Brunoxd23/Flatburn-BR/documentation/static/files/facilitator/workshop_slides.pdf

# City Scanner Workshop

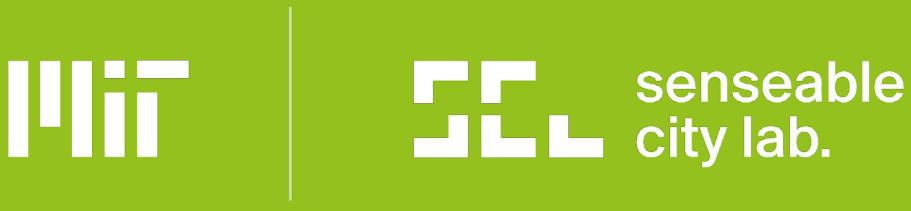
[picture p1: figure]

# Workshop Agenda + Goals

# Agenda

# - CityScanner Recap - Historical + environmental use case context on The Bronx - Analysis + Coding activities

# Goals

# - Understanding hyperlocal air quality sensing - Perform time series + hotspot analysis - Make maps with data

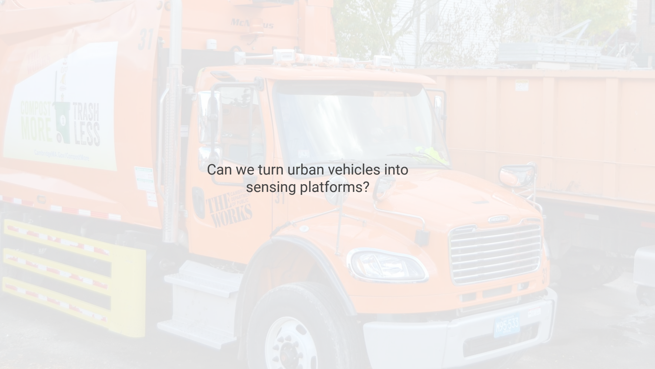
[picture p2: page 3]

# Can we turn urban vehicles into sensing platforms?

# City Scanner

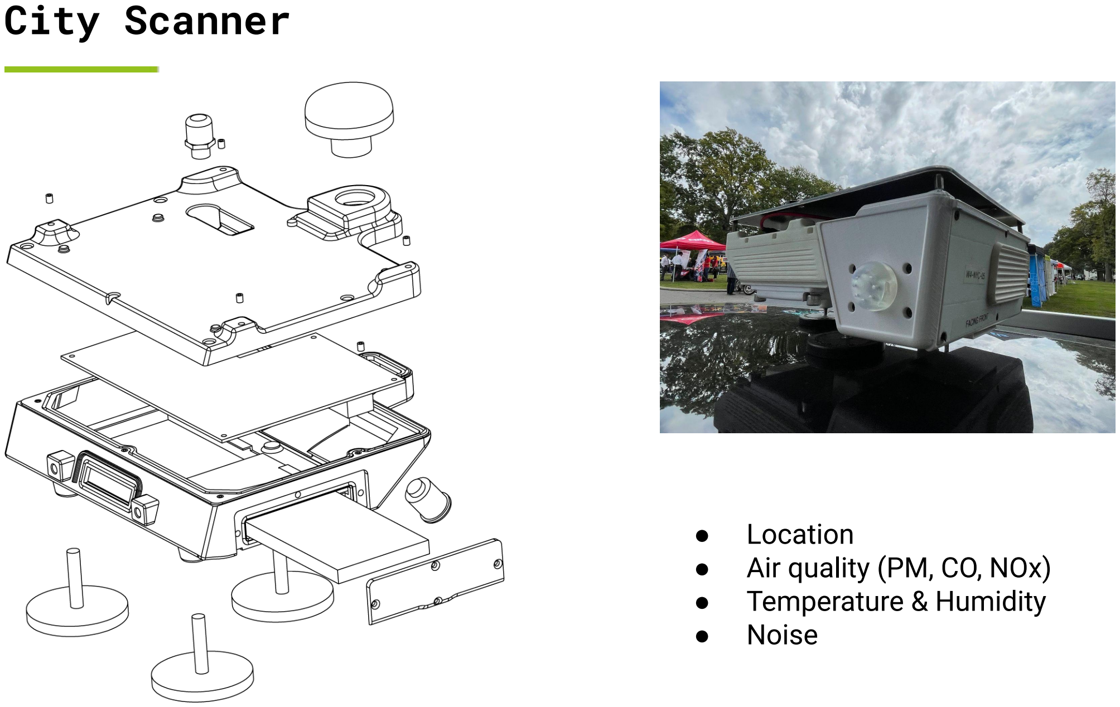
[picture p3: page 4]

# - Location - Air quality (PM, CO, NOx) - Temperature & Humidity - Noise

# Stationary vs. Mobile Sensors

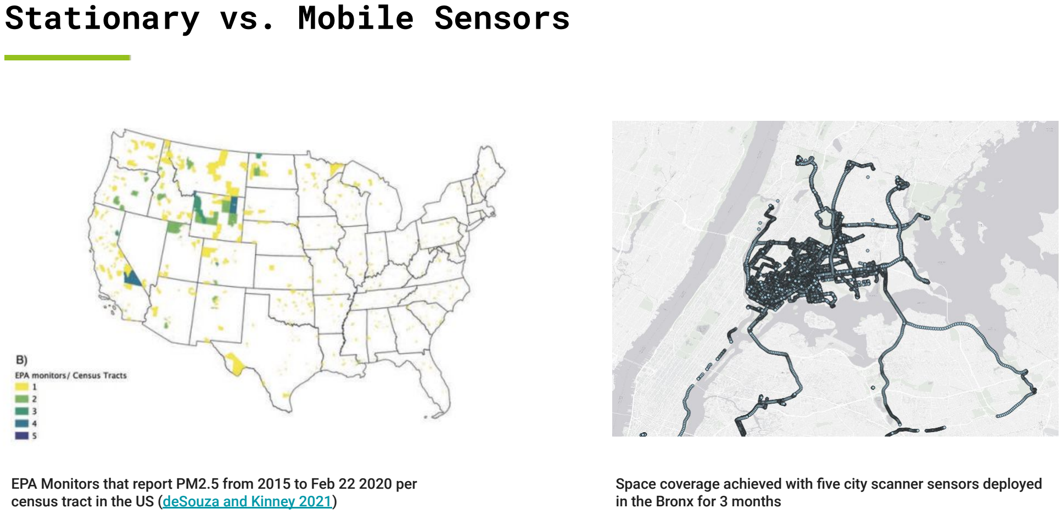
[picture p4: page 5]

## EPA Monitors that report PM2.5 from 2015 to Feb 22 2020 per

census tract in the US (deSouza and Kinney 2021) (https://www.nature.com/articles/s41370-021-00328-2)

## Space coverage achieved with five city scanner sensors deployed in the Bronx for 3 months

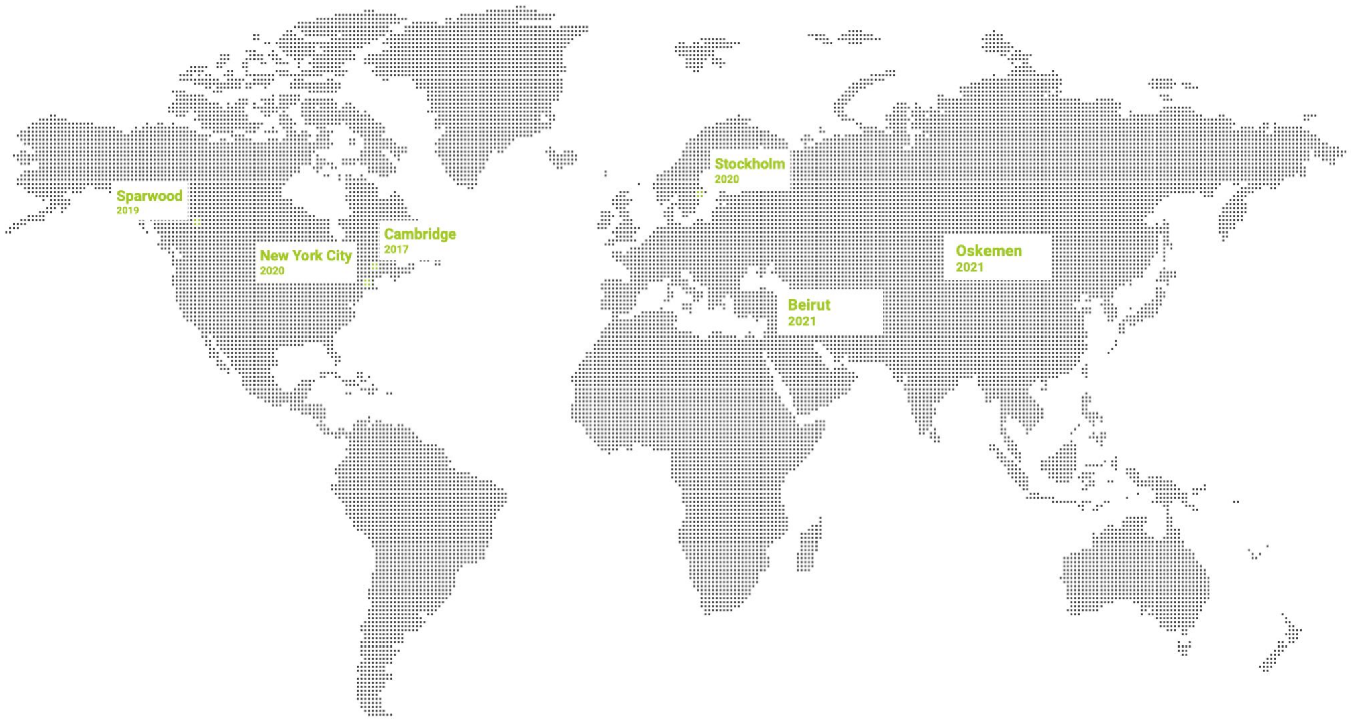
[picture p5: page 6]

# Environmental Sensing

# Context + Background

# ENVIRONMENTAL SENSING 101

# What information can we gather

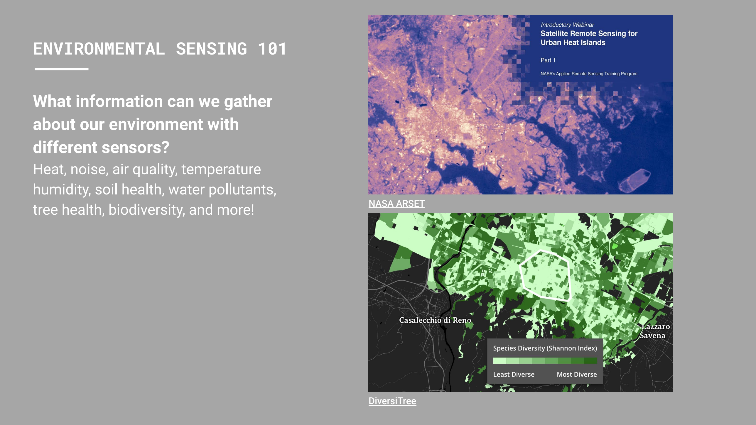
[picture p6: page 8]

# about our environment with different sensors?

# Heat, noise, air quality, temperature

humidity, soil health, water pollutants,
tree health, biodiversity, and more! | NASA ARSET (https://www.youtube.com/watch?v=KYV2j3kwj2A&ab_channel=NASAVideo)

## DiversiTree (https://senseable.mit.edu/diversitree/)

# Environmental Sensing: Heat, Noise, Air Quality

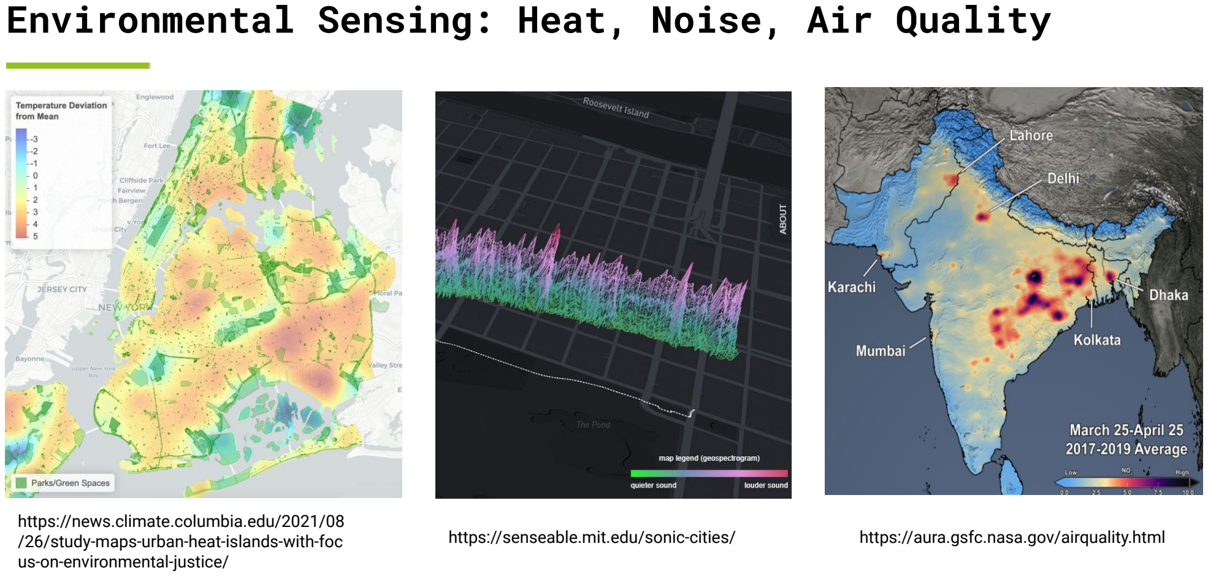
[picture p7: page 9]

## https://news.climate.columbia.edu/2021/08 /26/study-maps-urban-heat-islands-with-foc us-on-environmental-justice/

https://senseable.mit.edu/sonic-cities/ | https://aura.gsfc.nasa.gov/airquality.html

# Air Quality Sensing: Why?

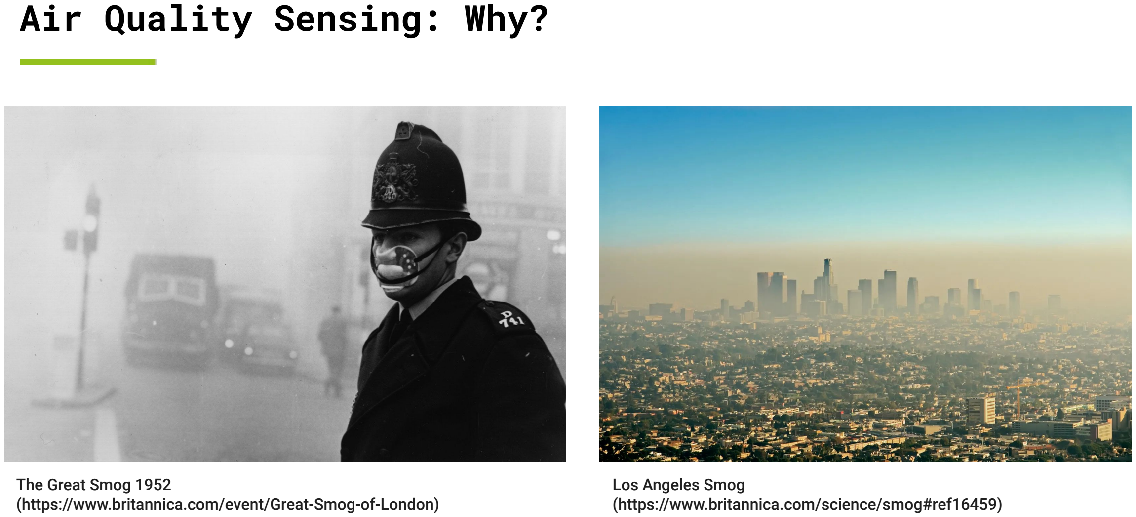
[picture p8: page 10]

## The Great Smog 1952 (https://www.britannica.com/event/Great-Smog-of-London)

## Los Angeles Smog (https://www.britannica.com/science/smog#ref16459)

# Air Quality Sensing: Why?

# 4.2 million per year vs. 6.2 million

# 91% of world population lives in places exceeding WHO AQ Standards

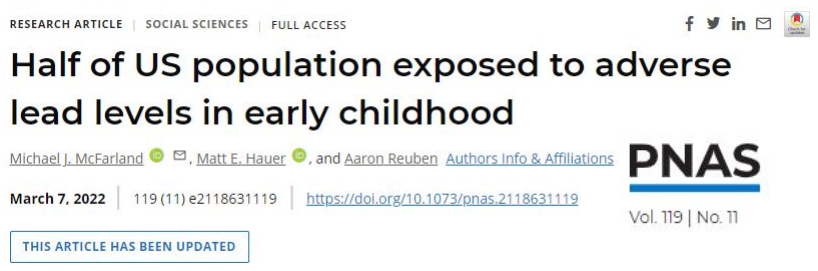
[picture p9: figure]

# Air Quality Index: Pollutants

# Six criteria pollutants regulated by EPA

# - Ground-level ozone - Particulate matter - Carbon monoxide - Lead - Sulfur dioxide - Nitrogen dioxide

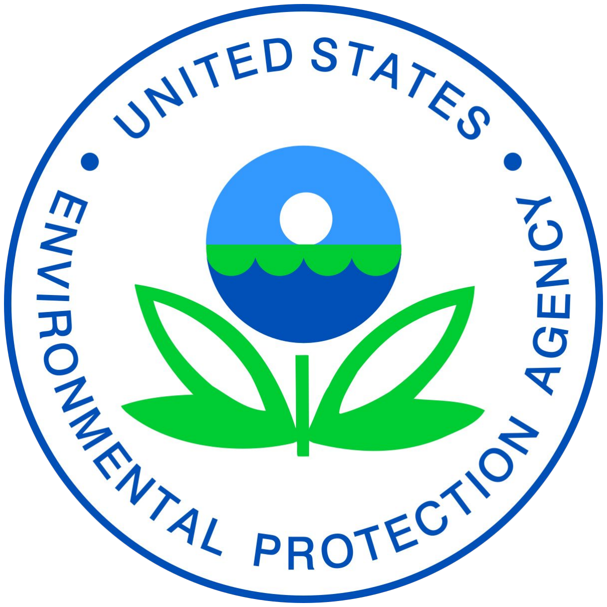
[picture p10: figure]

## United States Environmental Protection Agency (https://www.epa.gov/)

# Air Quality Index: Pollutants

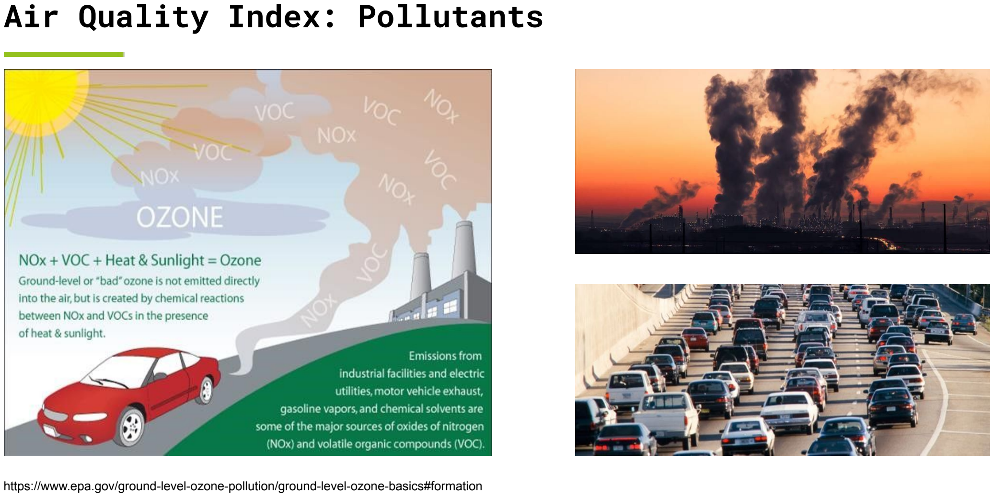
[picture p11: page 13]

### https://www.epa.gov/ground-level-ozone-pollution/ground-level-ozone-basics#formation

# Air Quality Index: PM and NO2

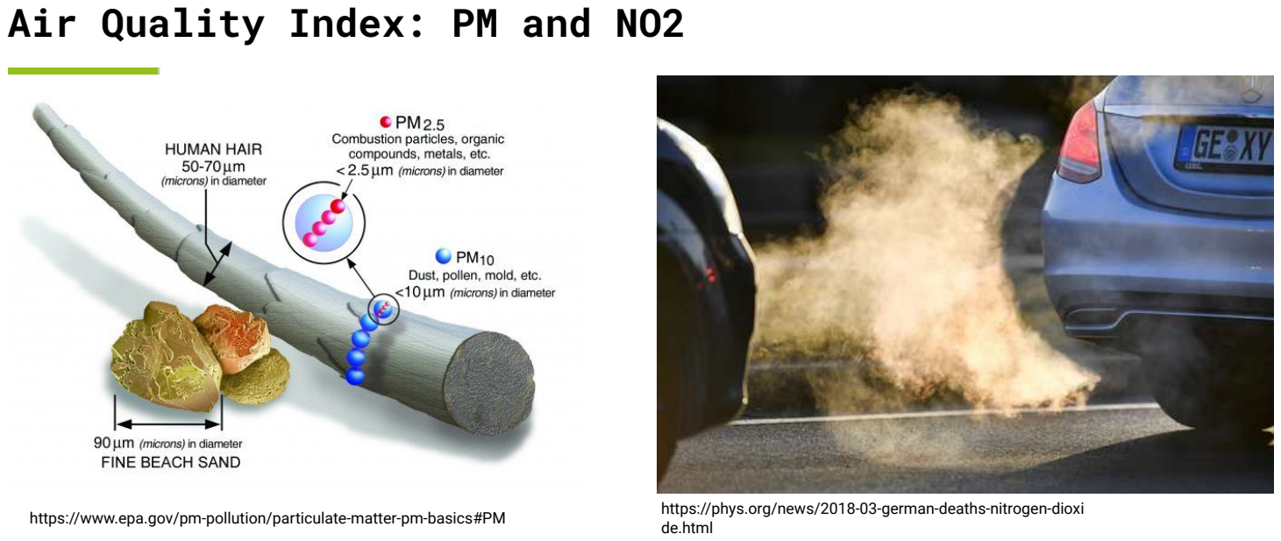
[picture p12: page 14]

https://www.epa.gov/pm-pollution/particulate-matter-pm-basics#PM | https://phys.org/news/2018-03-german-deaths-nitrogen-dioxi de.html

# World Health Organization Guidelines

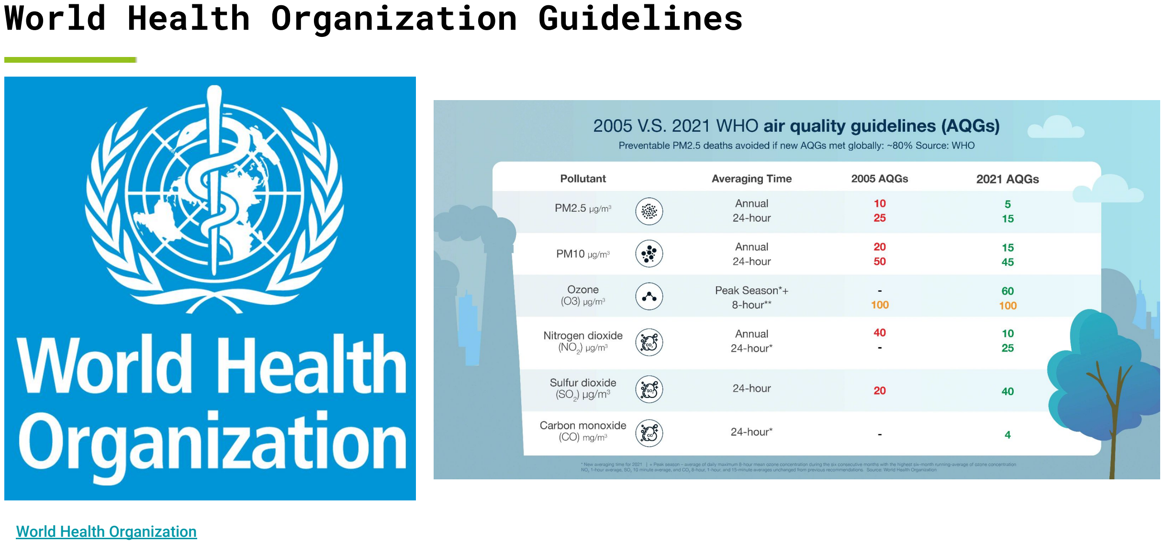
[picture p13: page 15]

## World Health Organization (https://www.who.int/)

# Air Quality Index

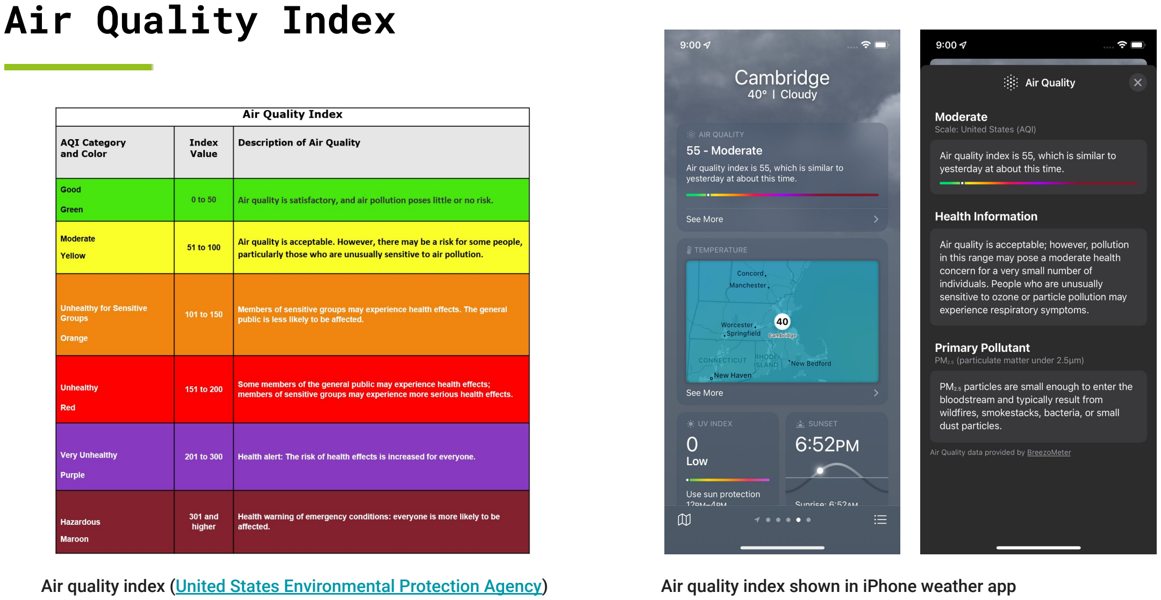
[picture p14: page 16]

Air quality index (United States Environmental Protection Agency) (https://www.epa.gov/wildfire-smoke-course/wildfire-smoke-and-your-patients-health-air-quality-index) | Air quality index shown in iPhone weather app

# The Bronx

# Historical + Environmental Context

# The Bronx: Overview + Demographics

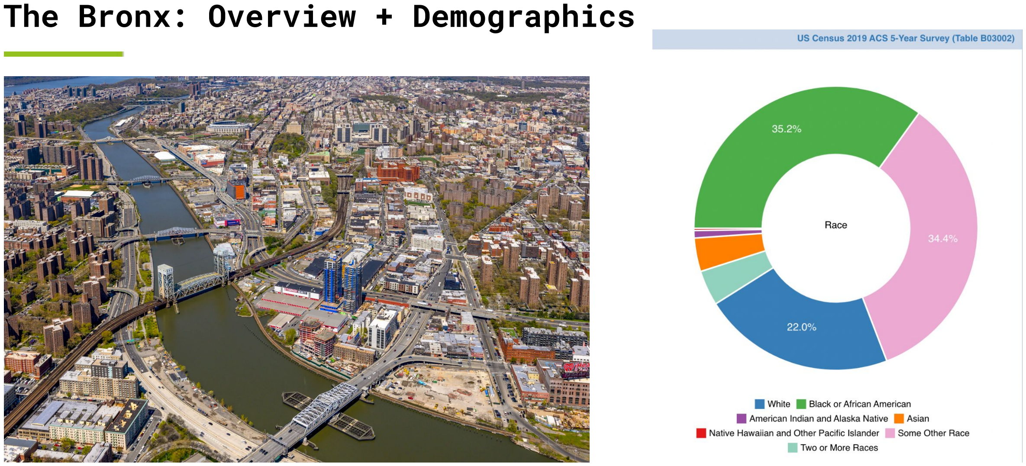
[picture p15: page 18]

# The Bronx: Context

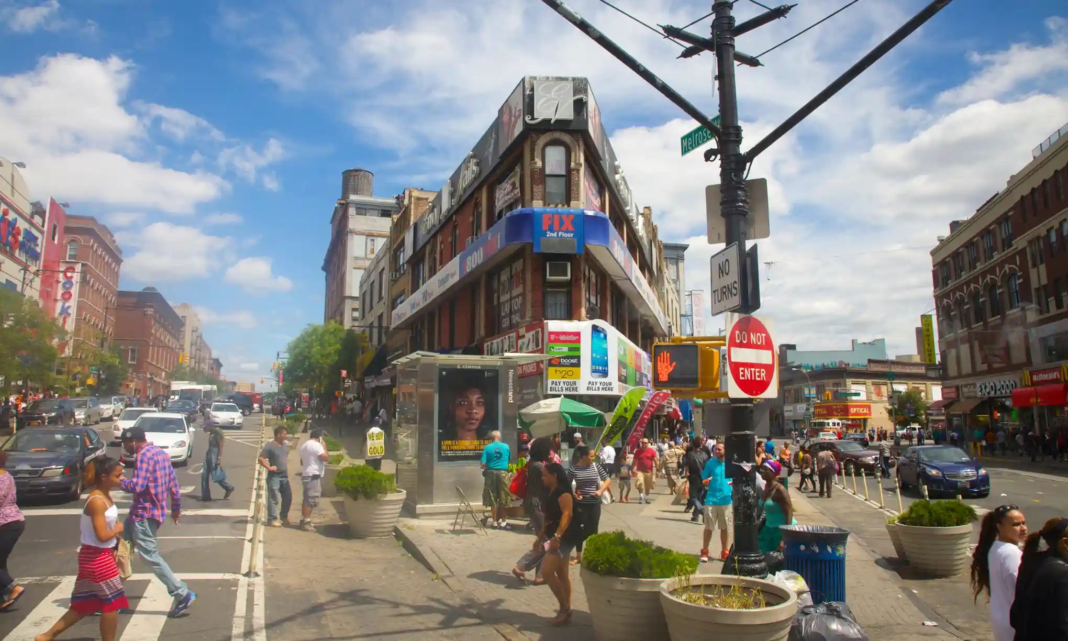
[picture p16: figure]

# The Bronx: Environmental Issues

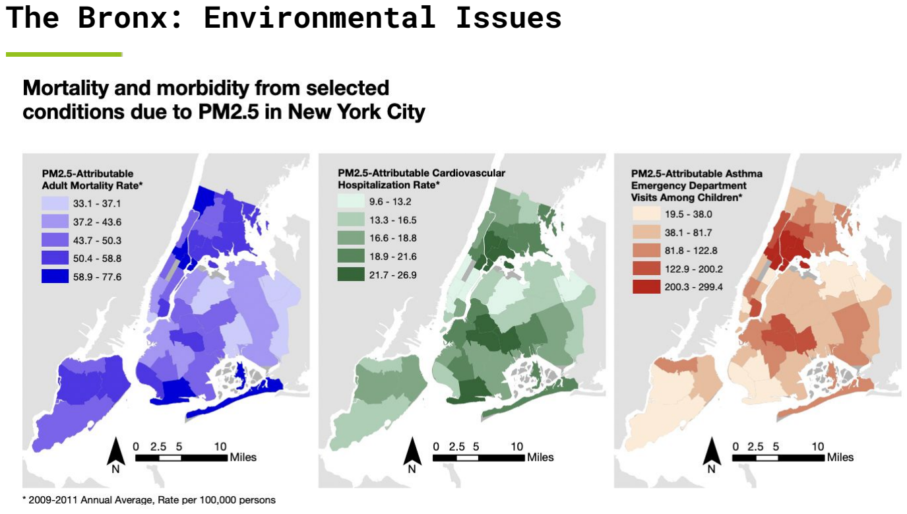
[picture p17: page 20]

# The Bronx: Environmental Issues

# Resources - NYCCAS Data (https://nyc-ehs.net/nyccas2020/web/report#Pollutant_Maps)

- South Bronx Environmental Health and Policy Study (https://www.icisnyu.org/south_bronx/reports.html)
- NYC Environmental and Health Portal (https://a816-dohbesp.nyc.gov/IndicatorPublic/Infographic.aspx)

# - New York Disadvantaged Communities Criteria (https://climate.ny.gov/DAC-Criteria)

- Climate and Economic Justice Screening Tool (https://screeningtool.geoplatform.gov/en/cejst#3/33.47/-97.5)

# - NYC Environmental Justice Alliance (https://nyc-eja.org/)

- NYC Community Health Profiles (https://www1.nyc.gov/site/doh/data/data-publications/profiles.page)
- Potential Environmental Justice Areas in The Bronx (https://portal.nyserda.ny.gov/servlet/servlet.FileDownload?file=00Pt0000005vuDaEAI)

# City Scanner

# Data Collection Pipeline Tour

# CITYSCANNER DATA COLLECTION PIPELINE TOUR

# What does an environmental data collection pipeline look like in practice?

# City Scanner: Data pipeline from hardware assembly to dynamic maps

Assembly | Testing

## Data Acquisition

## Data Validation

4

## Data Analysis

5

# Part 1: Assembly

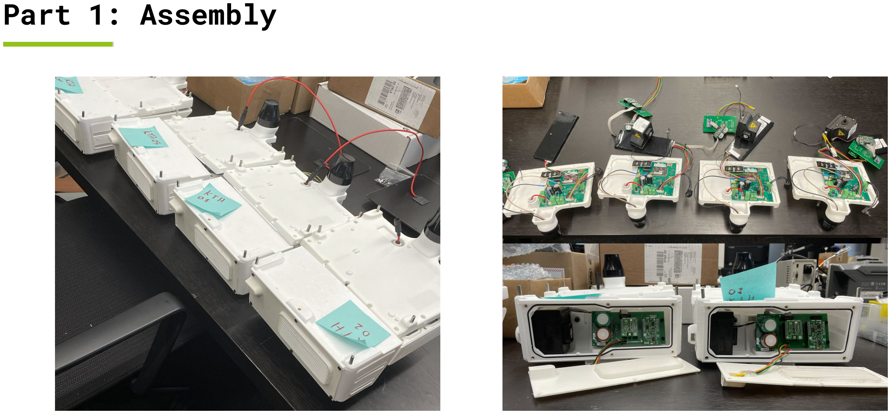
[picture p18: page 24]

# Part 2: Testing

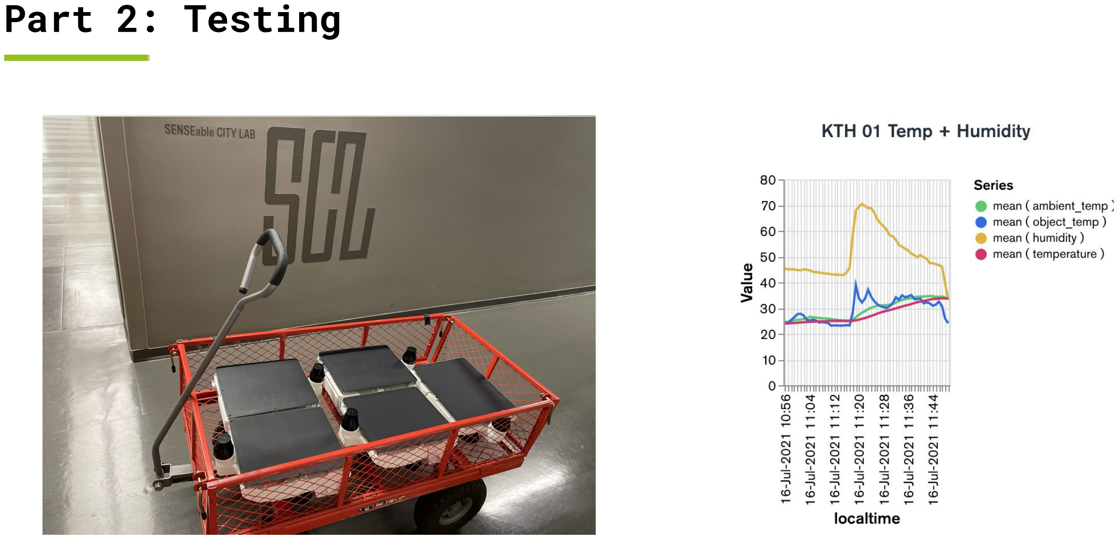
[picture p19: page 25]

# Part 3: Data Acquisition

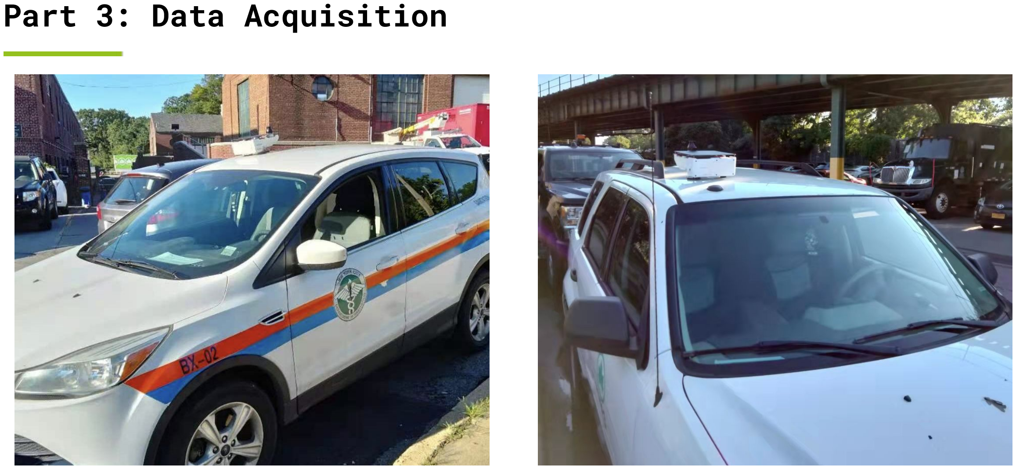
[picture p20: page 26]

# Part 4: Data Validation

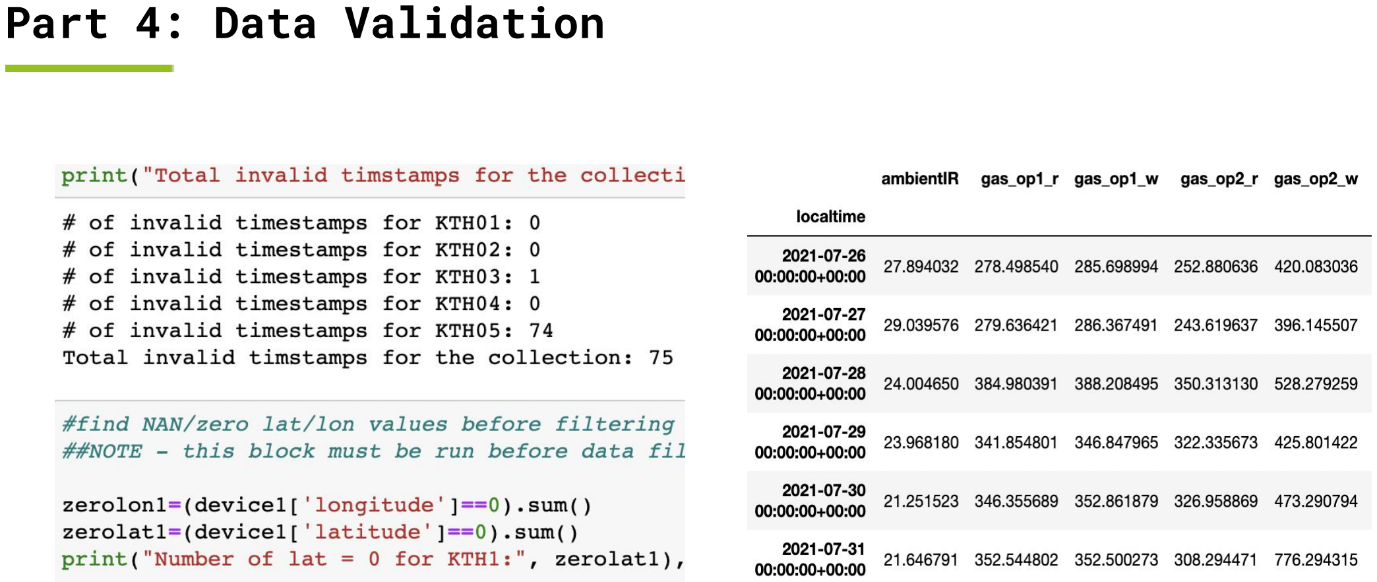
[picture p21: page 27]

# Part 5: Data Analysis

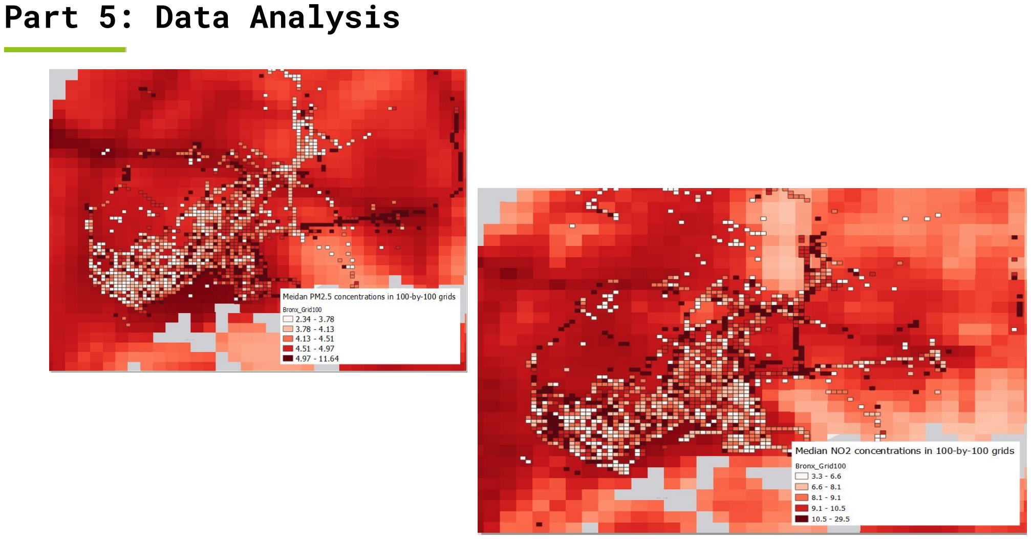
[picture p22: page 28]

# Analysis Method: Colocation + Calibration

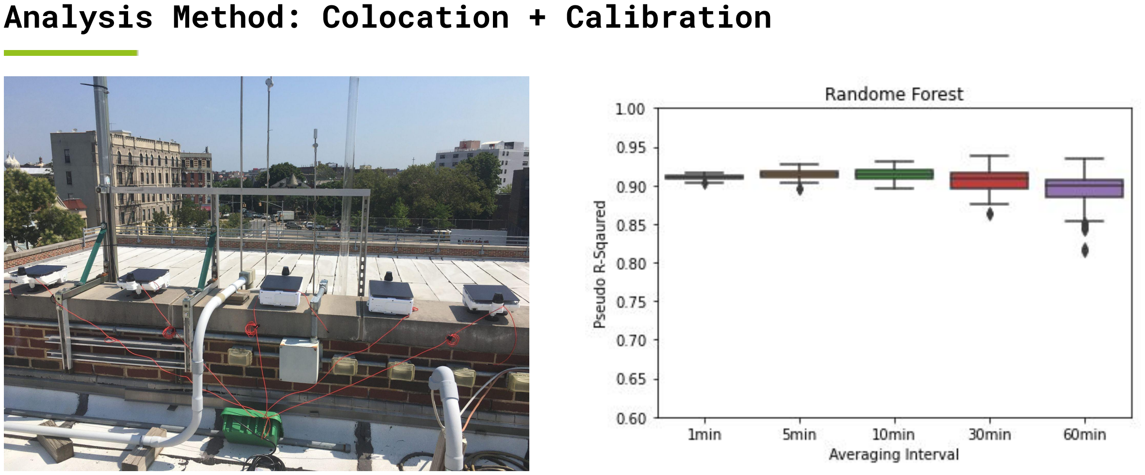
[picture p23: page 29]

# Analysis Method: Colocation + Calibration

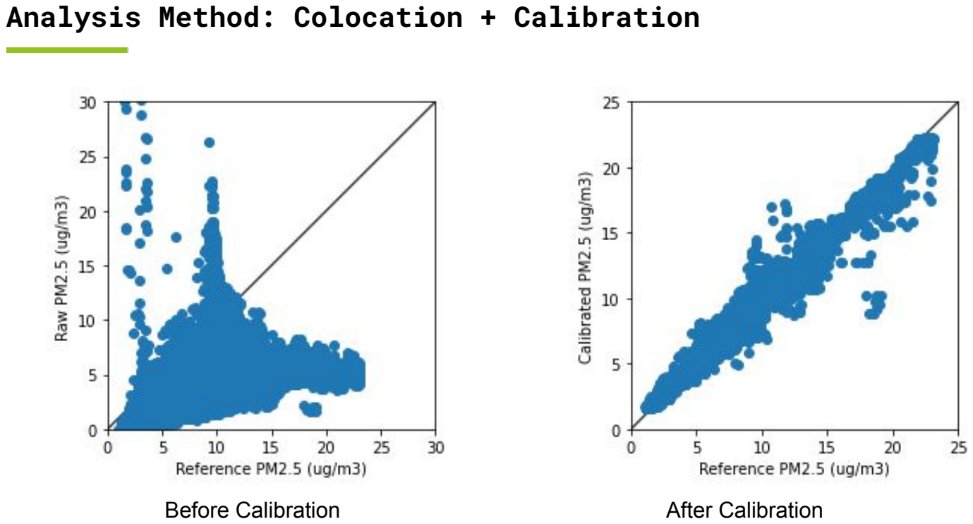
[picture p24: page 30]

Before Calibration | After Calibration

# Validation Method: Background Correction

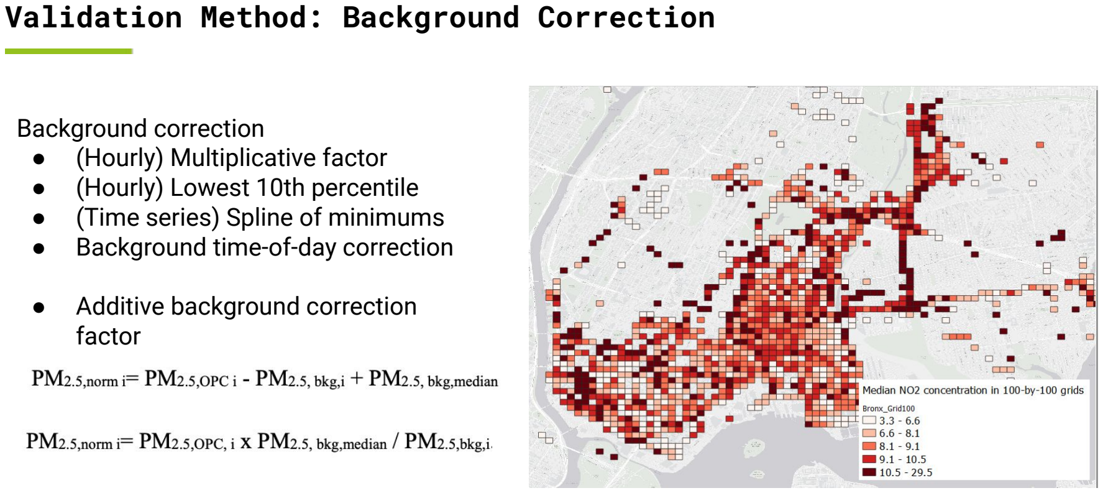
[picture p25: page 31]

# Background correction - (Hourly) Multiplicative factor - (Hourly) Lowest 10th percentile - (Time series) Spline of minimums - Background time-of-day correction

# - Additive background correction factor

# CityScanner 2021 Data

# Bronx 2021 Deployment

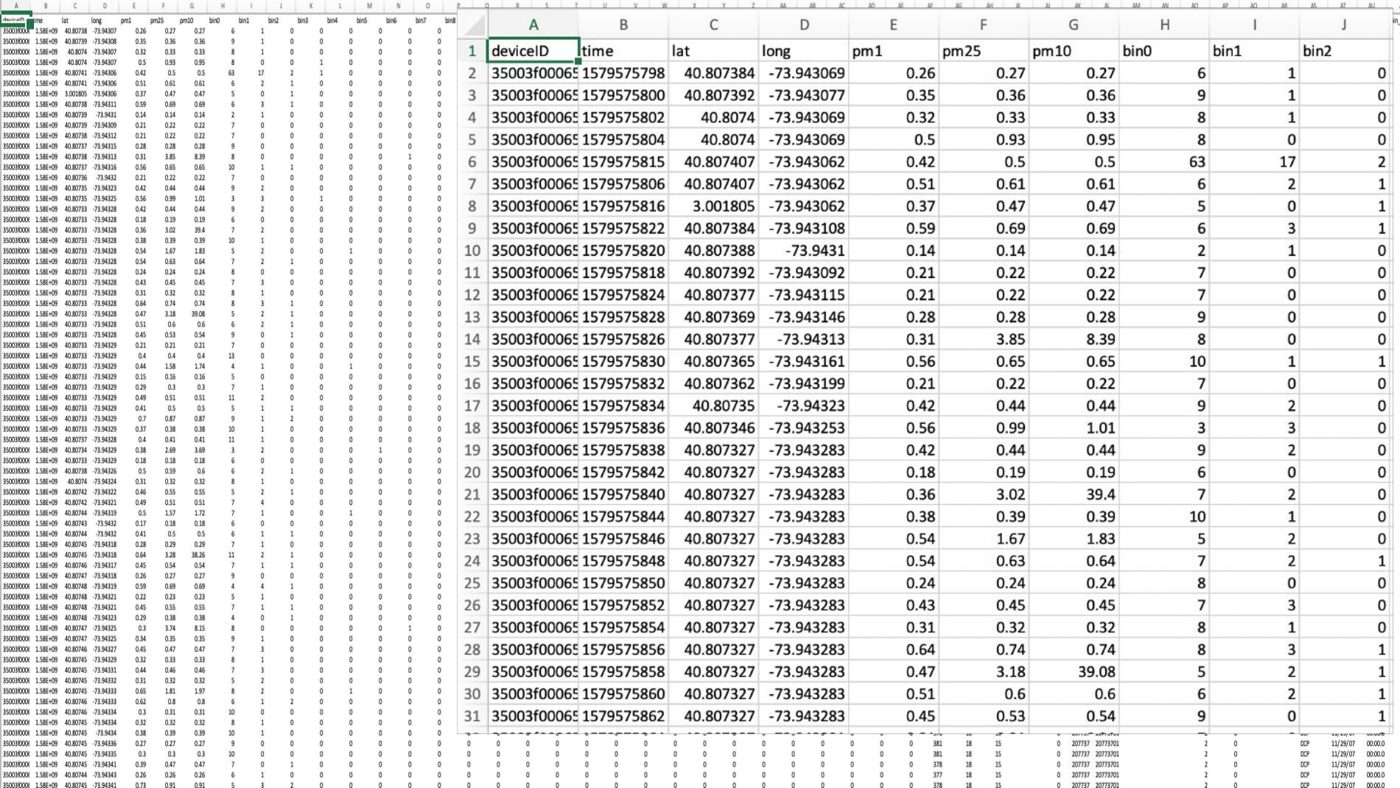
[picture p26: page 33]
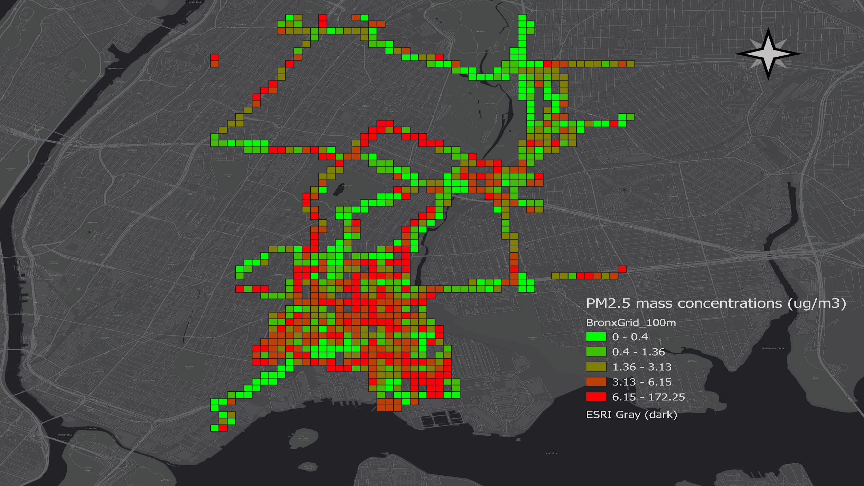
[picture p27: page 34]

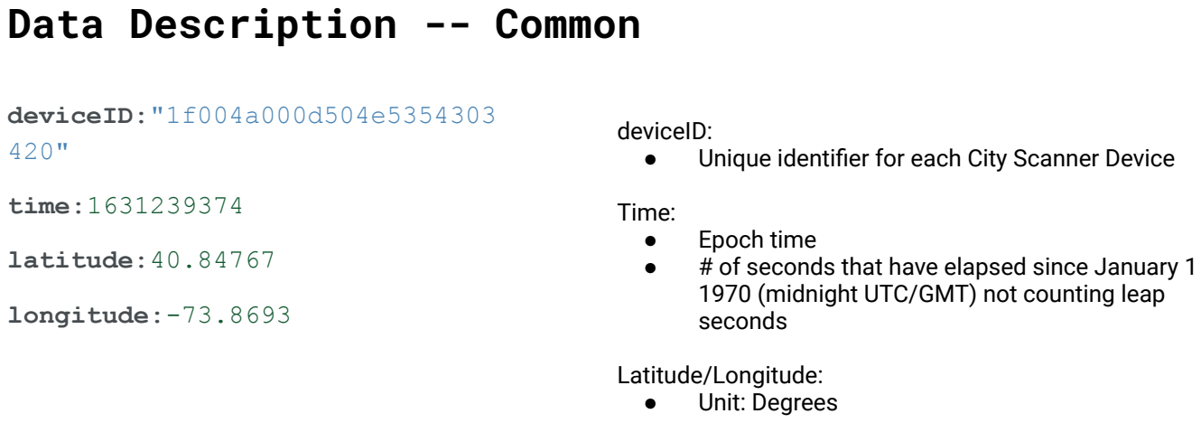
[picture p28: figure]
Data Description -- Common; deviceID:"1f004a000d504e5354303; time:1631239374; latitude:40.84767; longitude:-73.8693; deviceID:; Time: ● Epoch time; seconds; Latitude/Longitude: ● Unit: Degrees

# - Unique identifier for each City Scanner Device

# - # of seconds that have elapsed since January 1 1970 (midnight UTC/GMT) not counting leap

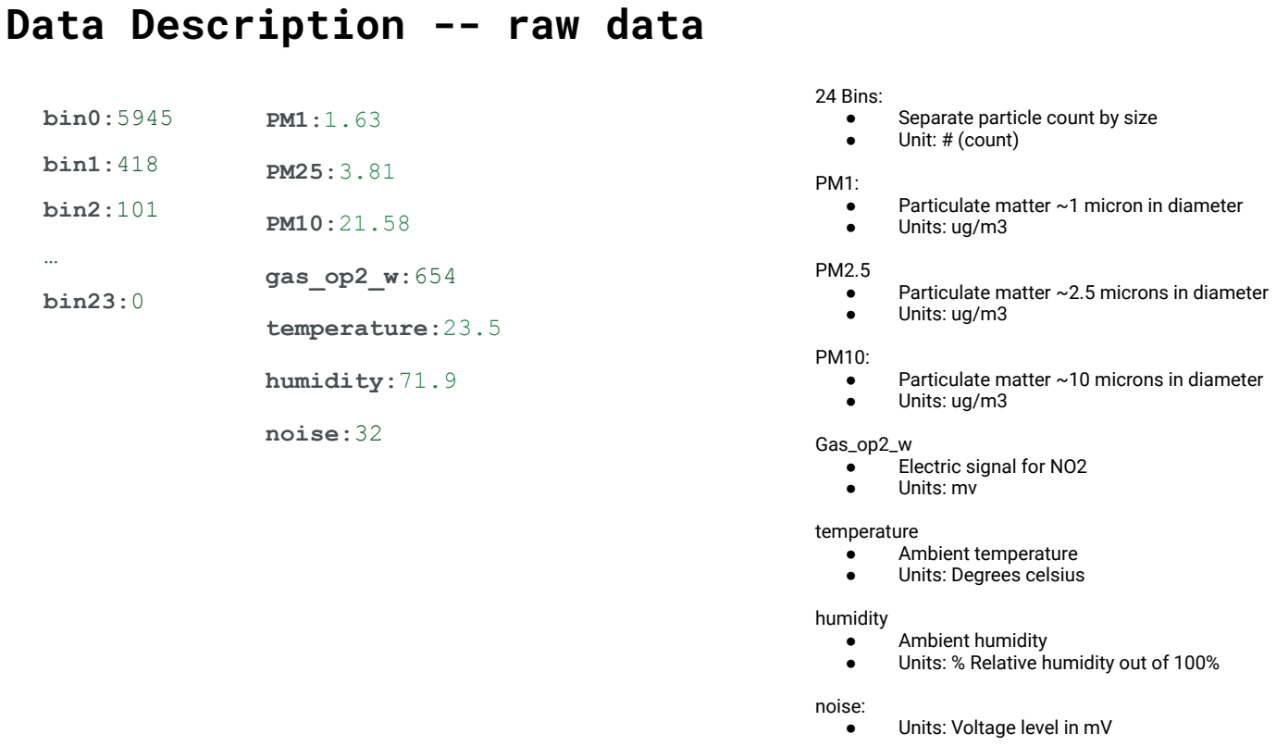
[picture p29: figure]
Data Description -- raw data; bin0:5945; bin1:418; bin2:101; bin23:0; 24 Bins: ● Separate particle count by size ● Unit: # (count); ● Units: ug/m3; Gas_op2_w ● Electric signal for NO2 ● Units: mv; temperature ● Ambient temperature ● Units: Degrees celsius; humidity ● Ambient humidity; noise: ● Units: Voltage level in mV; gas_op2_w:654; temperature:23.5; humidity:71.9; noise:32

## - Particulate matter ~1 micron in diameter

## - Particulate matter ~2.5 microns in diameter

## - Particulate matter ~10 microns in diameter

## - Units: % Relative humidity out of 100%

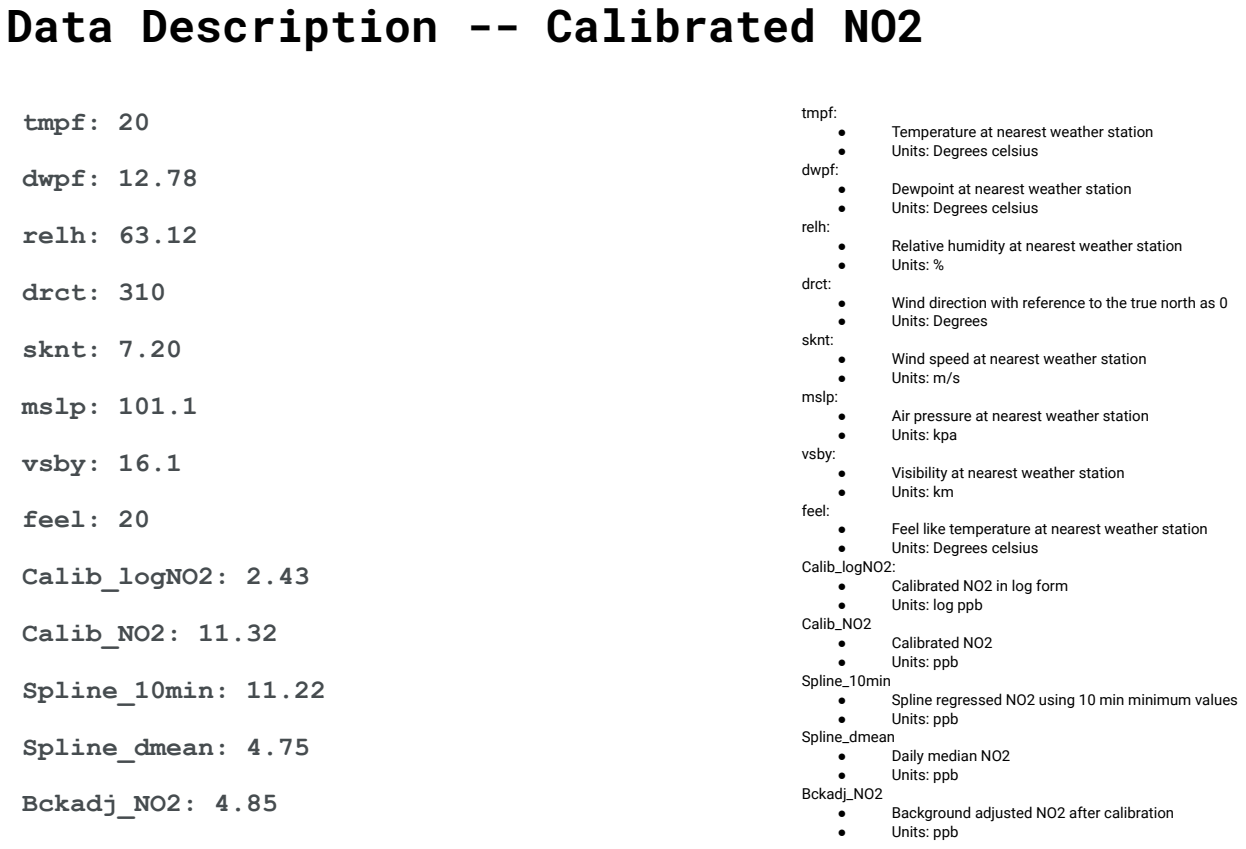
[picture p30: figure]
Data Description -- Calibrated NO2; tmpf: 20; dwpf: 12.78; relh: 63.12; drct:; sknt:; mslp:; vsby:; feel: 20; Calib_logNO2: 2.43; Calib_NO2: 11.32; Spline_10min: 11.22; Spline_dmean: 4.75; Bckadj_NO2: 4.85; tmpf:; ● Units: Degrees celsius dwpf: ● Dewpoint at nearest weather station ● Units: Degrees celsius; relh:; ● Units: %; ● Units: Degrees; ● Wind speed at nearest weather station ● Units: m/s mslp:; ● Units: kpa; ● Visibility at nearest weather station ● Units: km; feel:; ● Units: Degrees celsius Calib_logNO2: ● Calibrated NO2 in log form ● Units: log ppb Calib_NO2 ● Calibrated NO2 ● Units: ppb Spline_10min; ● Units: ppb Spline_dmean ● Daily median NO2 ● Units: ppb Bckadj_NO2; ● Units: ppb

- Temperature at nearest weather station
- Relative humidity at nearest weather station
- Wind direction with reference to the true north as 0
- Air pressure at nearest weather station
- Feel like temperature at nearest weather station
- Spline regressed NO2 using 10 min minimum values
- Background adjusted NO2 after calibration

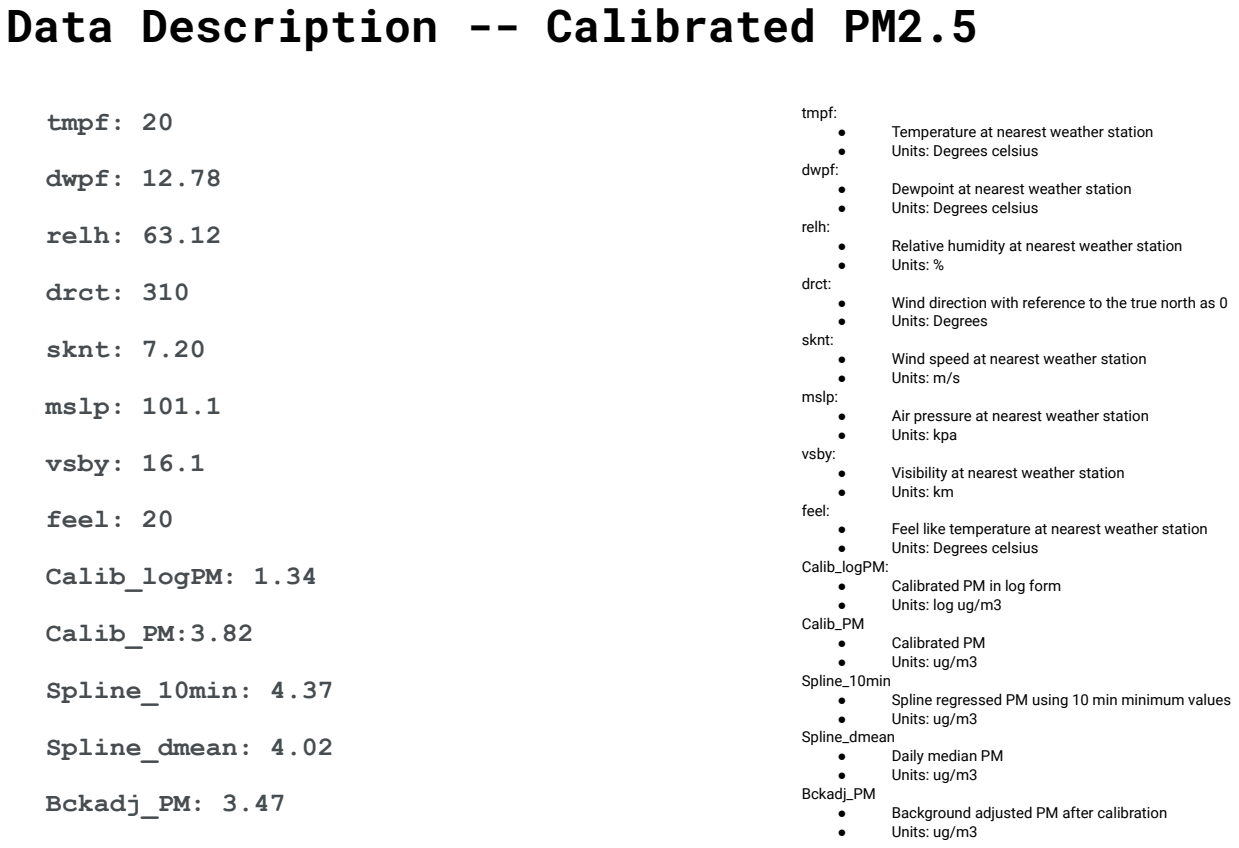
[picture p31: figure]
Data Description -- Calibrated PM2.5; tmpf:; ● Units: Degrees celsius dwpf: ● Dewpoint at nearest weather station ● Units: Degrees celsius; relh:; ● Units: %; drct:; ● Units: Degrees; sknt:; ● Wind speed at nearest weather station ● Units: m/s mslp:; ● Units: kpa; vsby:; ● Visibility at nearest weather station ● Units: km; feel:; ● Units: Degrees celsius Calib_logPM: ● Calibrated PM in log form ● Units: log ug/m3 Calib_PM ● Calibrated PM ● Units: ug/m3 Spline_10min; ● Units: ug/m3 Spline_dmean ● Daily median PM ● Units: ug/m3 Bckadj_PM; ● Units: ug/m3; tmpf: 20; dwpf: 12.78; relh: 63.12; drct: 310; sknt: 7.20; mslp: 101.1; vsby: 16.1; feel: 20; Calib_logPM:; Calib_PM:3.82; Spline_10min: 4.37; Spline_dmean: 4.02; Bckadj_PM: 3.47

- Temperature at nearest weather station
- Relative humidity at nearest weather station
- Wind direction with reference to the true north as 0
- Air pressure at nearest weather station
- Feel like temperature at nearest weather station
- Spline regressed PM using 10 min minimum values
- Background adjusted PM after calibration

# Activity: Methodology

# Understanding Spatial Environmental Patterns

# DATA ANALYSIS METHODS

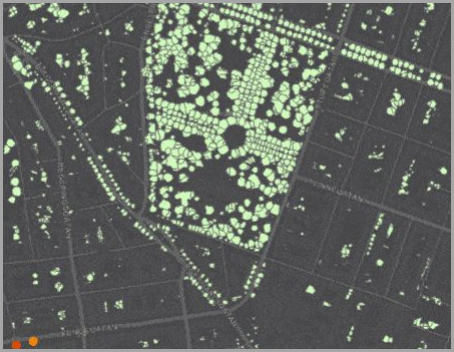
[picture p32: figure]

# How do we understand the insights this data can provide?

# Overview of key CityScanner analysis practices

# Analysis Method: Time Series

# - Parameter as a function of time

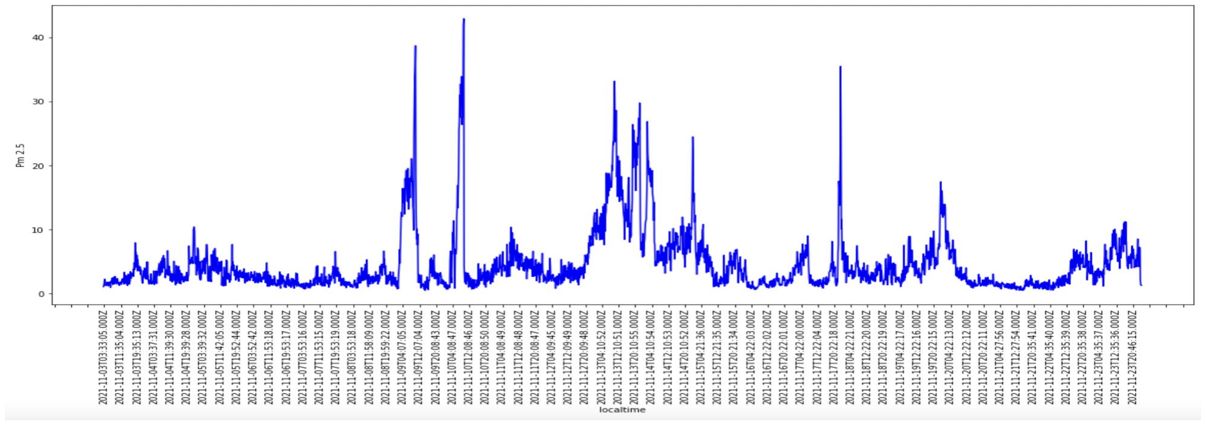
[picture p33: figure]

# Analysis Method: Mapping

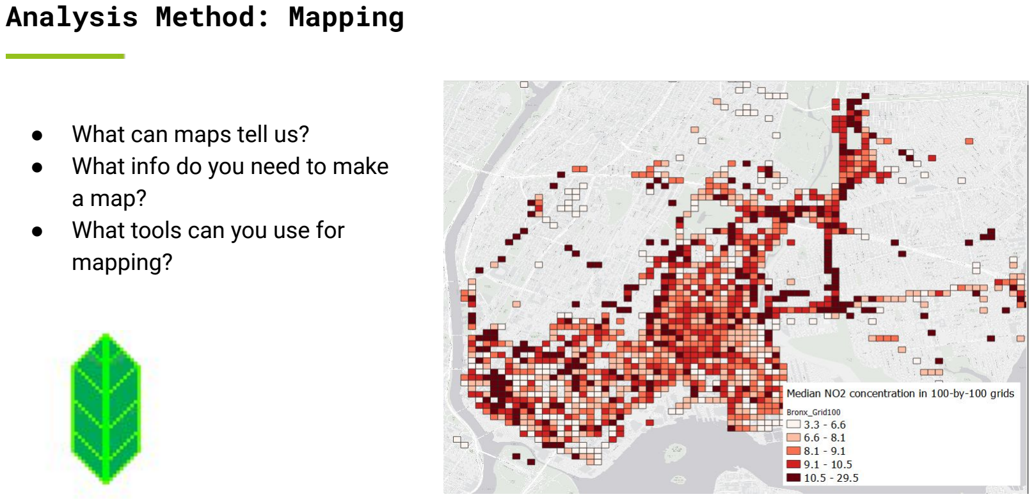
[picture p34: page 42]

# - What can maps tell us? - What info do you need to make a map? - What tools can you use for mapping?

# Analysis Method: Hotspot Detection

"A hot-spot analysis is defined in 40 CFR 93.101 as an estimation of likely future localized

# pollutant concentrations and a comparison of those concentrations to the relevant NAAQS." - United States EPA

# Analysis Method: Hotspot Detection

# Clustering - DBSCAN (from scikit learn)

# - Density-Based Spatial Clustering of Applications with Noise

# - Finds core samples of high density and expands clusters from them

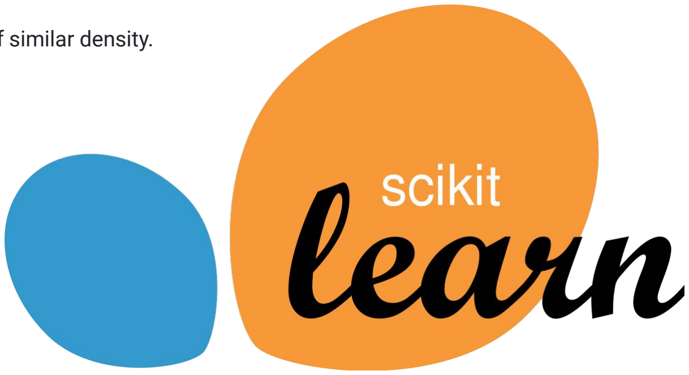
[picture p35: figure]

- Good for data which contains clusters of similar density.

# Analysis Method: Hotspot Detection

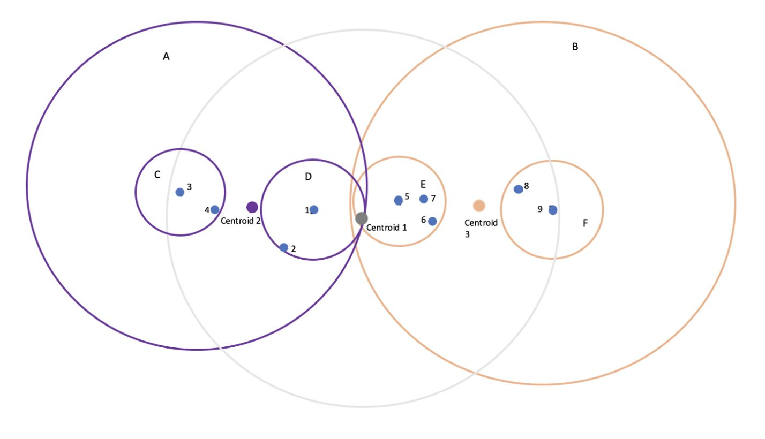
[picture p36: figure]

# Clustering

# - DBSCAN → Ball_tree algorithm

# - Divides groups of points into clusters until desired size is reached

# Analysis Method: Hotspot Detection

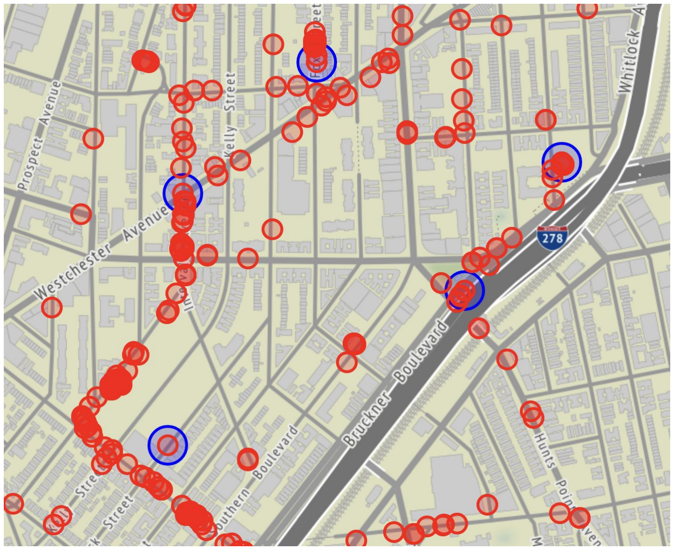
[picture p37: figure]

# Hotspot Detection

# - Bottom-up hierarchical clustering “agglomerative”

# - Merge clusters of data into smaller clusters

# Air Quality API Exercise

# World Air Quality Index API

# Air Quality Index

Air quality index (United States Environmental Protection Agency) (https://www.epa.gov/wildfire-smoke-course/wildfire-smoke-and-your-patients-health-air-quality-index) | Air quality index shown in iPhone weather app

# Accessing (Global) EPA Data

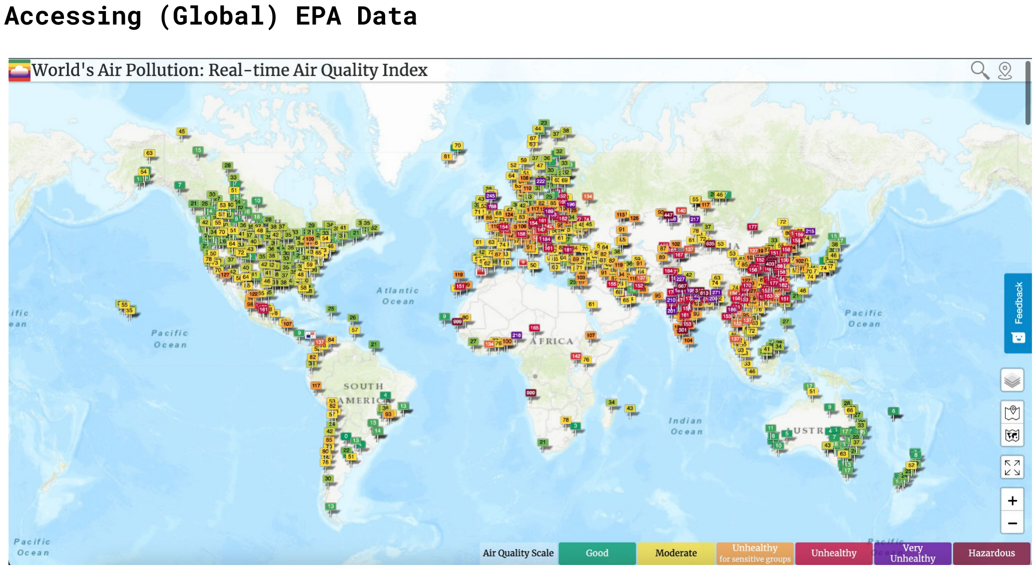
[picture p38: page 49]

# Accessing (Global) EPA Data

# WAQI - Site Link: https://waqi.info/ - API Link: https://aqicn.org/data-platform/token/

# Get API Token: - https://aqicn.org/data-platform/token/

# Notebook Setup: - Python libraries

# Authentication - Input custom token into notebook

# Getting the Data - Run sample code - Modify + experiment!

# Discussion

# Understanding Spatial Environmental Patterns
