Brunoxd23/Flatburn-BR/hardware/electronics/Doc/Flatburn_3D_Models/Flatburn_V5.step

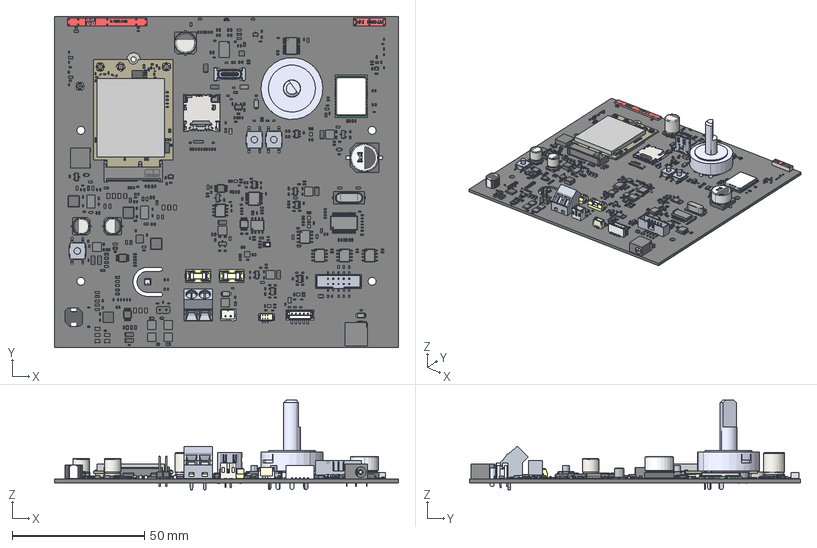
[picture p39: CAD file, 2026-10-01]
hardware/electronics/Doc/Flatburn_3D_Models/Flatburn_V5.step
130.0 x 125.0 x 34.0 mm
D_SOD-523 x 3
C_0402_1005Metric x 109
C_0603_1608Metric x 45
R_0402_1005Metric x 216
SOT-23 x 6
L_0805_2012Metric x 3
R_0603_1608Metric x 18
D_SMF x 3
R_1206_3216Metric x 10
C_0805_2012Metric x 15
pins x 16
FCS0V474ZFTBR24
MOLD
IN-S63TBS5R5G5B x 2
R10307RN02Q_PART1
R10307RN02Q_PART2
R10307RN02Q_PART3
R10307RN02Q_PART4
R10307RN02Q_PART5
R10307RN02Q_PART6
R10307RN02Q_PART7
R10307RN02Q_PART8
R10307RN02Q_PART9
PinsArrayLR x 9
SISS27DN-T1-GE3 x 10
Crystal_SMD_HC49-SD
BODY-SON1 x 6
SOT-323_SC-70 x 2
Board
MFF2
R-0402S x 41
C-0402 x 45
R-0603A
IPEX-20279-001E x 3
C-0402 (1) x 2
R-0603A (1) x 2
R-0402S (1) x 2
CASE-B
CASE-A
C0201-S x 3
C0402 x 2
SOD-323
SC70-5
L_0603_1608Metric
NN02-224--3DModel-STEP-418109
CP_Elec_6.3x7.7 x 2
Flatburn_V5 1.123
U.FL-R-SMT-1_10_
CMM-2718AT-42316-TR
MSOP-10_3x3mm_P0.5mm x 3
0154.315DR x 2
L_Coilcraft_XAL4020-XXX x 3
BME280--3DModel-STEP-56544
BxB-ZR-SM4_5
BxB-ZR-SM4 pins_5
SOT-23-5 x 6
DM3CS-SF
PinHeader_1x02_P2.54mm_Vertical
TPS25730DREFR
NN03-310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
