Brunoxd23/Flatburn-BR/hardware/enclosure/step/mechanics/fixation/MF-03 insert_m3.stp

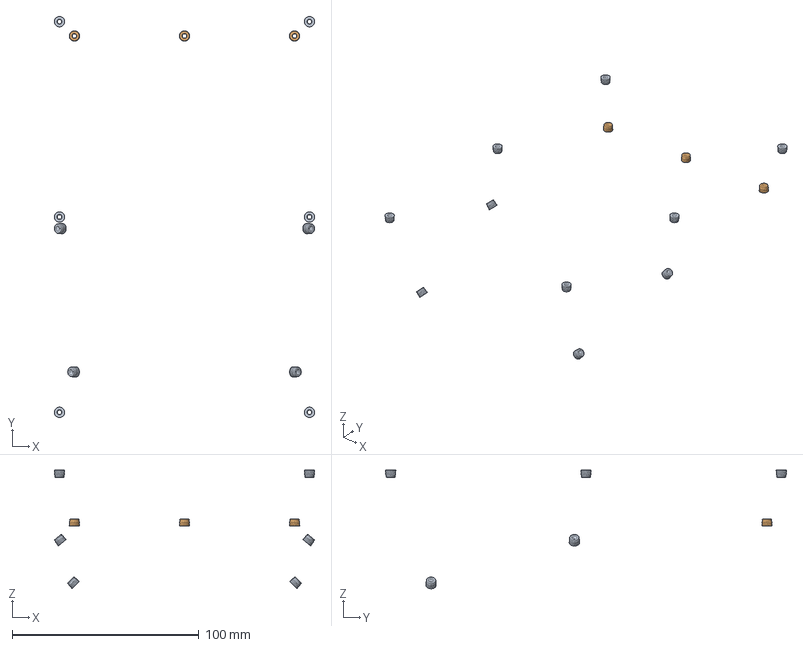
[picture p40: CAD file, 2026-10-01]
hardware/enclosure/step/mechanics/fixation/MF-03 insert_m3.stp
139.6 x 214.9 x 63.6 mm
