Brunoxd23/Flatburn-BR/hardware/enclosure/stl/MP-02 middle.stl

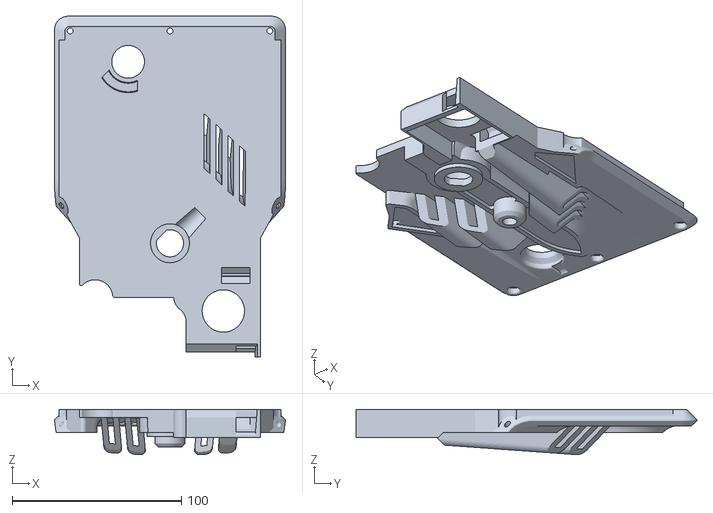
[picture p41: CAD file, 2026-10-01]
hardware/enclosure/stl/MP-02 middle.stl
136.6 x 201.5 x 26.8
