Brunoxd23/Flatburn-BR/hardware/enclosure/step/mechanics/fixation/MF-01 insert_1_4_.stp

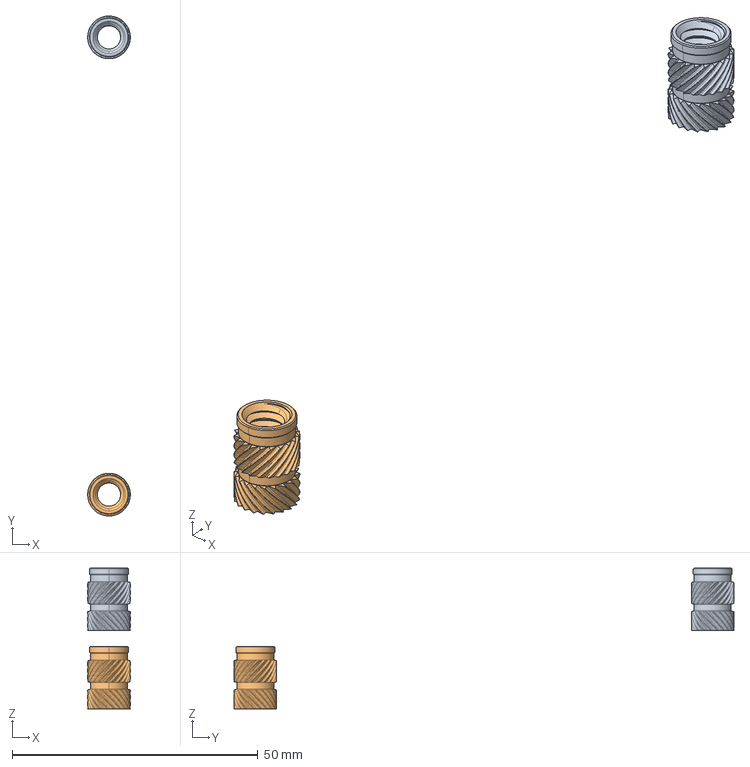
[picture p42: CAD file, 2026-10-01]
hardware/enclosure/step/mechanics/fixation/MF-01 insert_1_4_.stp
8.69 x 101.7 x 28.6 mm
