Brunoxd23/Flatburn-BR/hardware/enclosure/stl/MP-01 top.stl

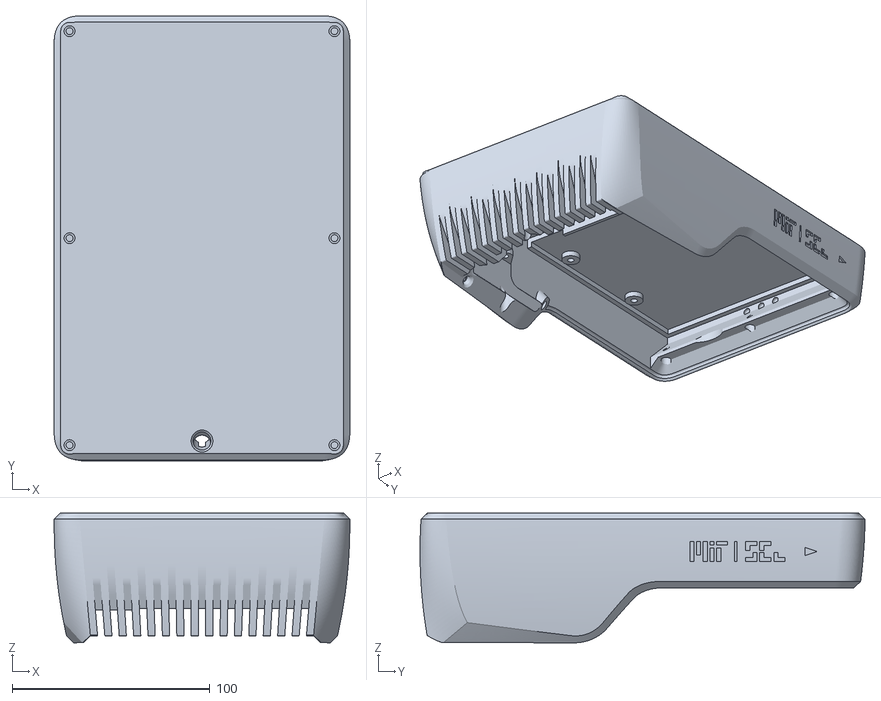
[picture p43: CAD file, 2026-10-01]
hardware/enclosure/stl/MP-01 top.stl
149.5 x 225.1 x 65.6
