Brunoxd23/Flatburn-BR/hardware/enclosure/stl/MP-03 bottom.stl

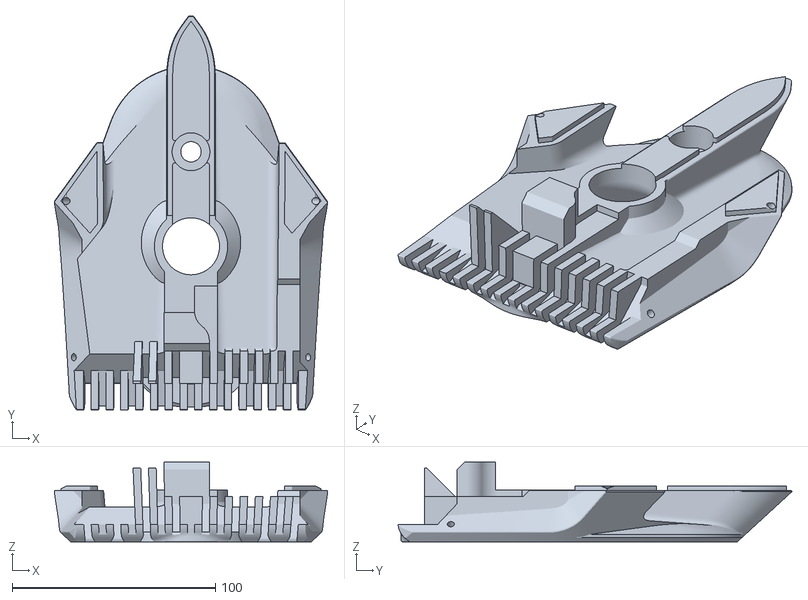
[picture p44: CAD file, 2026-10-01]
hardware/enclosure/stl/MP-03 bottom.stl
134.5 x 193.8 x 39.2
