Brunoxd23/Flatburn-BR/hardware/electronics/Doc/Flatburn_V5_layout.pdf

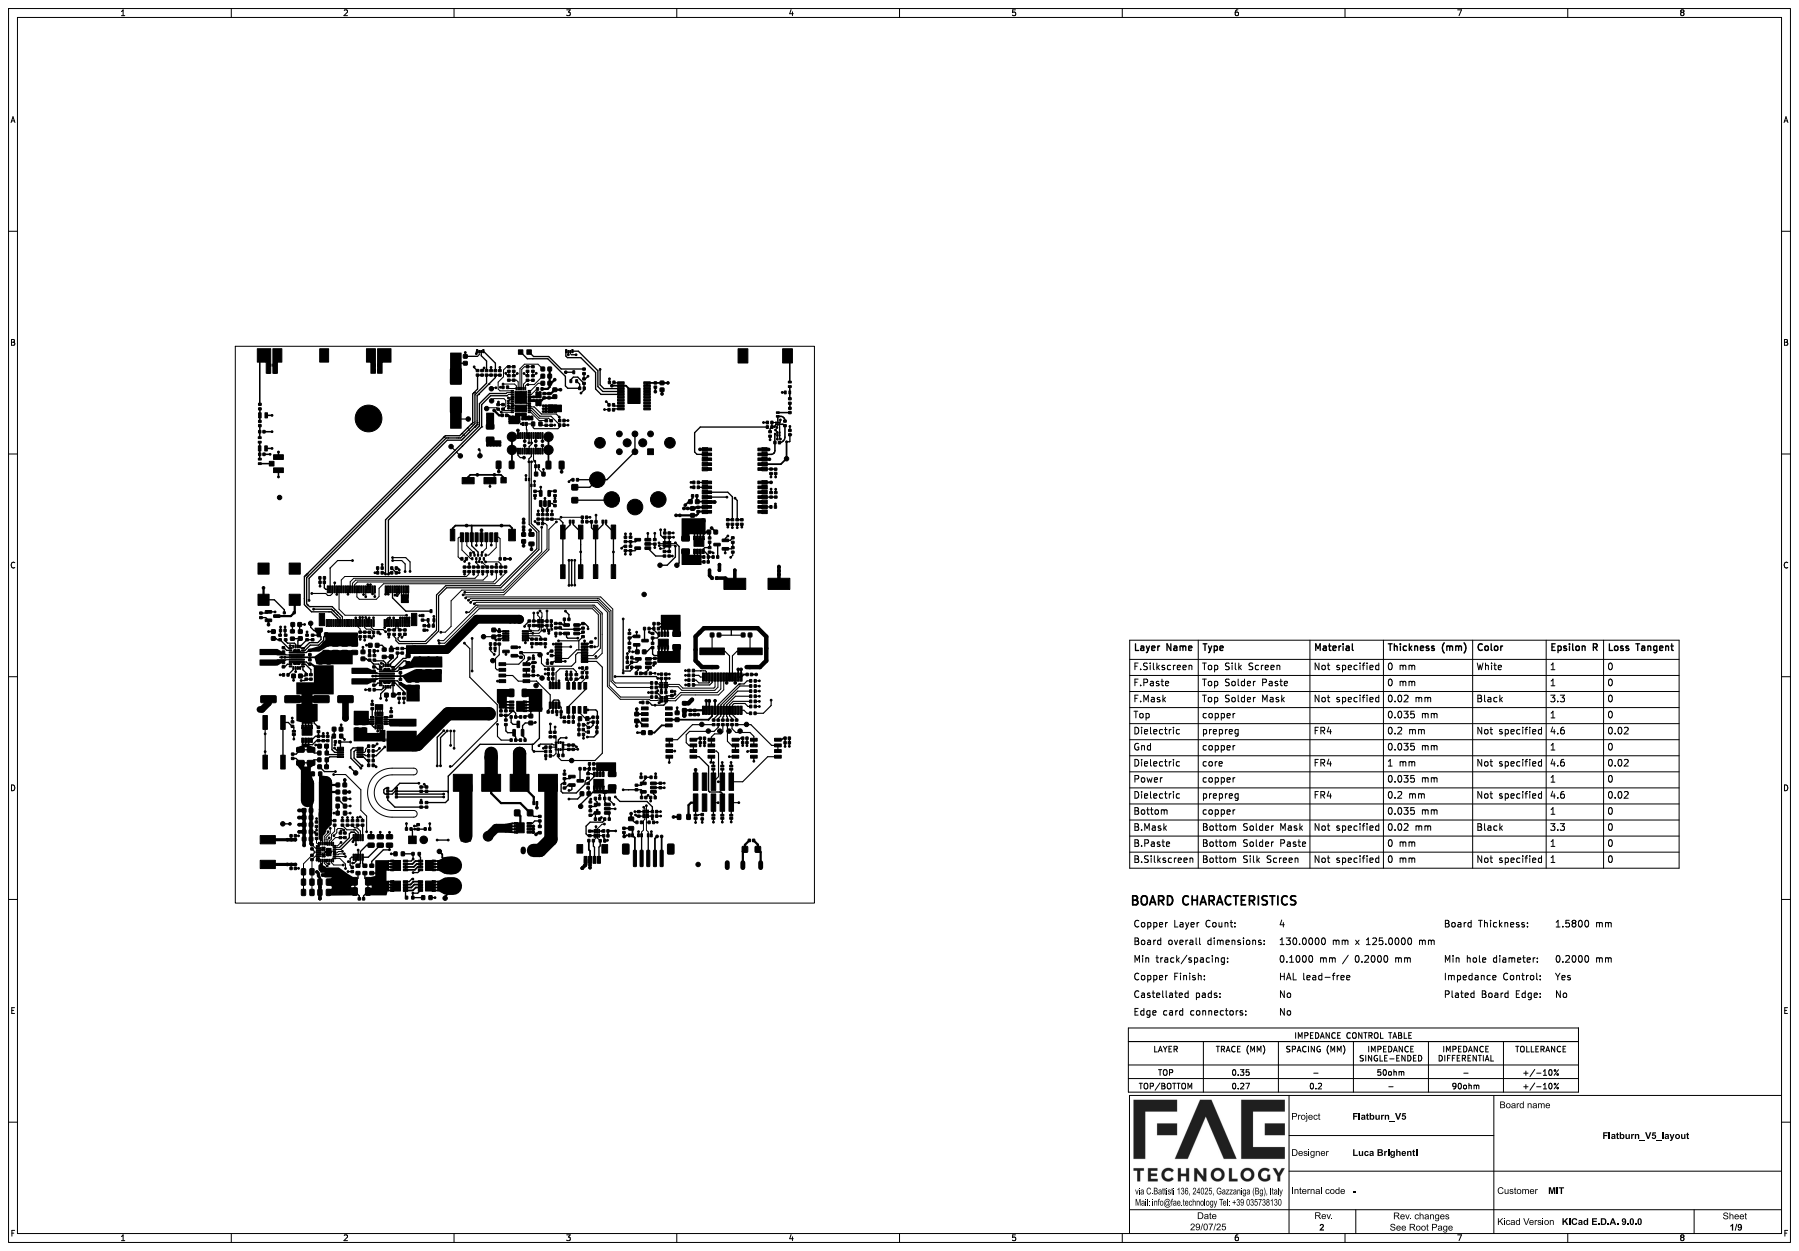
[picture p45: page 1]

0.02 Bottom Solder Mask prepreg

Top Silk Screen
Copper Layer Count: Top

Not specified

Bottom Solder Paste No No

Project via C.Battisti 136, 24025, Gazzaniga (Bg), Italy

Mail: info@fae.technology Tel: +39 035738130

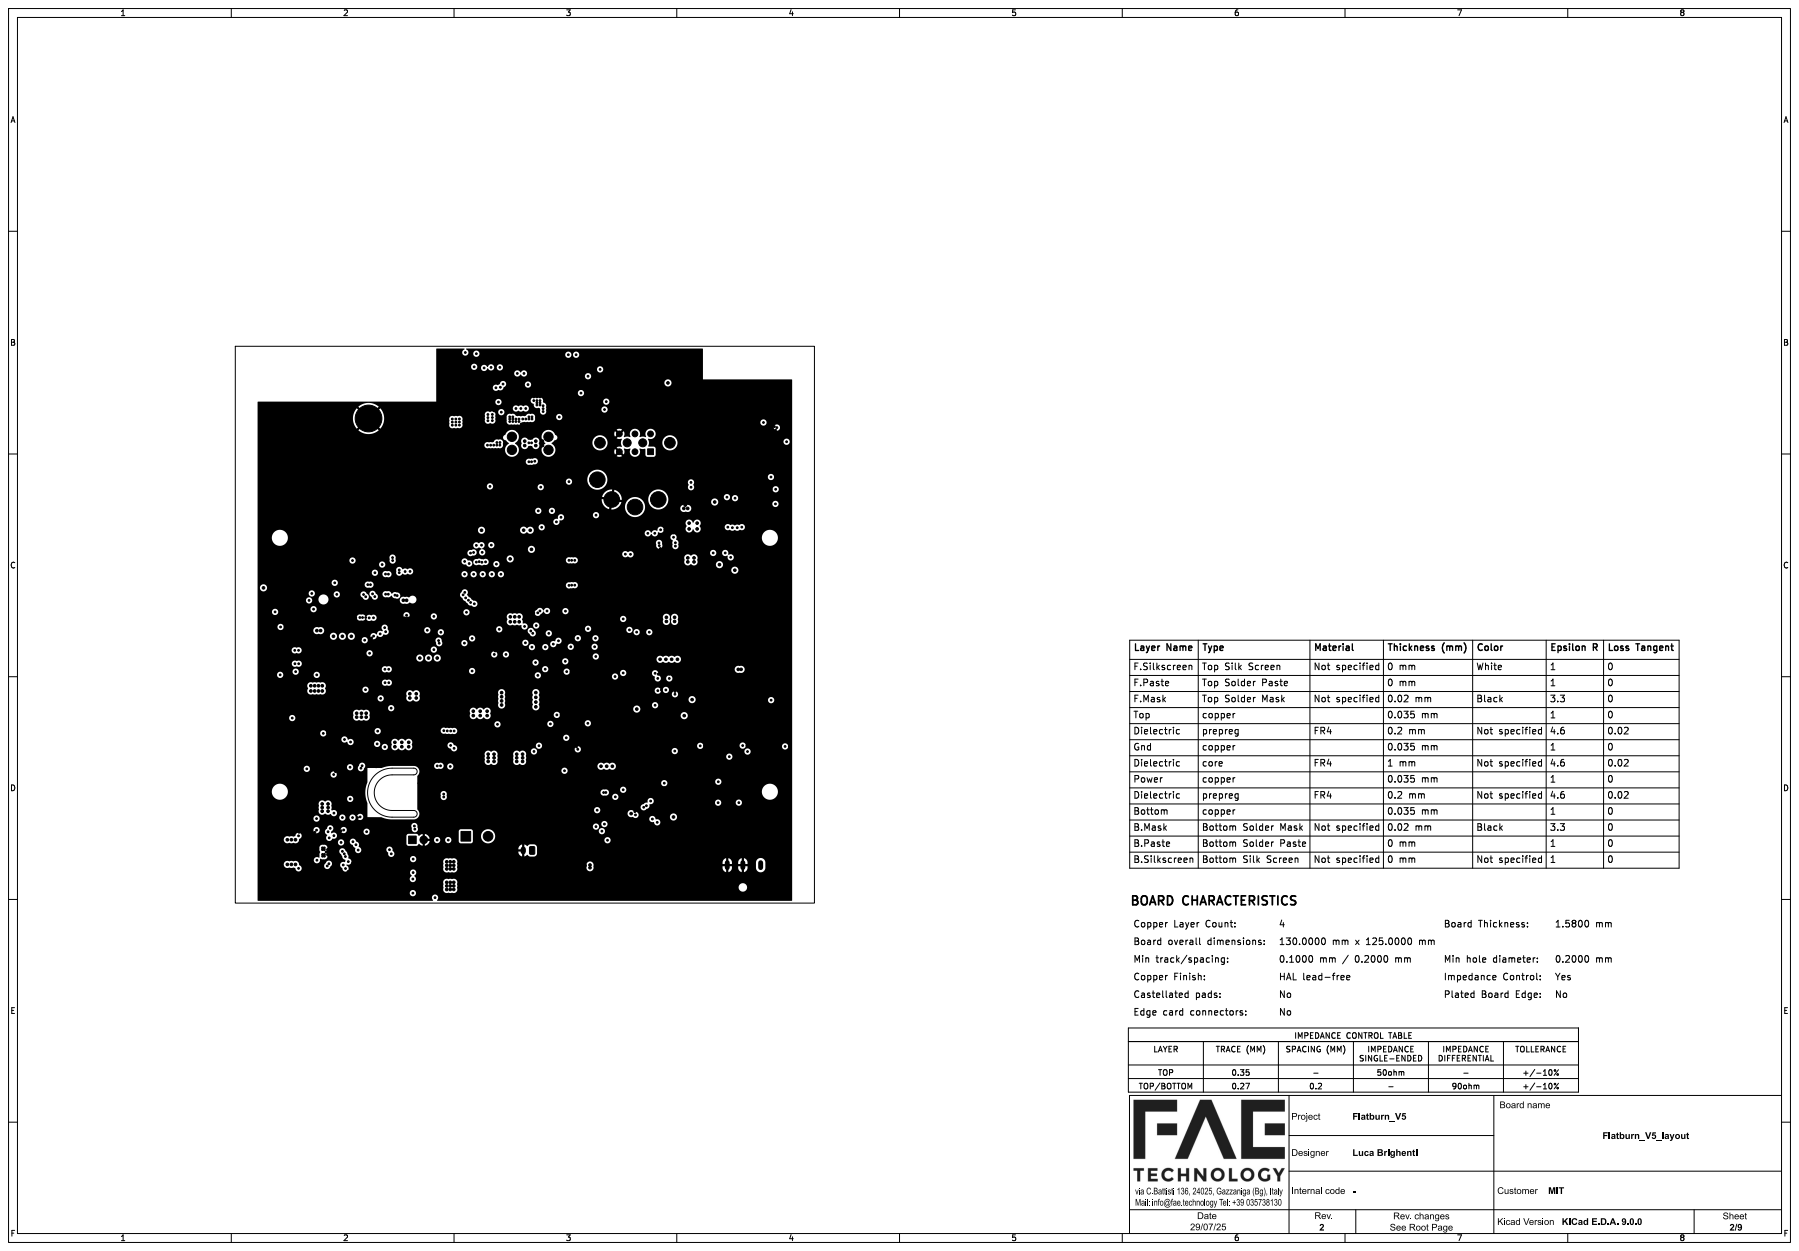
[picture p46: page 2]

Layer Name | | copper | | | | | FR4 Not specified | 0 mm 0.035 mm | Color Top Solder Paste Not specified F.Silkscreen Not specified Not specified

Gnd | Top Solder Mask Screen copper | | 0.2 mm | Black | 1.5800 mm 4.6 F.Paste B.Silkscreen | 0 F.Mask 0 Material 0 Not specified B.Mask 0.02 Dielectric 0 Bottom Silk 0 Not specified

prepreg | | | | | | 0.02 mm | White | Epsilon R 3.3
Copper Layer Count: Top | | | | | 1

Dielectric Power | core | FR4 | 0 mm 0.035 mm 0.035 mm 1 mm | | 1 Dielectric 4.6 | 0 B.Paste 0 Bottom 0.02 Bottom Solder Mask prepreg

0.035 mm | | | 0
0.02 mm | | 3.3

Bottom Solder Paste No No

Project via C.Battisti 136, 24025, Gazzaniga (Bg), Italy

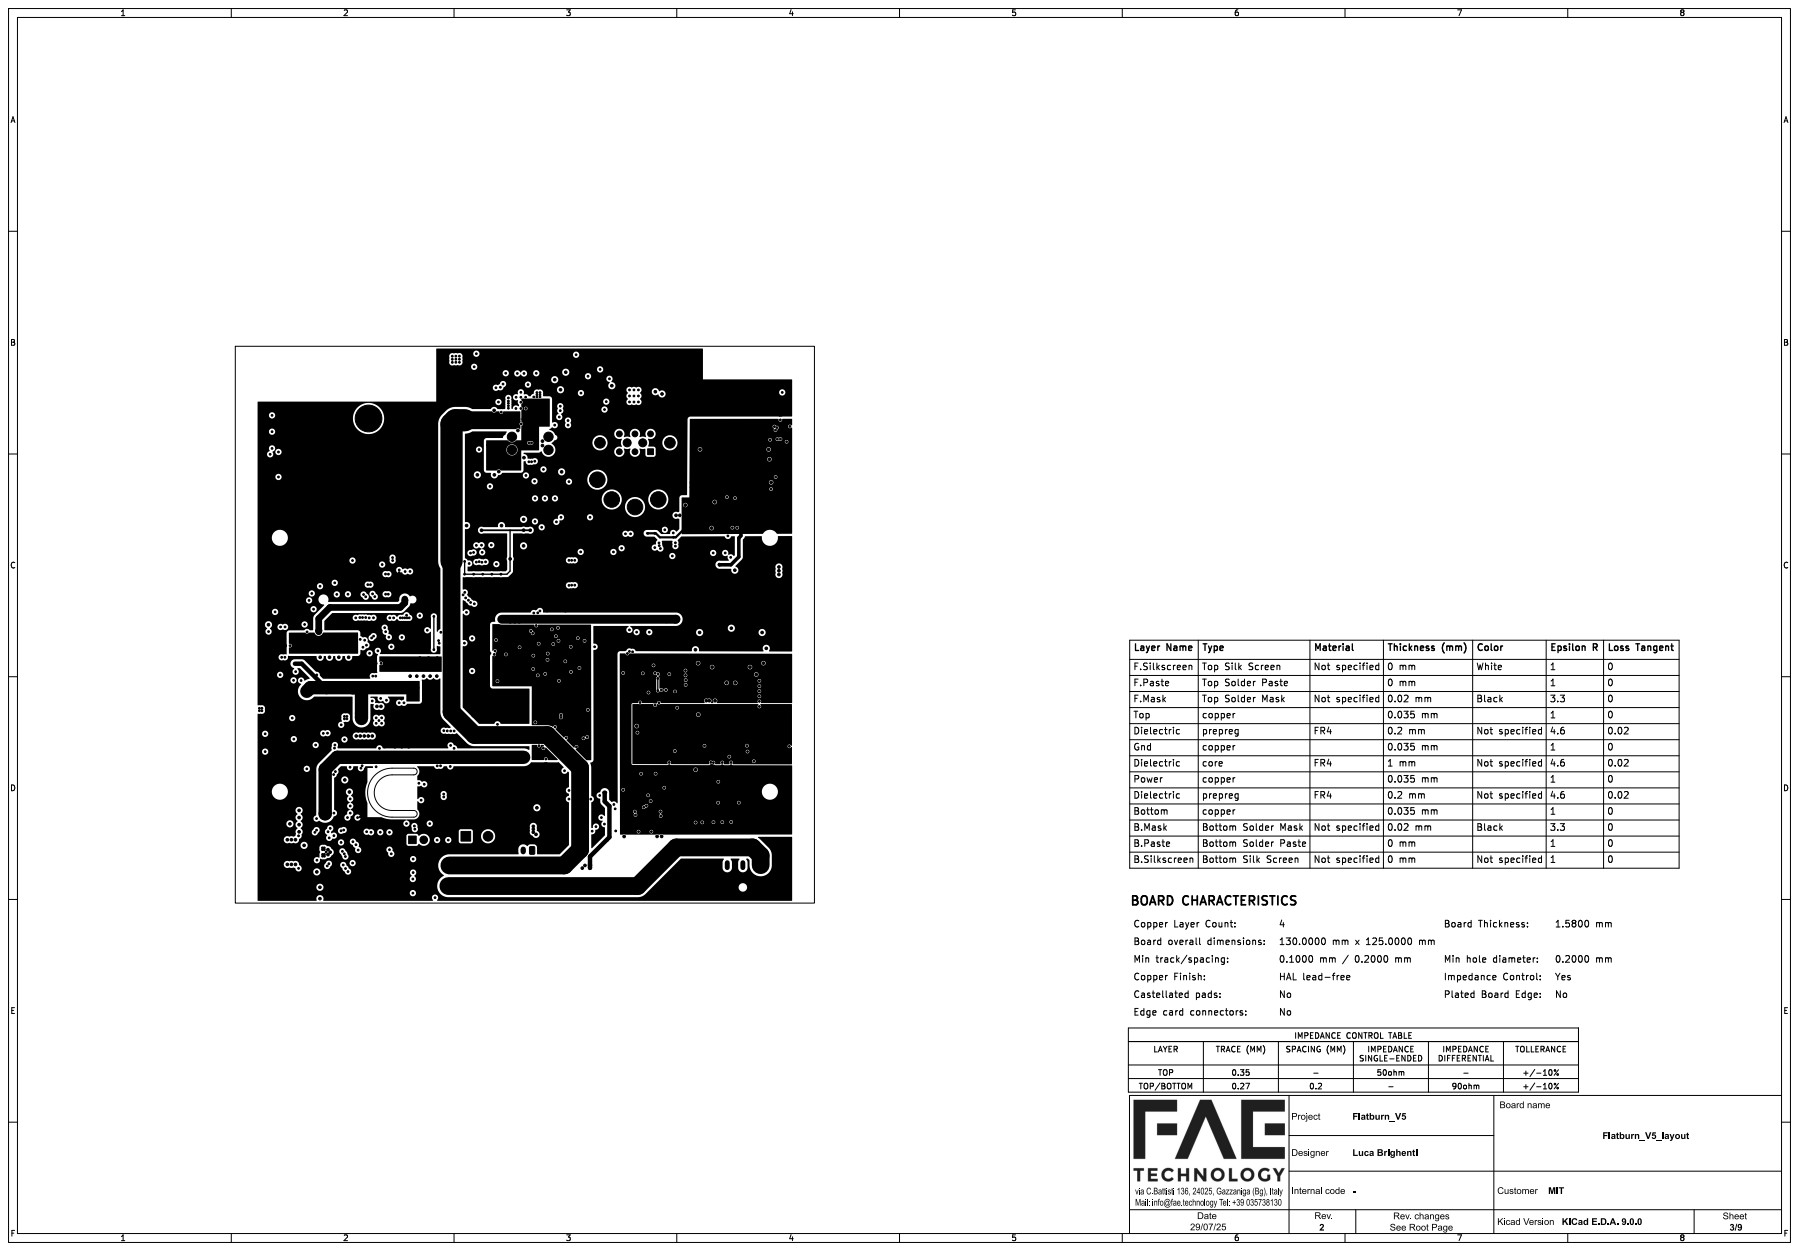
[picture p47: page 3]

Layer Name | | copper | | | | | FR4 Not specified | 0 mm 0.035 mm | Color Top Solder Paste Not specified F.Silkscreen Not specified Not specified | 1

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

prepreg | | | | | | 0.02 mm | White | Epsilon R 3.3
Copper Layer Count: Top | | | | | 1

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

0.035 mm | | | 0
0.02 mm | | 3.3

Bottom Solder Paste No No

Project via C.Battisti 136, 24025, Gazzaniga (Bg), Italy

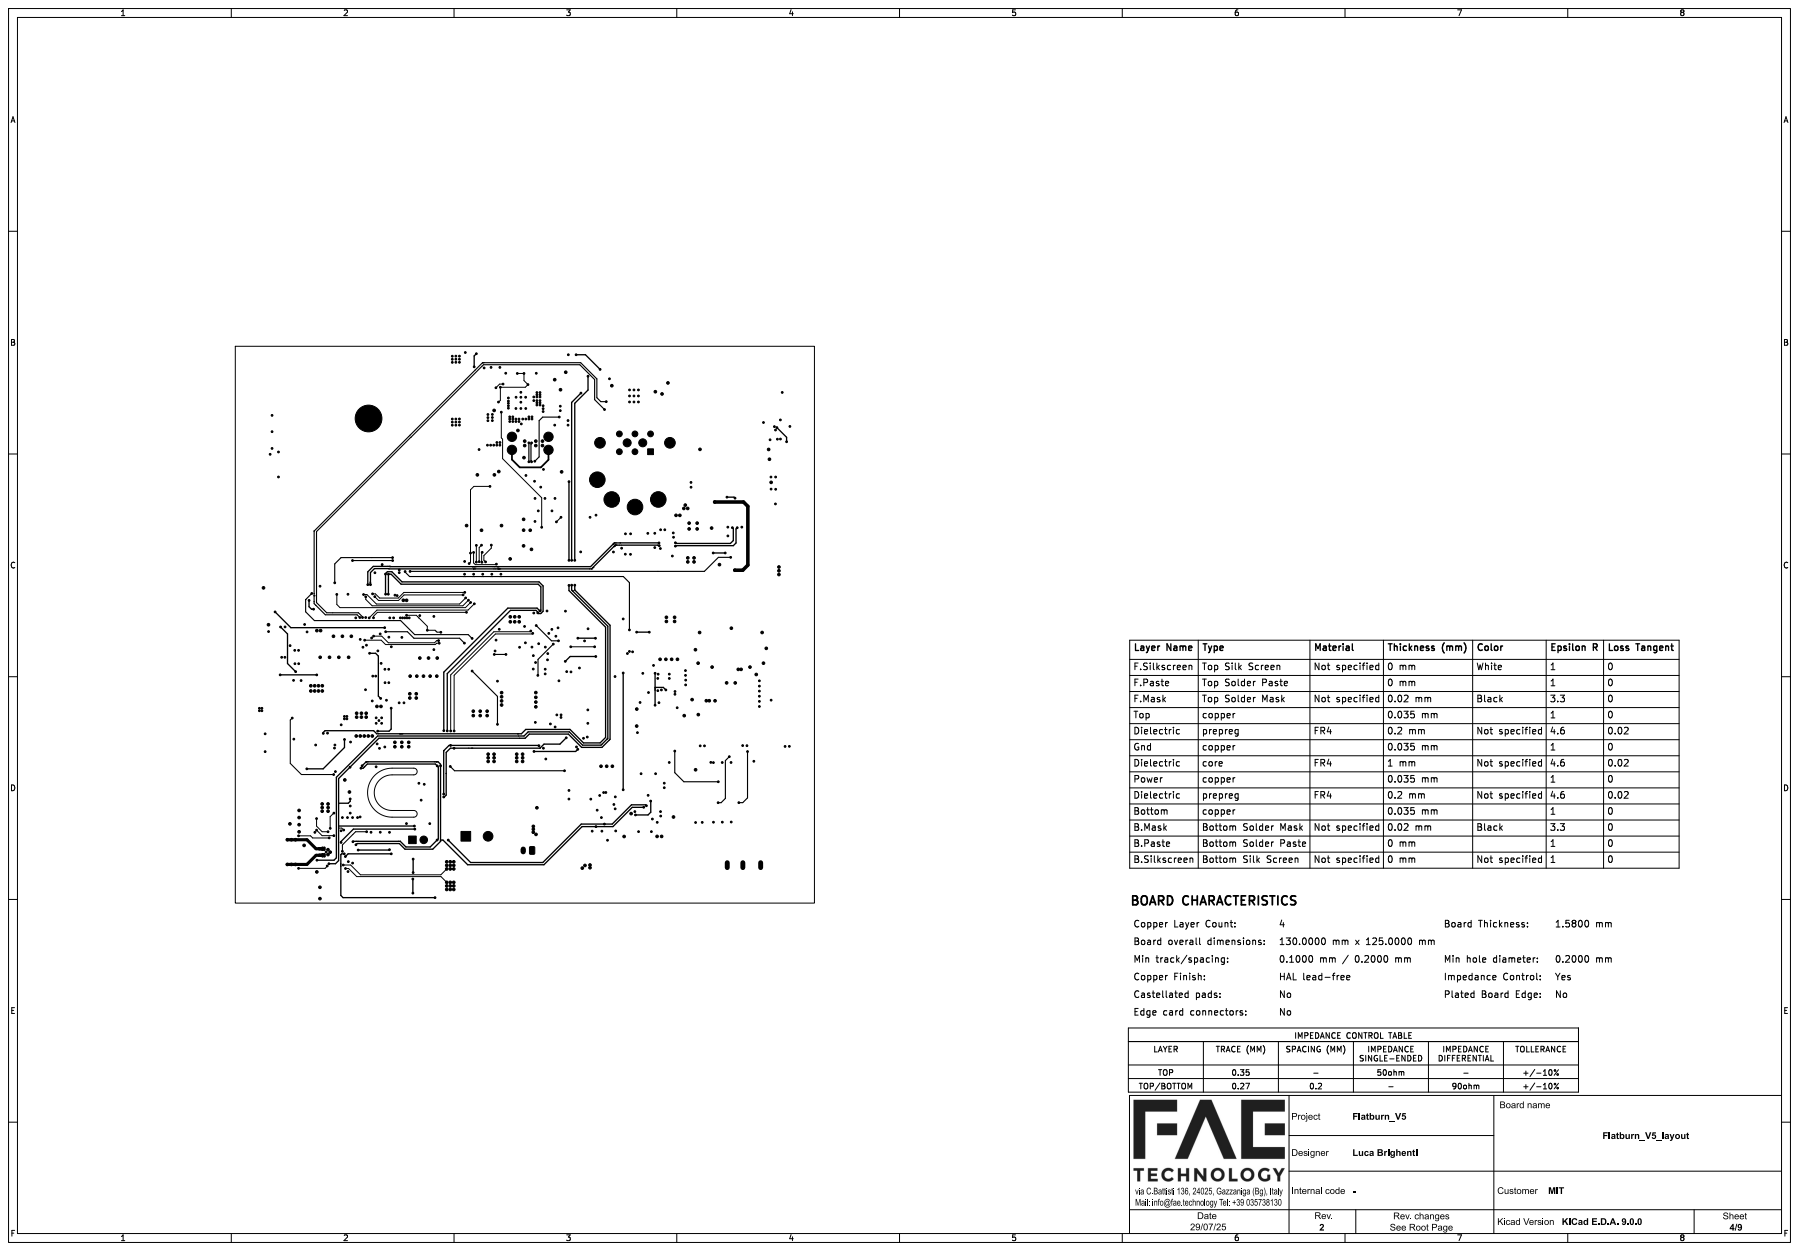
[picture p48: page 4]
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

prepreg | | | | | | 0.02 mm | White | Epsilon R 3.3
Copper Layer Count: Top | | | | | 1

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

0.035 mm | | | 0
0.02 mm | | 3.3

Bottom Solder Paste No No

Project via C.Battisti 136, 24025, Gazzaniga (Bg), Italy

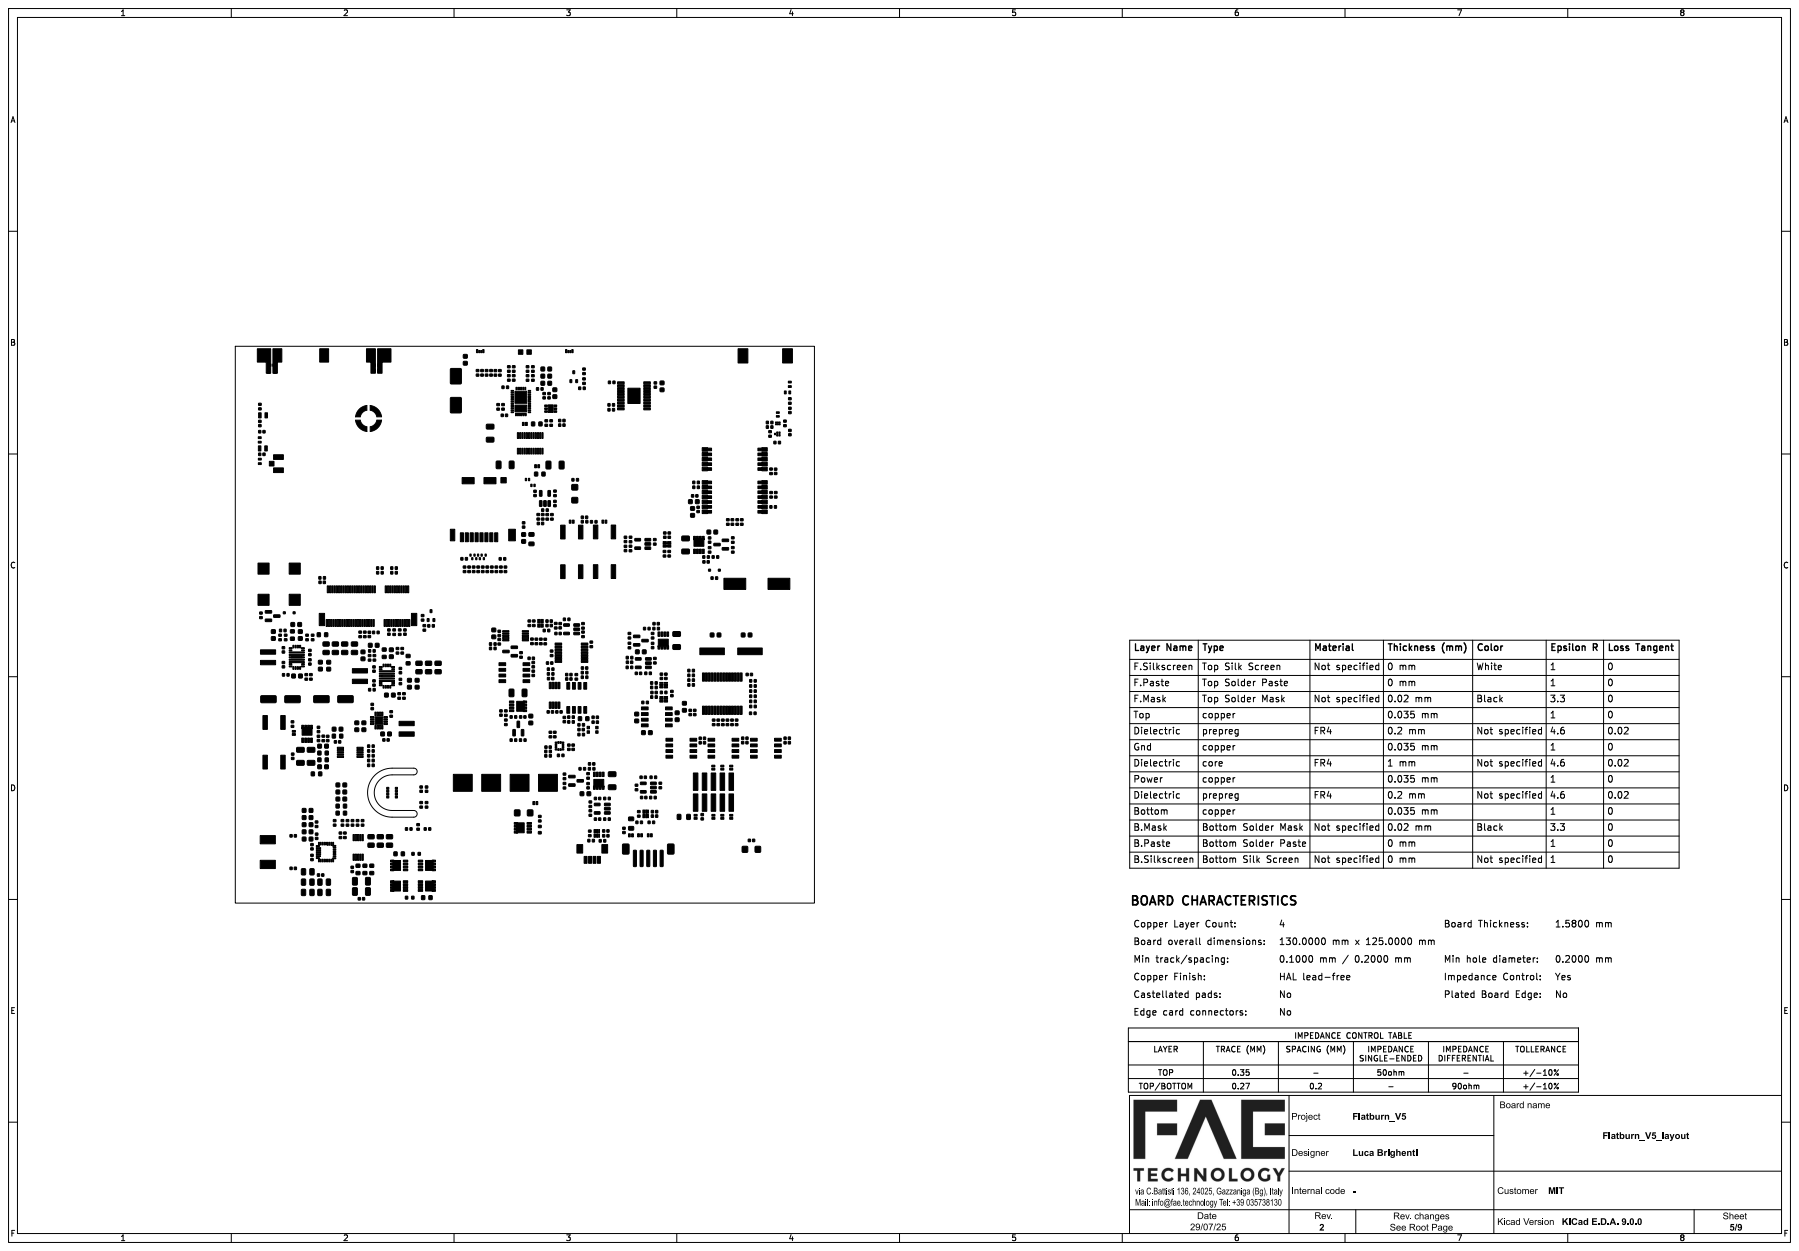
[picture p49: page 5]
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

prepreg | | | | | | 0.02 mm | White | Epsilon R 3.3
Copper Layer Count: Top | | | | | 1

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

0.035 mm | | | 0
0.02 mm | | 3.3

Bottom Solder Paste No No

Project via C.Battisti 136, 24025, Gazzaniga (Bg), Italy

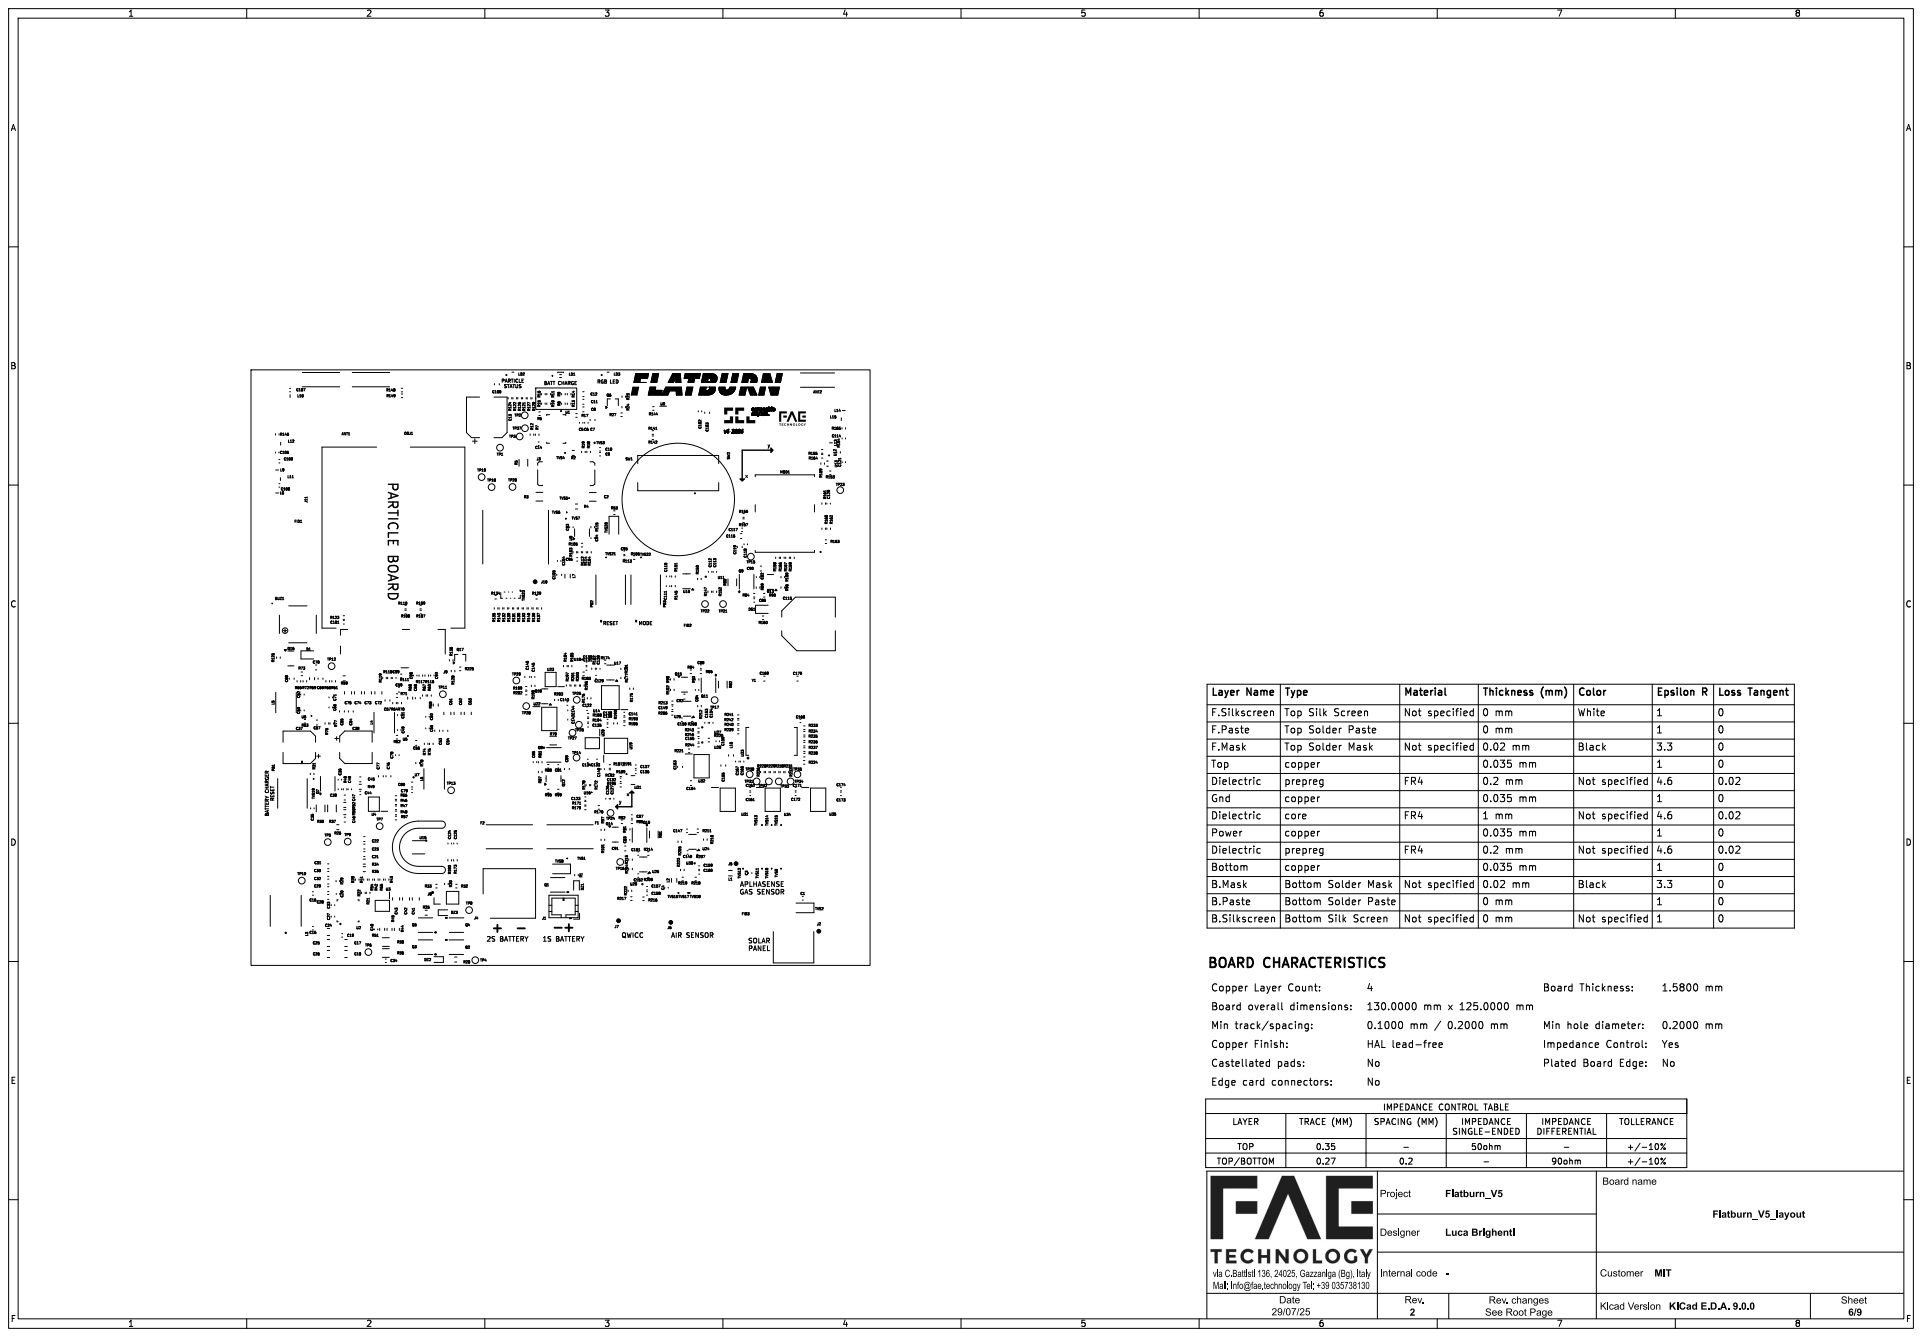
[picture p50: page 6]

0.02 Bottom Solder Mask prepreg

Top Silk Screen
Copper Layer Count: Top

Not specified

Bottom Solder Paste No No

Project via C.Battisti 136, 24025, Gazzaniga (Bg), Italy

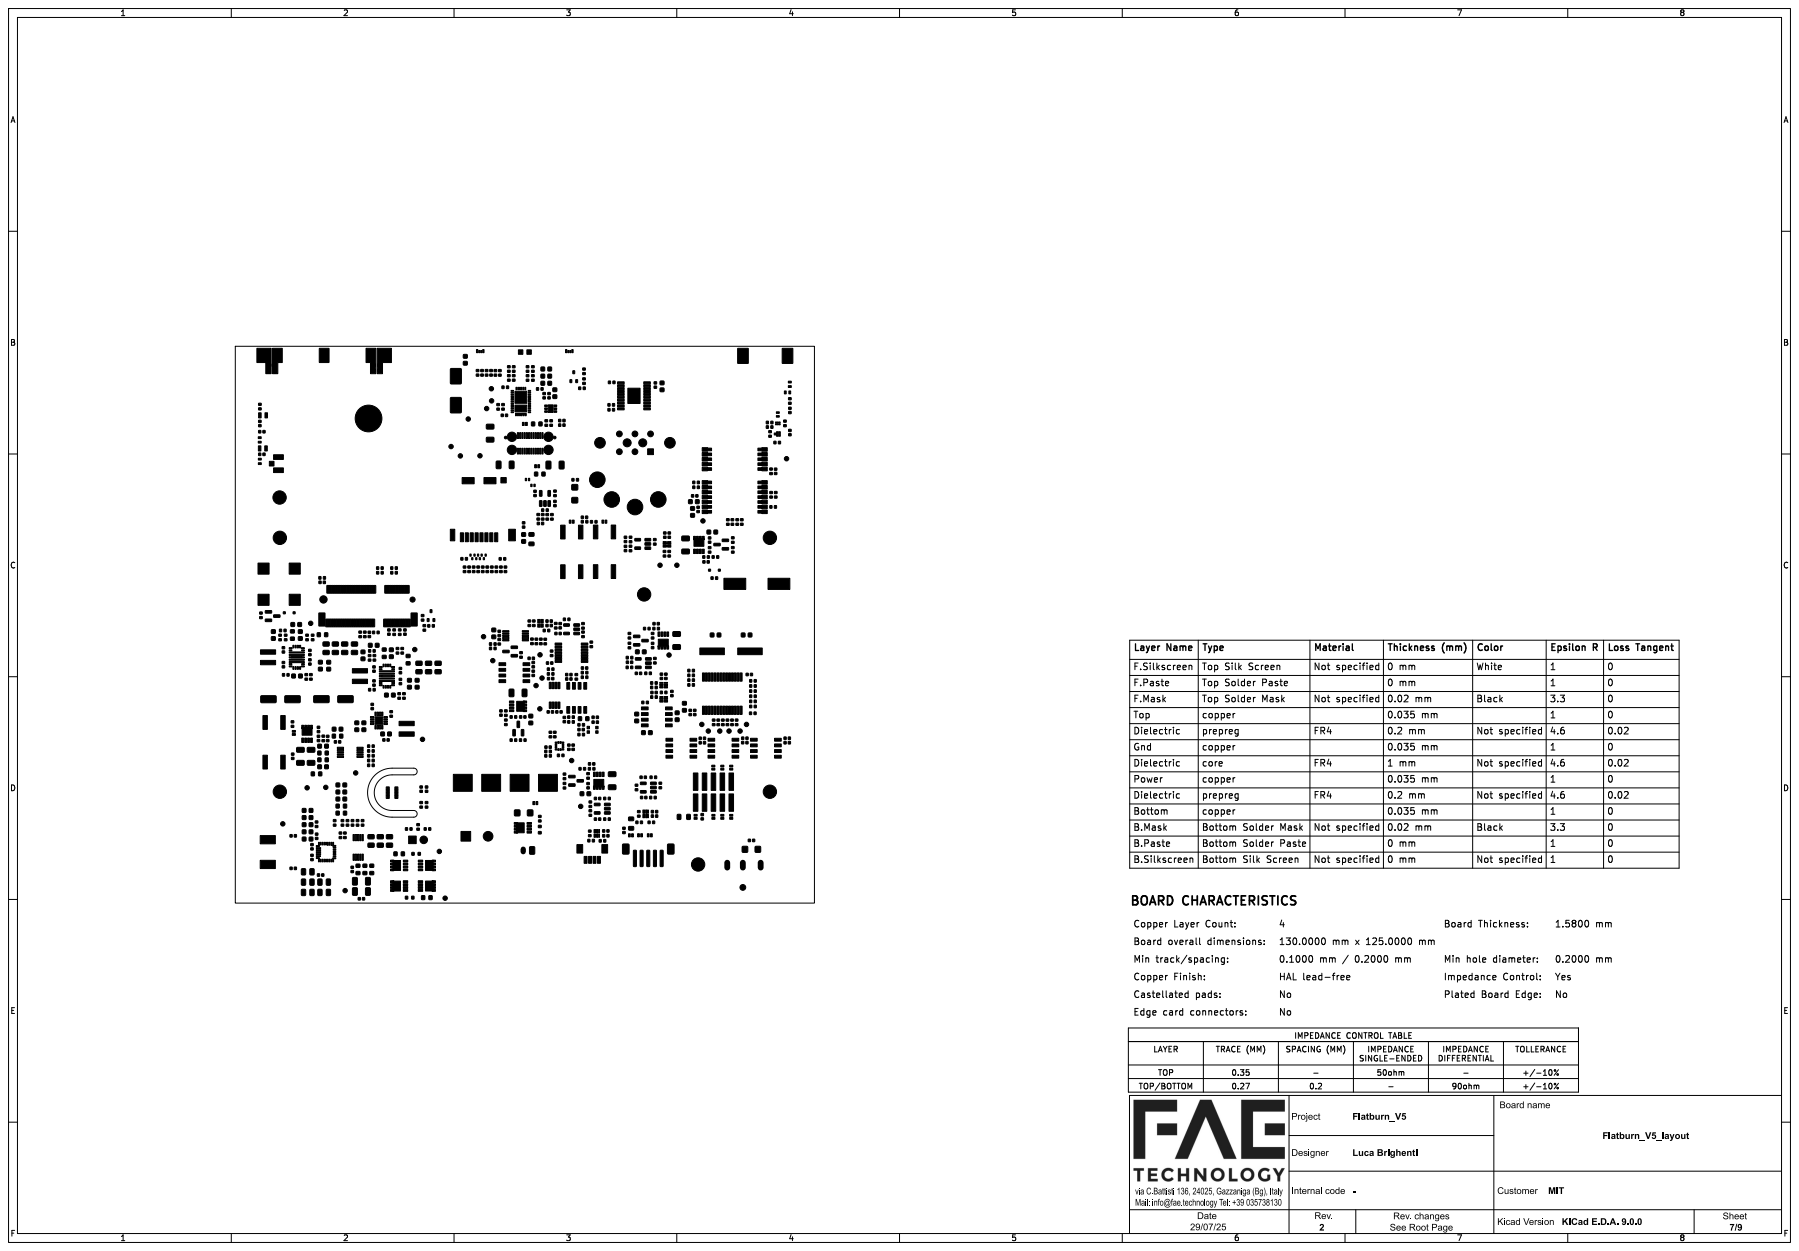
[picture p51: page 7]
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

prepreg | | | | | | 0.02 mm | White | Epsilon R 3.3
Copper Layer Count: Top | | | | | 1

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

0.035 mm | | | 0
0.02 mm | | 3.3

Bottom Solder Paste No No

Project via C.Battisti 136, 24025, Gazzaniga (Bg), Italy

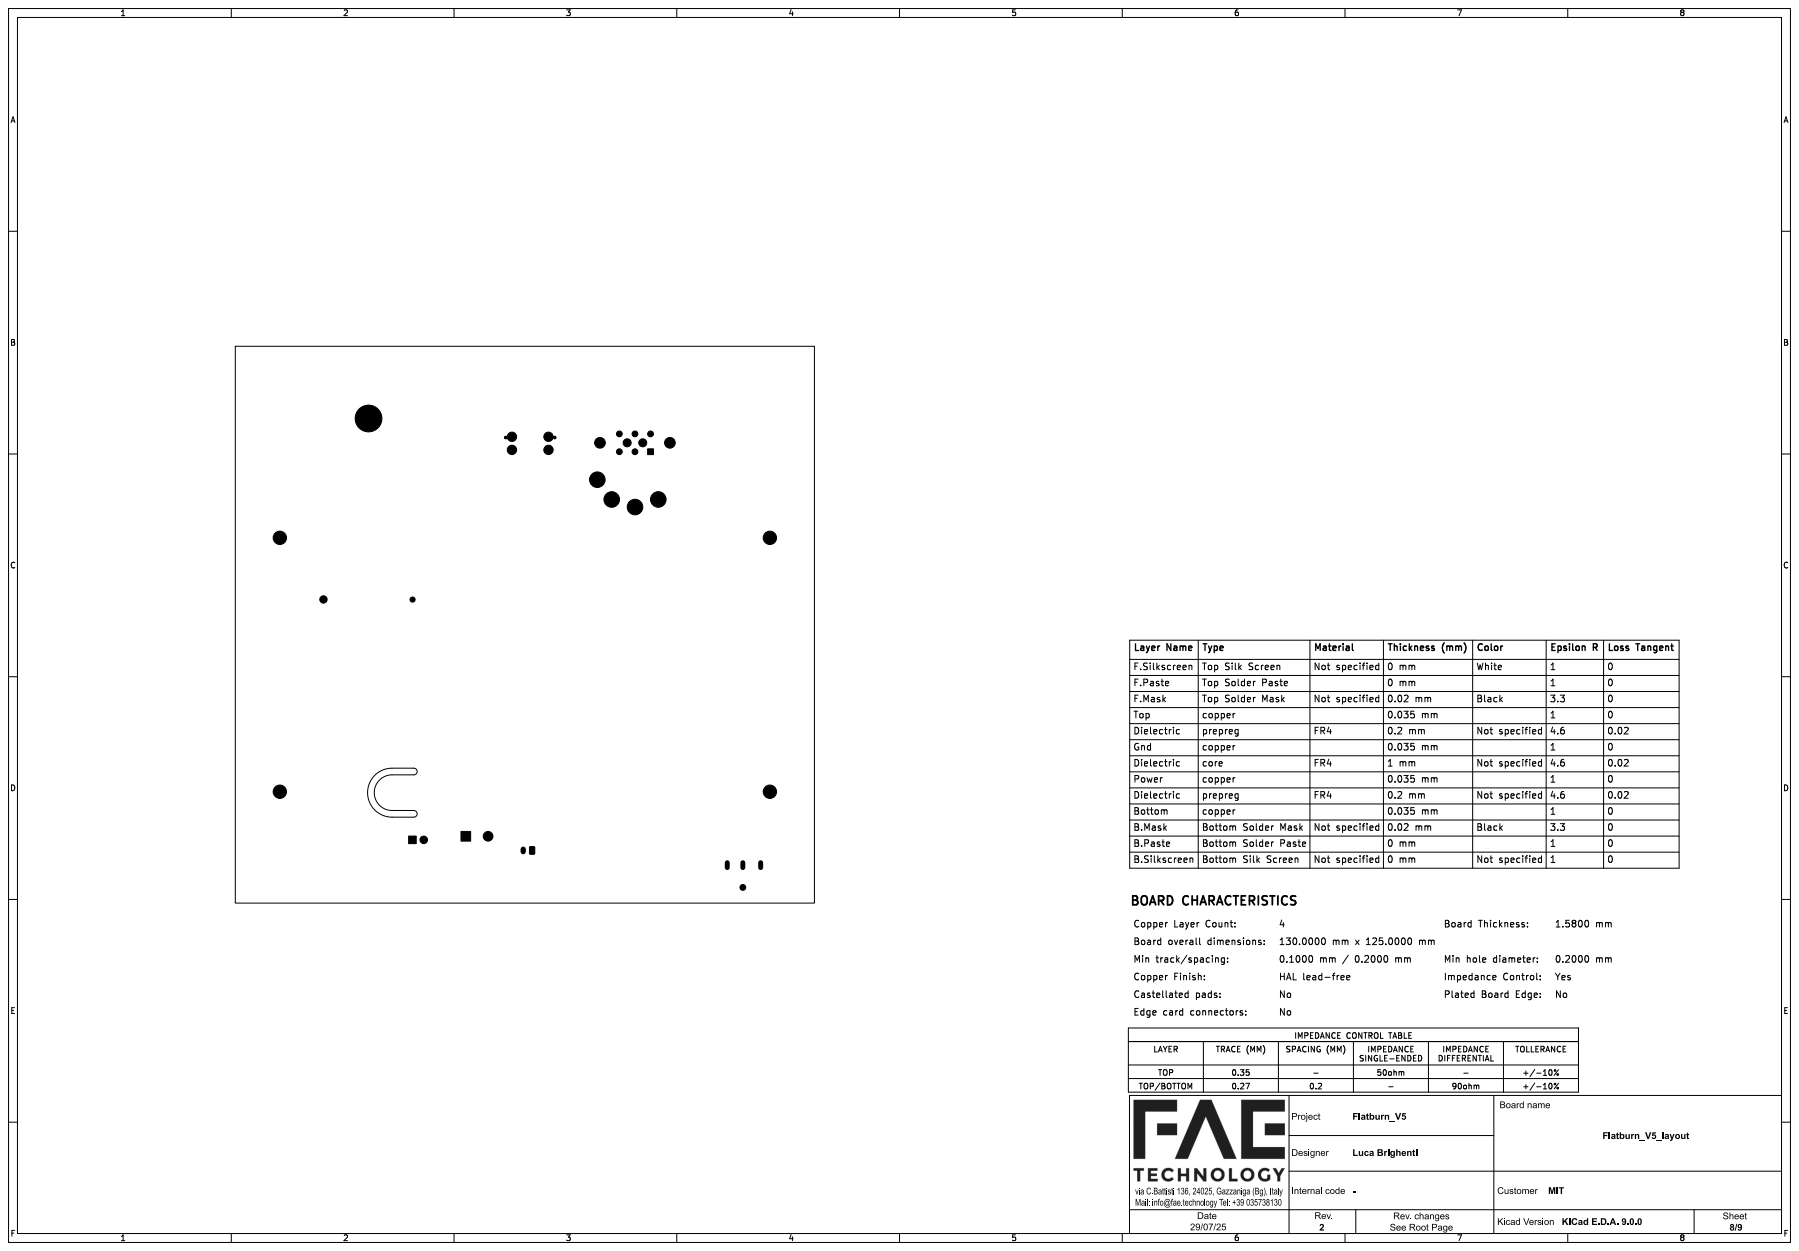
[picture p52: page 8]
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

prepreg | | | | | | 0.02 mm | White | Epsilon R 3.3
Copper Layer Count: Top | | | | | 1

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

0.035 mm | | | 0
0.02 mm | | 3.3

Bottom Solder Paste No No

Project via C.Battisti 136, 24025, Gazzaniga (Bg), Italy

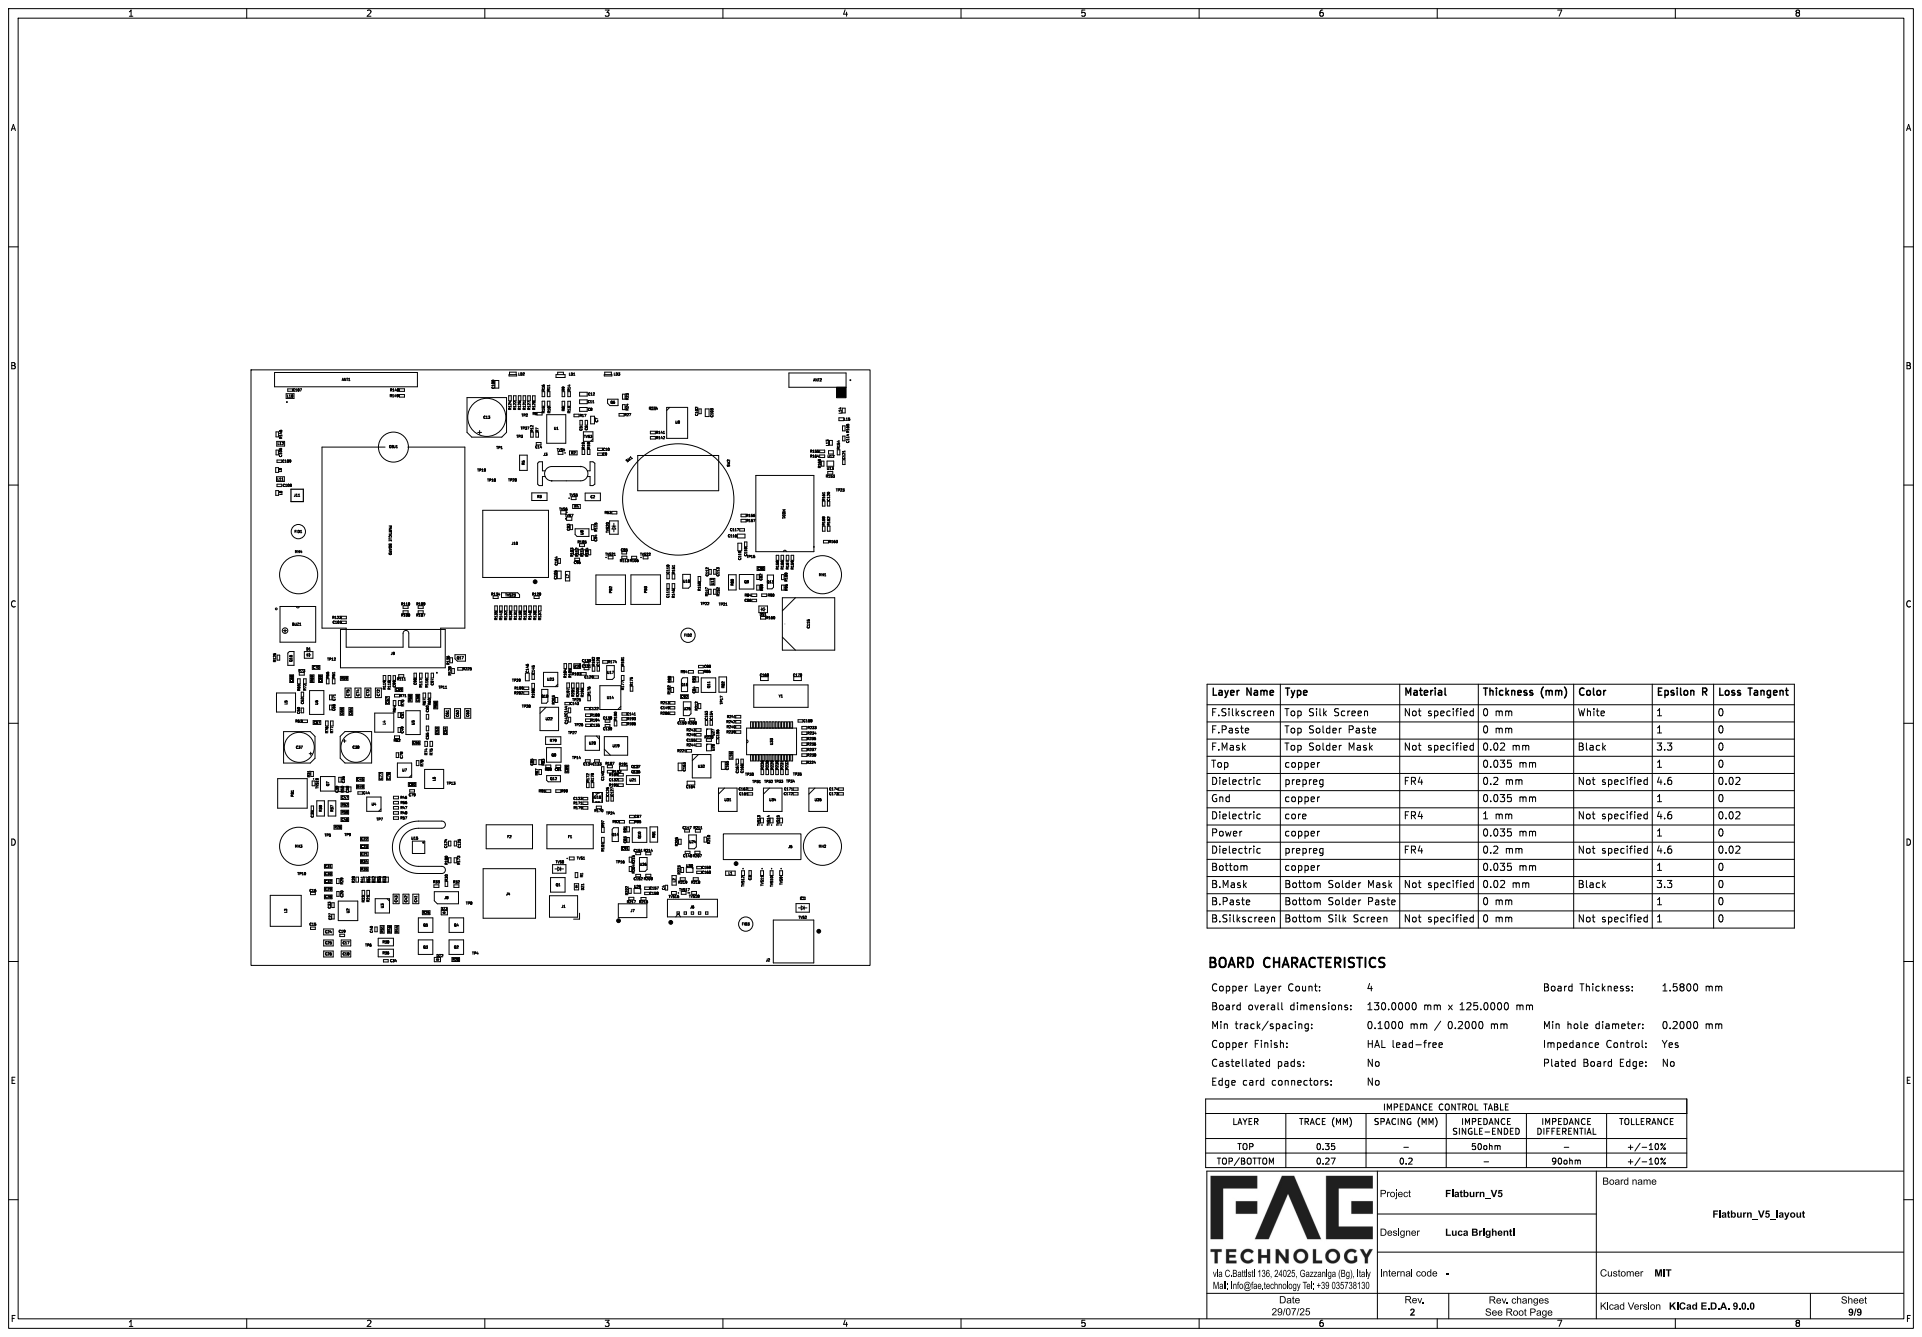
[picture p53: page 9]

0.02 Bottom Solder Mask prepreg

Top Silk Screen
Copper Layer Count: Top

Not specified

Bottom Solder Paste No No

Project via C.Battisti 136, 24025, Gazzaniga (Bg), Italy
