Brunoxd23/Flatburn-BR/hardware/electronics/Flatburn_V5.kicad_pcb

## KiCad design hardware/electronics/Flatburn_V5.kicad_pcb (continued)

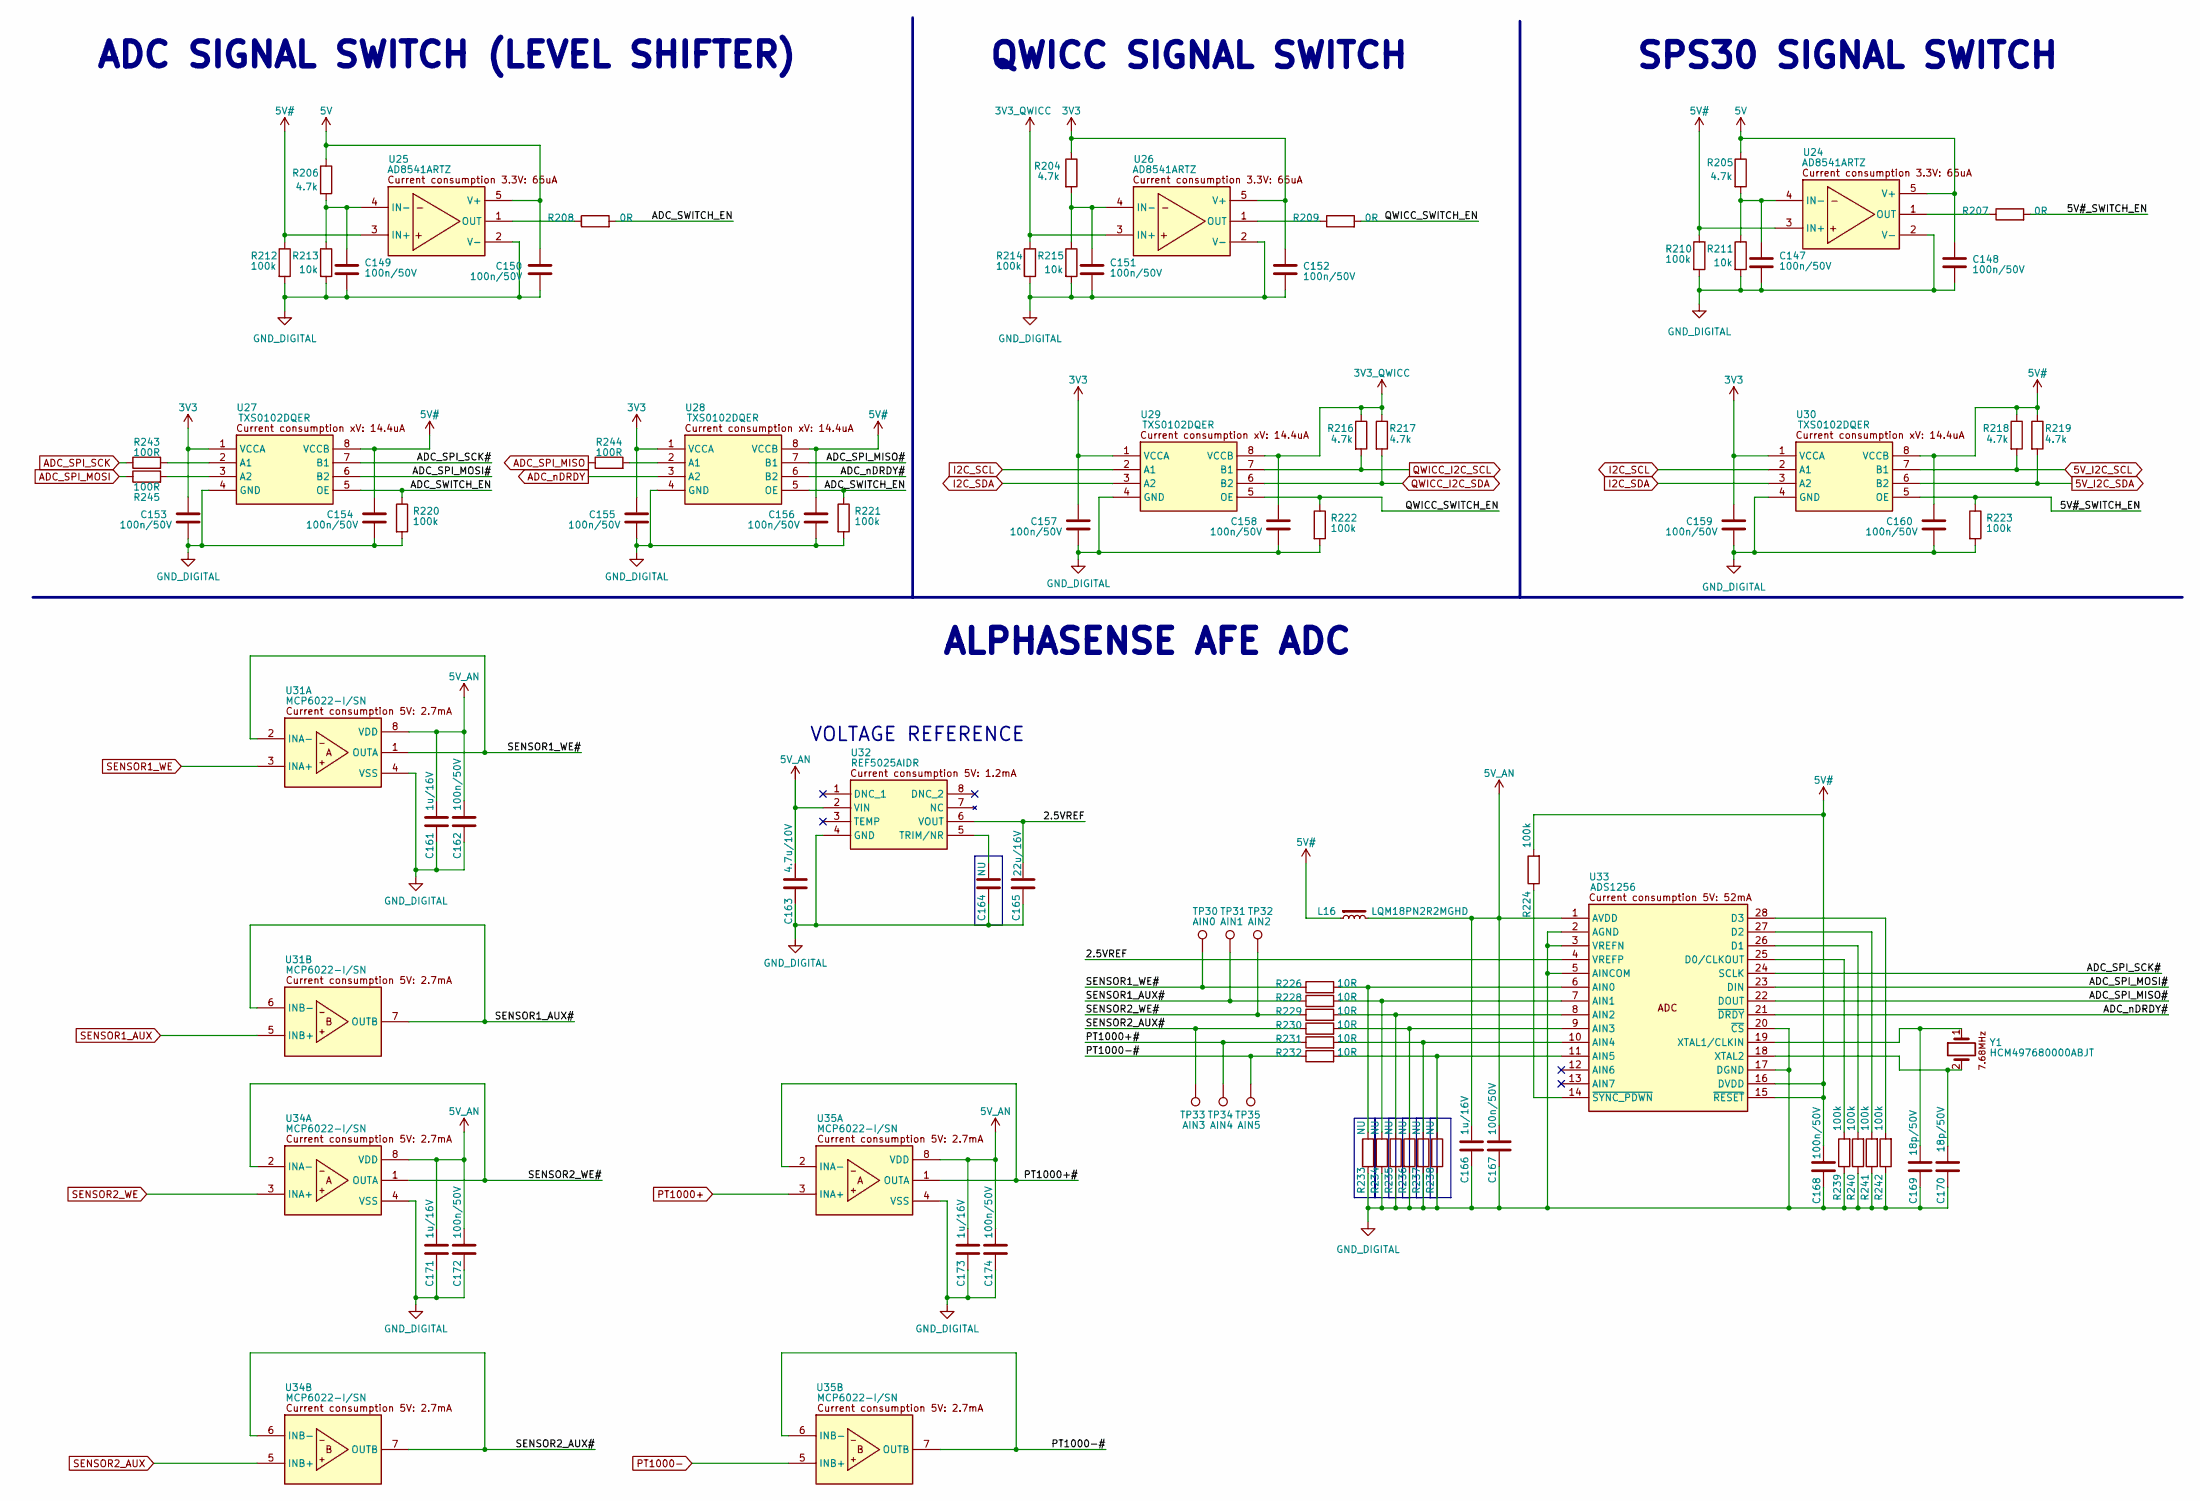
[picture p58: schematic sensors2.kicad_sch]

Parts:
C147, C148, C149, C150, C151, C152, C153, C154, C155, C156, C157, C158, C159, C160, C162, C167, C168, C172, C174: 100n/50V; C_0402_1005Metric
C161, C166, C171, C173: 1u/16V; C_0402_1005Metric; MPN GRM155C71C105KE11D
C163: 4.7u/10V; C_0603_1608Metric
C164: NU; C_0603_1608Metric; MPN CL10B105KA8NNNC
C165: 22u/16V; C_0603_1608Metric; MPN KGM15CR51C226MT
C169, C170: 18p/50V; C_0603_1608Metric; MPN C0603C180J5GAC7411
L16: LQM18PN2R2MGHD; L_0603_1608Metric; MPN LQM18PN2R2MGHD
R204, R205, R206, R216, R217, R218, R219: 4.7k; R_0402_1005Metric
R207, R208, R209: 0R; R_0402_1005Metric; MPN RCS04020000Z0ED
R210, R212, R214, R220, R221, R222, R223, R224, R239, R240, R241, R242: 100k; R_0402_1005Metric
R211, R213, R215: 10k; R_0402_1005Metric
R226, R228, R229, R230, R231, R232: 10R; R_0402_1005Metric; MPN RE0402DRE0710RL
R233, R234, R235, R236, R237, R238: NU; R_0402_1005Metric
R243, R244, R245: 100R; R_0402_1005Metric
TP30: AIN0; TestPoint_Pad_D1.0mm
TP31: AIN1; TestPoint_Pad_D1.0mm
TP32: AIN2; TestPoint_Pad_D1.0mm
TP33: AIN3; TestPoint_Pad_D1.0mm
TP34: AIN4; TestPoint_Pad_D1.0mm
TP35: AIN5; TestPoint_Pad_D1.0mm
U24, U25, U26: AD8541ARTZ; SOT-23-5; MPN TXS0102DQER
U27, U28, U29, U30: TXS0102DQER; SON35P100X140X40-8N; MPN TXS0102DQER
U31, U34, U35: MCP6022-I/SN; SOIC127P600X175-8N; MPN MCP6022-I/SN
U32: REF5025AIDR; SOIC127P600X175-8N; MPN REF5025AIDR
U33: ADS1256; DB28-M; MPN ADS1256IDBR
Y1: HCM497680000ABJT; MPN HCM497680000ABJT

Connections:
3V3: C152.1, C153.1, C155.1, C157.1, C159.1, R204.1, U26.5 (V+), U27.1 (VCCA), U28.1 (VCCA), U29.1 (VCCA), U30.1 (VCCA); also elsewhere on the board
3V3_QWICC: C158.1, R214.1, R216.1, R217.1, U26.3 (IN+), U29.8 (VCCB); also elsewhere on the board
5V: C148.1, C150.1, R205.1, R206.1, U24.5 (V+), U25.5 (V+); also elsewhere on the board
5V#: C154.1, C156.1, C160.1, C168.1, L16.2, R210.1, R212.1, R218.1, R219.1, R224.2, U24.3 (IN+), U25.3 (IN+), U27.8 (VCCB), U28.8 (VCCB), U30.8 (VCCB), U33.15 (~RESET), U33.16 (DVDD); also elsewhere on the board
5V_AN: C161.1, C162.1, C163.1, C166.1, C167.1, C171.1, C172.1, C173.1, C174.1, L16.1, U31.8 (VDD), U32.2 (VIN), U33.1 (AVDD), U34.8 (VDD), U35.8 (VDD)
5V_I2C_SCL: R218.2, U30.7 (B1); also elsewhere on the board
5V_I2C_SDA: R219.2, U30.6 (B2); also elsewhere on the board
/08 - SENSORS 2/2.5VREF: C165.1, U32.6 (VOUT), U33.4 (VREFP)
/08 - SENSORS 2/5V#_SWITCH_EN: R207.2, R223.1, U30.5 (OE)
/08 - SENSORS 2/ADC_SPI_MISO#: U28.7 (B1), U33.22 (DOUT)
/08 - SENSORS 2/ADC_SPI_MOSI#: U27.6 (B2), U33.23 (DIN)
/08 - SENSORS 2/ADC_SPI_SCK#: U27.7 (B1), U33.24 (SCLK)
/08 - SENSORS 2/ADC_SWITCH_EN: R208.2, R220.1, R221.1, U27.5 (OE), U28.5 (OE)
/08 - SENSORS 2/ADC_nDRDY#: U28.6 (B2), U33.21 (~DRDY)
/08 - SENSORS 2/PT1000+#: R231.1, TP34.1, U35.1 (OUTA), U35.2 (INA-)
/08 - SENSORS 2/PT1000-#: R232.1, TP35.1, U35.6 (INB-), U35.7 (OUTB)
/08 - SENSORS 2/QWICC_SWITCH_EN: R209.2, R222.1, U29.5 (OE)
/08 - SENSORS 2/SENSOR1_AUX#: R228.1, TP31.1, U31.6 (INB-), U31.7 (OUTB)
/08 - SENSORS 2/SENSOR1_WE#: R226.1, TP30.1, U31.1 (OUTA), U31.2 (INA-)
/08 - SENSORS 2/SENSOR2_AUX#: R230.1, TP33.1, U34.6 (INB-), U34.7 (OUTB)
/08 - SENSORS 2/SENSOR2_WE#: R229.1, TP32.1, U34.1 (OUTA), U34.2 (INA-)
ADC_SPI_MISO: R244.1; also elsewhere on the board
ADC_SPI_MOSI: R245.1; also elsewhere on the board
ADC_SPI_SCK: R243.1; also elsewhere on the board
ADC_nDRDY: U28.3 (A2); also elsewhere on the board
GND_DIGITAL: C147.2, C148.2, C149.2, C150.2, C151.2, C152.2, C153.2, C154.2, C155.2, C156.2, C157.2, C158.2, C159.2, C160.2, C161.2, C162.2, C163.2, C164.2, C165.2, C166.2, C167.2, C168.2, C169.2, C170.2, C171.2, C172.2, C173.2, C174.2, R210.2, R211.2, R212.2, R213.2, R214.2, R215.2, R220.2, R221.2, R222.2, R223.2, R233.2, R234.2, R235.2, R236.2, R237.2, R238.2, R239.1, R240.1, R241.1, R242.1, U24.2 (V-), U25.2 (V-), U26.2 (V-), U27.4 (GND), U28.4 (GND), U29.4 (GND), U30.4 (GND), U31.4 (VSS), U32.4 (GND), U33.2 (AGND), U33.3 (VREFN), U33.5 (AINCOM), U33.17 (DGND), U33.20 (~CS), U34.4 (VSS), U35.4 (VSS); also elsewhere on the board
I2C_SCL: U29.2 (A1), U30.2 (A1); also elsewhere on the board
I2C_SDA: U29.3 (A2), U30.3 (A2); also elsewhere on the board
unnamed: C147.1, R205.2, R211.1, U24.4 (IN-)
unnamed: R207.1, U24.1 (OUT)
unnamed: C149.1, R206.2, R213.1, U25.4 (IN-)
unnamed: R208.1, U25.1 (OUT)
unnamed: C151.1, R204.2, R215.1, U26.4 (IN-)
unnamed: R209.1, U26.1 (OUT)
unnamed: R243.2, U27.2 (A1)
unnamed: R245.2, U27.3 (A2)
unnamed: R244.2, U28.2 (A1)
unnamed: C164.1, U32.5 (TRIM/NR)
unnamed: R226.2, R233.1, U33.6 (AIN0)
unnamed: R228.2, R234.1, U33.7 (AIN1)
unnamed: R229.2, R235.1, U33.8 (AIN2)
unnamed: R230.2, R236.1, U33.9 (AIN3)
unnamed: R231.2, R237.1, U33.10 (AIN4)
unnamed: R232.2, R238.1, U33.11 (AIN5)
unnamed: R239.2, U33.25 (D0/CLKOUT)
unnamed: R240.2, U33.26 (D1)
unnamed: R241.2, U33.27 (D2)
unnamed: R242.2, U33.28 (D3)
unnamed: C169.1, U33.19 (XTAL1/CLKIN), Y1.1
unnamed: C170.1, U33.18 (XTAL2), Y1.2
unnamed: R224.1, U33.14 (~SYNC_PDWN)
PT1000+: U35.3 (INA+); also elsewhere on the board
PT1000-: U35.5 (INB+); also elsewhere on the board
QWICC_I2C_SCL: R216.2, U29.7 (B1); also elsewhere on the board
QWICC_I2C_SDA: R217.2, U29.6 (B2); also elsewhere on the board
SENSOR1_AUX: U31.5 (INB+); also elsewhere on the board
SENSOR1_WE: U31.3 (INA+); also elsewhere on the board
SENSOR2_AUX: U34.5 (INB+); also elsewhere on the board
SENSOR2_WE: U34.3 (INA+); also elsewhere on the board

Notes on the sheet:
QWICC SIGNAL SWITCH
VOLTAGE REFERENCE
SPS30 SIGNAL SWITCH
ALPHASENSE AFE ADC
ADC SIGNAL SWITCH (LEVEL SHIFTER)

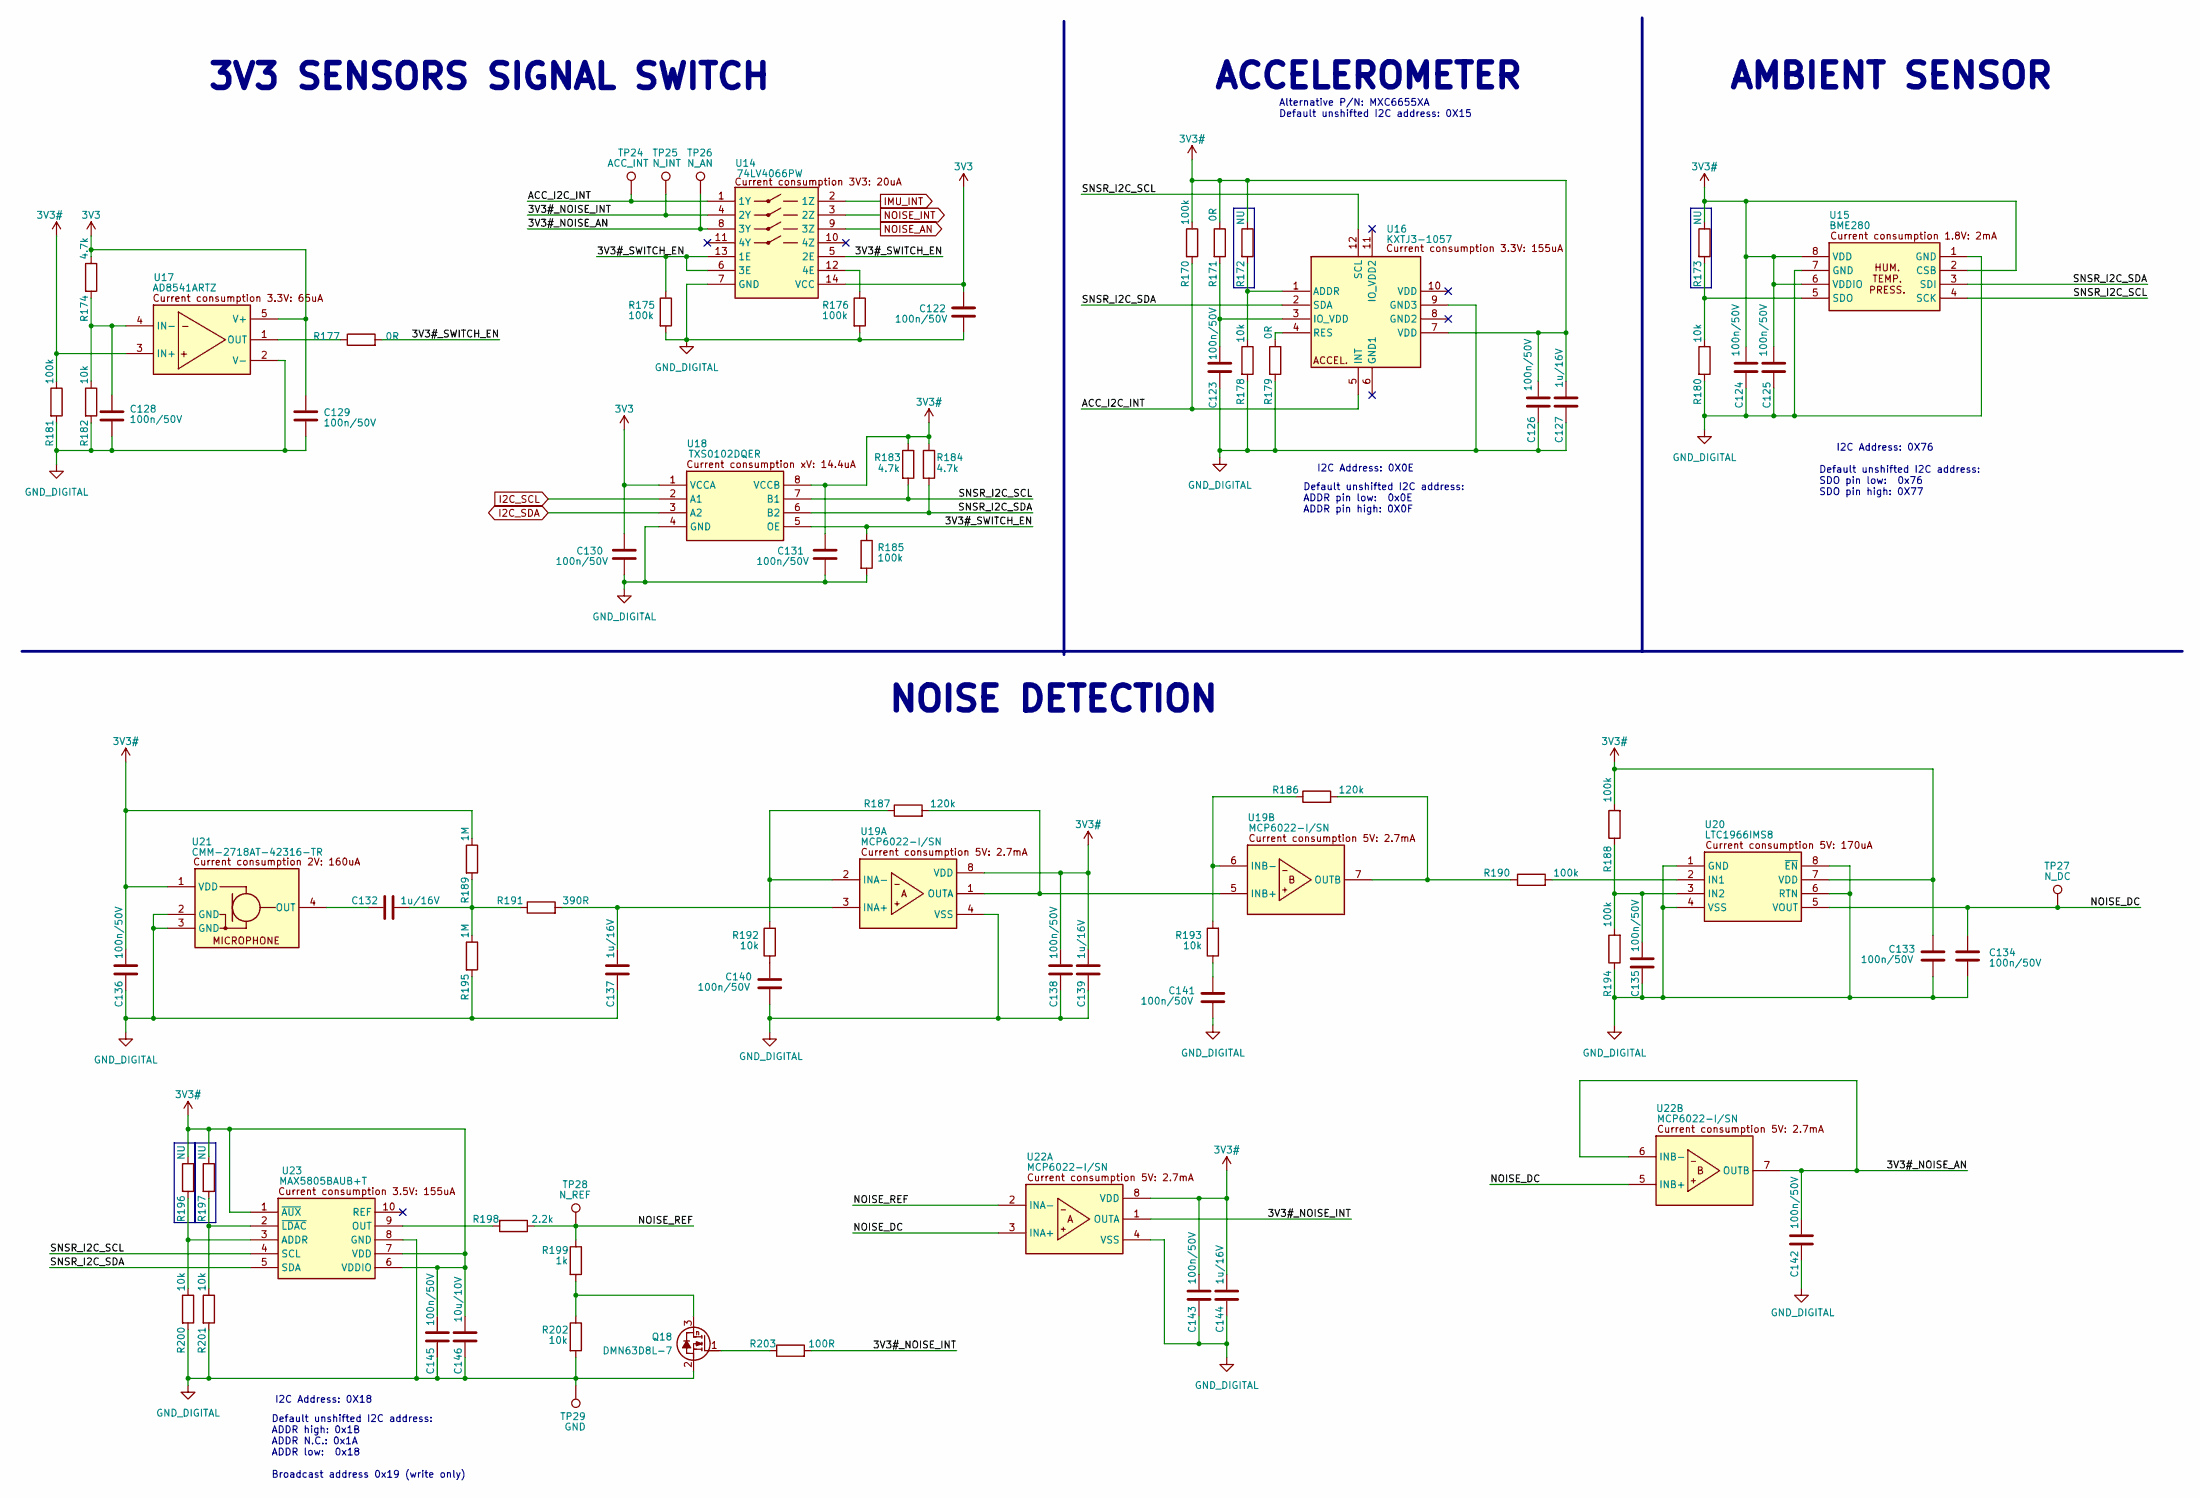
[picture p59: schematic sensors.kicad_sch]

Parts:
C122, C123, C124, C125, C126, C128, C129, C130, C131, C133, C134, C135, C136, C138, C140, C141, C142, C143, C145: 100n/50V; C_0402_1005Metric
C127, C132, C137, C139, C144: 1u/16V; C_0402_1005Metric; MPN GRM155C71C105KE11D
C146: 10u/10V; C_0603_1608Metric
Q18: DMN63D8L-7; SOT-23; MPN DMN63D8L-7
R170, R175, R176, R181, R185, R188, R190, R194: 100k; R_0402_1005Metric
R171, R177, R179: 0R; R_0402_1005Metric; MPN RCS04020000Z0ED
R172, R173, R196, R197: NU; R_0402_1005Metric
R174, R183, R184: 4.7k; R_0402_1005Metric
R178, R180, R182, R192, R193, R200, R201, R202: 10k; R_0402_1005Metric
R186, R187: 120k; R_0402_1005Metric; MPN CRCW0402120KFKED
R189, R195: 1M; R_0402_1005Metric
R191: 390R; R_0603_1608Metric
R198: 2.2k; R_0402_1005Metric
R199: 1k; R_0402_1005Metric
R203: 100R; R_0402_1005Metric
TP24: ACC_INT; TestPoint_Pad_D1.0mm
TP25: N_INT; TestPoint_Pad_D1.0mm
TP26: N_AN; TestPoint_Pad_D1.0mm
TP27: N_DC; TestPoint_Pad_D1.0mm
TP28: N_REF; TestPoint_Pad_D1.0mm
TP29: GND; TestPoint_Pad_D1.0mm
U14: 74LV4066PW; SOP65P640X110-14N; MPN 74LV4066PW,118
U15: BME280; PSON65P250X250X100-8N; MPN BME280
U16: KXTJ3-1057; LGA12_2X2X0.9_KNX-M; MPN KXTJ3-1057
U17: AD8541ARTZ; SOT-23-5; MPN TXS0102DQER
U18: TXS0102DQER; SON35P100X140X40-8N; MPN TXS0102DQER
U19, U22: MCP6022-I/SN; SOIC127P600X175-8N; MPN MCP6022-I/SN
U20: LTC1966IMS8; SOP65P490X110-8N; MPN LTC1966IMS8#PBF
U21: CMM-2718AT-42316-TR; CMM2718AT42316TR; MPN CMM-2718AT-42316-TR
U23: MAX5805BAUB+T; SOP50P490X110-10N; MPN MAX5805BAUB+T

Connections:
3V3: C122.1, C129.1, C130.1, R174.1, U14.14 (VCC), U17.5 (V+), U18.1 (VCCA); also elsewhere on the board
3V3#: C124.1, C125.1, C126.1, C127.1, C131.1, C133.1, C136.1, C138.1, C139.1, C143.1, C144.1, C145.1, C146.1, R170.1, R171.1, R172.1, R173.1, R181.1, R183.1, R184.1, R188.2, R189.1, R196.1, R197.1, U15.2 (CSB), U15.6 (VDDIO), U15.8 (VDD), U16.7 (VDD), U17.3 (IN+), U18.8 (VCCB), U19.8 (VDD), U20.7 (VDD), U21.1 (VDD), U22.8 (VDD), U23.1 (~AUX), U23.6 (VDDIO), U23.7 (VDD); also elsewhere on the board
/07 - SENSORS/3V3#_NOISE_AN: C142.1, TP26.1, U14.8 (3Y), U22.6 (INB-), U22.7 (OUTB)
/07 - SENSORS/3V3#_NOISE_INT: R203.2, TP25.1, U14.4 (2Y), U22.1 (OUTA)
/07 - SENSORS/3V3#_SWITCH_EN: R175.1, R177.2, R185.1, U14.5 (2E), U14.6 (3E), U14.13 (1E), U18.5 (OE)
/07 - SENSORS/ACC_I2C_INT: R170.2, TP24.1, U14.1 (1Y), U16.5 (INT)
/07 - SENSORS/NOISE_DC: C134.1, TP27.1, U20.5 (VOUT), U22.3 (INA+), U22.5 (INB+)
/07 - SENSORS/NOISE_REF: R198.1, R199.1, TP28.1, U22.2 (INA-)
/07 - SENSORS/SNSR_I2C_SCL: R183.2, U15.4 (SCK), U16.12 (SCL), U18.7 (B1), U23.4 (SCL)
/07 - SENSORS/SNSR_I2C_SDA: R184.2, U15.3 (SDI), U16.2 (SDA), U18.6 (B2), U23.5 (SDA)
GND_DIGITAL: C122.2, C123.2, C124.2, C125.2, C126.2, C127.2, C128.2, C129.2, C130.2, C131.2, C133.2, C134.2, C135.2, C136.2, C137.2, C138.2, C139.2, C140.2, C141.2, C142.2, C143.2, C144.2, C145.2, C146.2, Q18.2 (S), R175.2, R176.2, R178.2, R179.2, R180.2, R181.2, R182.2, R185.2, R194.1, R195.2, R200.2, R201.2, R202.2, TP29.1, U14.7 (GND), U15.1 (GND), U15.7 (GND), U16.9 (GND3), U17.2 (V-), U18.4 (GND), U19.4 (VSS), U20.1 (GND), U20.4 (VSS), U20.6 (RTN), U20.8 (~EN), U21.2 (GND), U21.3 (GND), U22.4 (VSS), U23.8 (GND); also elsewhere on the board
I2C_SCL: U18.2 (A1); also elsewhere on the board
I2C_SDA: U18.3 (A2); also elsewhere on the board
IMU_INT: U14.2 (1Z); also elsewhere on the board
NOISE_AN: U14.9 (3Z); also elsewhere on the board
NOISE_INT: U14.3 (2Z); also elsewhere on the board
unnamed: C132.1, R189.2, R191.1, R195.1
unnamed: C140.1, R192.1
unnamed: C141.1, R193.1
unnamed: Q18.3 (D), R199.2, R202.1
unnamed: Q18.1 (G), R203.1
unnamed: R176.1, U14.12 (4E)
unnamed: R173.2, R180.1, U15.5 (SDO)
unnamed: R172.2, R178.1, U16.1 (ADDR)
unnamed: C123.1, R171.2, U16.3 (IO_VDD)
unnamed: R179.1, U16.4 (RES)
unnamed: C128.1, R174.2, R182.1, U17.4 (IN-)
unnamed: R177.1, U17.1 (OUT)
unnamed: C137.1, R191.2, U19.3 (INA+)
unnamed: R187.1, R192.2, U19.2 (INA-)
unnamed: R187.2, U19.1 (OUTA), U19.5 (INB+)
unnamed: R186.1, R193.2, U19.6 (INB-)
unnamed: R186.2, R190.1, U19.7 (OUTB)
unnamed: R190.2, U20.2 (IN1)
unnamed: C135.1, R188.1, R194.2, U20.3 (IN2)
unnamed: C132.2, U21.4 (OUT)
unnamed: R196.2, R200.1, U23.3 (ADDR)
unnamed: R198.2, U23.9 (OUT)
unnamed: R197.2, R201.1, U23.2 (~LDAC)

Notes on the sheet:
3V3 SENSORS SIGNAL SWITCH
I2C Address: 0X76
ACCELEROMETER
Default unshifted I2C address: ADDR pin low: 0x0E ADDR pin high: 0X0F
AMBIENT SENSOR
Alternative P/N: MXC6655XA Default unshifted I2C address: 0X15
I2C Address: 0X18
I2C Address: 0X0E
NOISE DETECTION
Default unshifted I2C address: ADDR high: 0x1B ADDR N.C.: 0x1A ADDR low: 0x18 Broadcast address 0x19 (write only)
Default unshifted I2C address: SDO pin low: 0x76 SDO pin high: 0X77

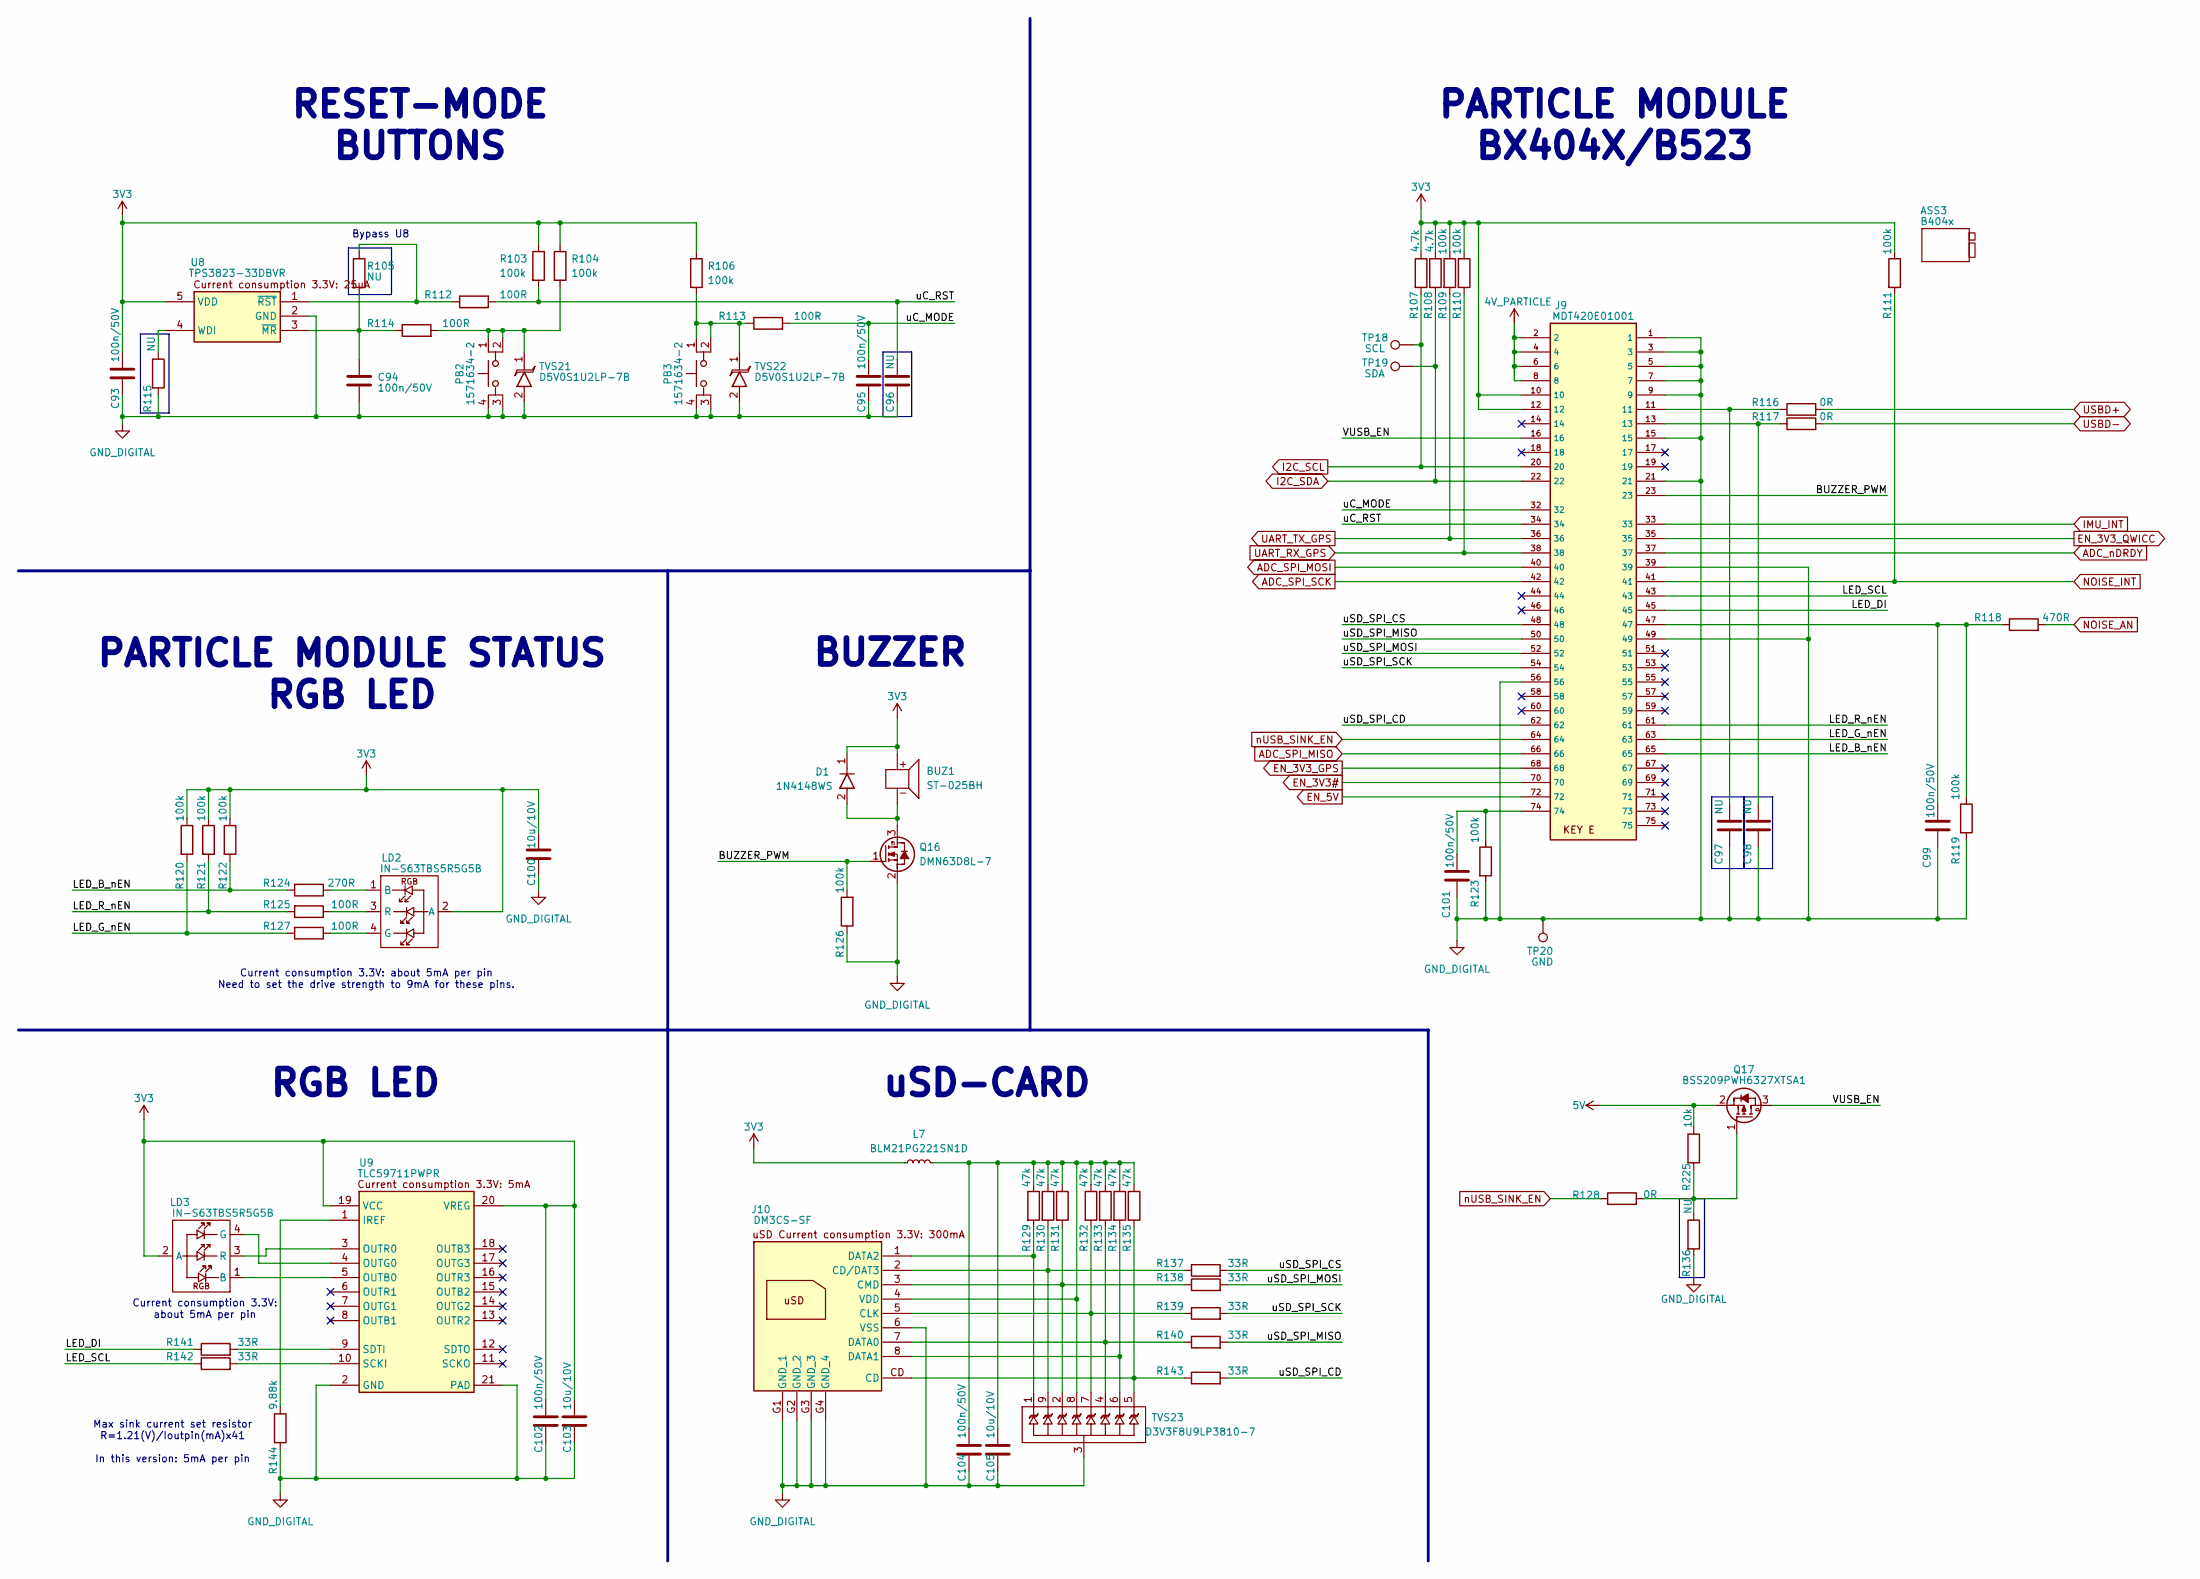
[picture p60: schematic mcu.kicad_sch]

Parts:
ASS3: B404x; PARTICLE B404X-B523; MPN B404x
BUZ1: ST-025BH; ST-025BH_SOB; MPN ST-025BH
C93, C94, C95, C99, C101, C102, C104: 100n/50V; C_0402_1005Metric
C96, C97, C98: NU; C_0402_1005Metric
C100, C103, C105: 10u/10V; C_0603_1608Metric
D1: 1N4148WS; D_SOD-323F; MPN 1N4148WS
J9: MDT420E01001; MPN MDT420E01001
J10: DM3CS-SF; DM3CSSF; MPN DM3CS-SF
L7: BLM21PG221SN1D; L_0805_2012Metric; MPN BLM21PG221SN1D
LD2, LD3: IN-S63TBS5R5G5B; INS63TBS5R5G5B; MPN IN-S63TBS5R5G5B
PB2, PB3: 1571634-2; 15716342; MPN 1571634-2
Q16: DMN63D8L-7; SOT-23; MPN DMN63D8L-7
Q17: BSS209PWH6327XTSA1; SOT-323_SC-70; MPN BSS209PWH6327XTSA1
R103, R104, R106, R109, R110, R111, R119, R120, R121, R122, R123, R126: 100k; R_0402_1005Metric
R105, R136: NU; R_0402_1005Metric; MPN RCS04020000Z0ED
R107, R108: 4.7k; R_0402_1005Metric
R112, R113, R114, R125, R127: 100R; R_0402_1005Metric
R115: NU; R_0402_1005Metric
R116, R117: 0R; R_0402_1005Metric; MPN MCS04020Z0000ZE000
R118: 470R; R_0402_1005Metric
R124: 270R; R_0402_1005Metric; MPN RC0402FR-07270RL
R128: 0R; R_0402_1005Metric; MPN RCS04020000Z0ED
R129, R130, R131, R132, R133, R134, R135: 47k; R_0402_1005Metric
R137, R138, R139, R140, R141, R142, R143: 33R; R_0402_1005Metric
R144: 9.88k; R_0402_1005Metric; MPN RT0402DRD079K88L
R225: 10k; R_0402_1005Metric
TP18: SCL; TestPoint_Pad_D1.0mm
TP19: SDA; TestPoint_Pad_D1.0mm
TP20: GND; TestPoint_Pad_D1.0mm
TVS21, TVS22: D5V0S1U2LP-7B; D5V0S1U2LP7B; MPN M-621-D5V0S1U2LP-7B
TVS23: D3V3F8U9LP3810-7; Diodes_UDFN3810-9_TYPE_B; MPN D3V3F8U9LP3810-7
U8: TPS3823-33DBVR; SOT-23-5; MPN TPS3823-33DBVR
U9: TLC59711PWPR; SOP65P640X120-21N; MPN TLC59711PWPR

Connections:
3V3: BUZ1.2 (+), C93.1, C100.1, C102.1, C103.1, D1.1, J9.10, J9.12, L7.2, LD2.2 (A), LD3.2 (A), R103.1, R104.1, R106.1, R107.1, R108.1, R109.1, R110.1, R111.1, R120.1, R121.1, R122.1, U8.5 (VDD), U9.19 (VCC), U9.20 (VREG); also elsewhere on the board
4V_PARTICLE: J9.2, J9.4, J9.6, J9.8; also elsewhere on the board
5V: Q17.2 (S), R225.1; also elsewhere on the board
/05 - MCU/BUZZER_PWM: J9.23, Q16.1 (G), R126.2
/05 - MCU/LED_B_nEN: J9.65, R122.2, R124.2
/05 - MCU/LED_DI: J9.45, R141.1
/05 - MCU/LED_G_nEN: J9.63, R120.2, R127.2
/05 - MCU/LED_R_nEN: J9.61, R121.2, R125.2
/05 - MCU/LED_SCL: J9.43, R142.1
/05 - MCU/VUSB_EN: J9.16, Q17.3 (D)
/05 - MCU/uC_MODE: C95.1, J9.32, R113.2
/05 - MCU/uC_RST: C96.1, J9.34, R103.2, R112.2
/05 - MCU/uSD_SPI_CD: J9.62, R143.2
/05 - MCU/uSD_SPI_CS: J9.48, R137.2
/05 - MCU/uSD_SPI_MISO: J9.50, R140.2
/05 - MCU/uSD_SPI_MOSI: J9.52, R138.2
/05 - MCU/uSD_SPI_SCK: J9.54, R139.2
ADC_SPI_MISO: J9.66; also elsewhere on the board
ADC_SPI_MOSI: J9.40; also elsewhere on the board
ADC_SPI_SCK: J9.42; also elsewhere on the board
ADC_nDRDY: J9.37; also elsewhere on the board
EN_3V3#: J9.70; also elsewhere on the board
EN_3V3_GPS: J9.68; also elsewhere on the board
EN_3V3_QWICC: J9.35; also elsewhere on the board
EN_5V: J9.72; also elsewhere on the board
GND_DIGITAL: C93.2, C94.2, C95.2, C96.2, C97.2, C98.2, C99.2, C100.2, C101.2, C102.2, C103.2, C104.2, C105.2, J9.1, J9.3, J9.5, J9.7, J9.9, J9.15, J9.21, J9.39, J9.49, J9.56, J10.6 (VSS), J10.G1 (GND_1), J10.G2 (GND_2), J10.G3 (GND_3), J10.G4 (GND_4), PB2.3, PB2.4, PB3.3, PB3.4, Q16.2 (S), R115.2, R119.2, R123.2, R126.1, R136.2, R144.2, TP20.1, TVS21.2, TVS22.2, TVS23.3, U8.2 (GND), U9.2 (GND), U9.21 (PAD); also elsewhere on the board
I2C_SCL: J9.20, R107.2, TP18.1; also elsewhere on the board
I2C_SDA: J9.22, R108.2, TP19.1; also elsewhere on the board
IMU_INT: J9.33; also elsewhere on the board
NOISE_AN: R118.2; also elsewhere on the board
NOISE_INT: J9.41, R111.2; also elsewhere on the board
unnamed: BUZ1.3 (-), D1.2, Q16.3 (D)
unnamed: C97.1, J9.11, R116.1
unnamed: C98.1, J9.13, R117.1
unnamed: C99.1, J9.47, R118.1, R119.1
unnamed: C101.1, J9.74, R123.1
unnamed: J10.2 (CD/DAT3), R130.2, R137.1, TVS23.9
unnamed: J10.5 (CLK), R132.2, R139.1, TVS23.7
unnamed: J10.3 (CMD), R131.2, R138.1, TVS23.2
unnamed: J10.7 (DATA0), R133.2, R140.1, TVS23.4
unnamed: J10.8 (DATA1), R134.2, TVS23.6
unnamed: J10.1 (DATA2), R129.2, TVS23.1
unnamed: J10.CD, R135.2, R143.1, TVS23.5
unnamed: C104.1, C105.1, J10.4 (VDD), L7.1, R129.1, R130.1, R131.1, R132.1, R133.1, R134.1, R135.1, TVS23.8
unnamed: LD2.1 (B), R124.1
unnamed: LD2.4 (G), R127.1
unnamed: LD2.3 (R), R125.1
unnamed: LD3.1 (B), U9.5 (OUTB0)
unnamed: LD3.4 (G), U9.4 (OUTG0)
unnamed: LD3.3 (R), U9.3 (OUTR0)
unnamed: PB2.1, PB2.2, R104.2, R114.2, TVS21.1
unnamed: PB3.1, PB3.2, R106.2, R113.1, TVS22.1
unnamed: Q17.1 (G), R128.2, R136.1, R225.2
unnamed: R115.1, U8.4 (WDI)
unnamed: C94.1, R105.2, R114.1, U8.3 (~MR)
unnamed: R105.1, R112.1, U8.1 (~RST)
unnamed: R144.1, U9.1 (IREF)
unnamed: R142.2, U9.10 (SCKI)
unnamed: R141.2, U9.9 (SDTI)
UART_RX_GPS: J9.38, R110.2; also elsewhere on the board
UART_TX_GPS: J9.36, R109.2; also elsewhere on the board
USBD+: R116.2; also elsewhere on the board
USBD-: R117.2; also elsewhere on the board
nUSB_SINK_EN: J9.64, R128.1; also elsewhere on the board

Notes on the sheet:
Current consumption 3.3V: about 5mA per pin Need to set the drive strength to 9mA for these pins.
BUZZER
uSD-CARD
Bypass U8
Current consumption 3.3V: about 5mA per pin
RESET-MODE BUTTONS
PARTICLE MODULE STATUS RGB LED
RGB LED
Max sink current set resistor R=1.21(V)/Ioutpin(mA)x41 In this version: 5mA per pin
PARTICLE MODULE BX404X/B523
