Brunoxd23/Flatburn-BR/hardware/electronics/Flatburn_V5.kicad_pcb

## KiCad design hardware/electronics/Flatburn_V5.kicad_pcb (continued)

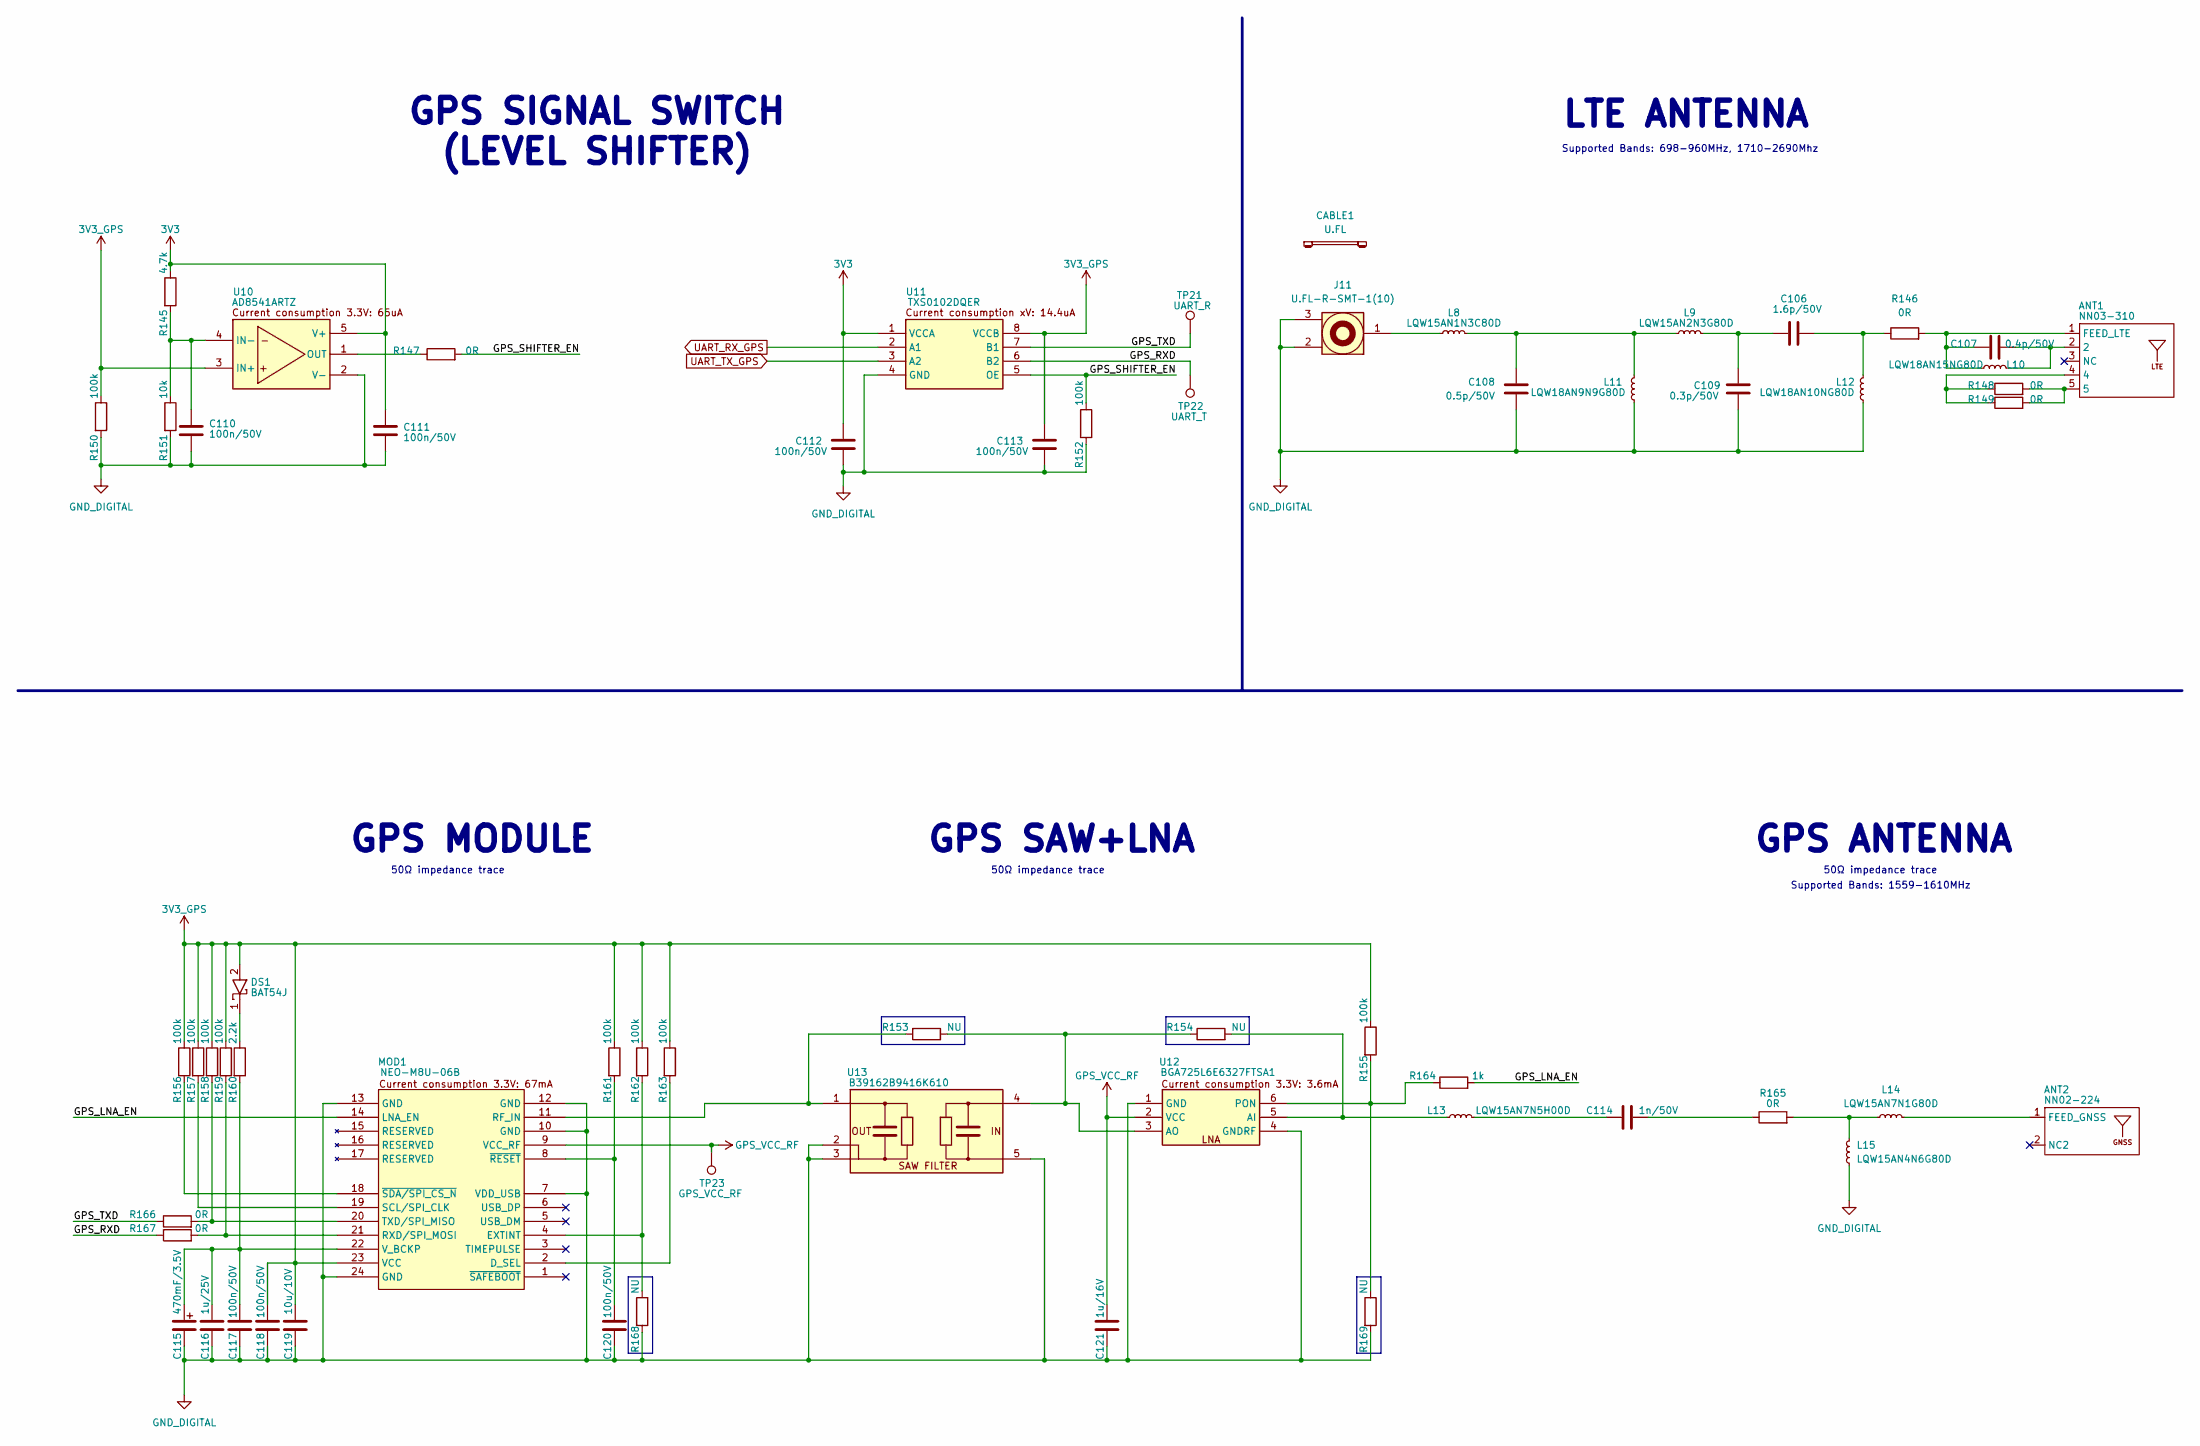
[picture p61: schematic gps-lte.kicad_sch]

Parts:
ANT1: NN03-310; XCVR_NN03-310; MPN NN03-310
ANT2: NN02-224; XCVR_NN02-224; MPN NN02-224
C106: 1.6p/50V; C_0402_1005Metric; MPN GJM1555C1H1R6WB01D
C107: 0.4p/50V; C_0402_1005Metric; MPN GJM1555C1HR40WB01D
C108: 0.5p/50V; C_0402_1005Metric; MPN GJM1555C1HR50WB01D
C109: 0.3p/50V; C_0402_1005Metric; MPN GJM1555C1HR30WB01D
C110, C111, C112, C113, C117, C118, C120: 100n/50V; C_0402_1005Metric
C114: 1n/50V; C_0402_1005Metric
C115: 470mF/3.5V; FCS0V474ZFTBR24_KEM; MPN FCS0V474ZFTBR24
C116: 1u/25V; C_0603_1608Metric; MPN CL10B105KA8NNNC
C119: 10u/10V; C_0603_1608Metric
C121: 1u/16V; C_0402_1005Metric; MPN GRM155C71C105KE11D
CABLE1: U.FL; MPN 2016493-1
DS1: BAT54J; D_SOD-323F; MPN BAT54J,115
J11: U.FL-R-SMT-1(10); MPN U.FL-R-SMT-1(10)
L8: LQW15AN1N3C80D; LQW15AN4N1G80D; MPN LQW15AN1N3C80D
L9: LQW15AN2N3G80D; MPN LQW15AN2N3G80D
L10: LQW18AN15NG80D; LQW18AN7N2G80D; MPN LQW18AN15NG80D
L11: LQW18AN9N9G80D; LQW18AN7N2G80D; MPN LQW18AN9N9G80D
L12: LQW18AN10NG80D; LQW18AN7N2G80D; MPN LQW18AN10NG80D
L13: LQW15AN7N5H00D; MPN LQW15AN7N5H00D
L14: LQW15AN7N1G80D; LQW15AN4N1G80D; MPN LQW15AN7N1G80D
L15: LQW15AN4N6G80D; LQW15AN4N1G80D; MPN LQW15AN4N6G80D
MOD1: NEO-M8U-06B; MOD24_NEO-M8U_UBL; MPN NEO-M8U-06B
R145: 4.7k; R_0402_1005Metric
R146, R148, R149, R165, R166, R167: 0R; R_0402_1005Metric; MPN MCS04020Z0000ZE000
R147: 0R; R_0402_1005Metric; MPN RCS04020000Z0ED
R150, R152, R155, R156, R157, R158, R159, R161, R162, R163: 100k; R_0402_1005Metric
R151: 10k; R_0402_1005Metric
R153, R154: NU; R_0402_1005Metric; MPN RCS04020000Z0ED
R160: 2.2k; R_0402_1005Metric
R164: 1k; R_0402_1005Metric
R168, R169: NU; R_0402_1005Metric
TP21: UART_R; TestPoint_Pad_D1.0mm
TP22: UART_T; TestPoint_Pad_D1.0mm
TP23: GPS_VCC_RF; TestPoint_Pad_D1.0mm
U10: AD8541ARTZ; SOT-23-5; MPN TXS0102DQER
U11: TXS0102DQER; SON35P100X140X40-8N; MPN TXS0102DQER
U12: BGA725L6E6327FTSA1; BGS12SN6E6327XTSA1; MPN BGA725L6E6327FTSA1
U13: B39162B9416K610; MPN B39162B9416K610

Connections:
3V3: C111.1, C112.1, R145.1, U10.5 (V+), U11.1 (VCCA); also elsewhere on the board
3V3_GPS: C113.1, C118.1, C119.1, DS1.2, MOD1.23 (VCC), R150.1, R155.1, R156.1, R157.1, R158.1, R159.1, R161.1, R162.1, R163.1, U10.3 (IN+), U11.8 (VCCB); also elsewhere on the board
/06 - GPS-LTE/GPS_LNA_EN: MOD1.14 (LNA_EN), R164.2
/06 - GPS-LTE/GPS_RXD: R167.1, TP22.1, U11.6 (B2)
/06 - GPS-LTE/GPS_SHIFTER_EN: R147.2, R152.1, U11.5 (OE)
/06 - GPS-LTE/GPS_TXD: R166.1, TP21.1, U11.7 (B1)
GND_DIGITAL: C108.2, C109.2, C110.2, C111.2, C112.2, C113.2, C115.2 (-), C116.2, C117.2, C118.2, C119.2, C120.2, C121.2, J11.2, J11.3, L11.2, L12.2, L15.2, MOD1.7 (VDD_USB), MOD1.10 (GND), MOD1.12 (GND), MOD1.13 (GND), MOD1.24 (GND), R150.2, R151.2, R152.2, R168.2, R169.2, U10.2 (V-), U11.4 (GND), U12.1 (GND), U12.4 (GNDRF), U13.2 (GND1), U13.3 (GND2), U13.5 (GND3); also elsewhere on the board
GPS_VCC_RF: C121.1, MOD1.9 (VCC_RF), TP23.1, U12.2 (VCC)
unnamed: ANT1.1 (FEED_LTE), C107.1, L10.2, R146.2
unnamed: ANT1.2, C107.2, L10.1
unnamed: ANT1.4, R148.1, R149.1
unnamed: ANT1.5, R148.2, R149.2
unnamed: ANT2.1 (FEED_GNSS), L14.1
unnamed: C106.1, C109.1, L9.1
unnamed: C106.2, L12.1, R146.1
unnamed: C108.1, L8.1, L9.2, L11.1
unnamed: C114.1, L13.1
unnamed: C114.2, R165.1
unnamed: C115.1 (+), C116.1, C117.1, MOD1.22 (V_BCKP), R160.2
unnamed: DS1.1, R160.1
unnamed: J11.1, L8.2
unnamed: L14.2, L15.1, R165.2
unnamed: MOD1.2 (D_SEL), R163.2
unnamed: MOD1.4 (EXTINT), R162.2, R168.1
unnamed: MOD1.11 (RF_IN), R153.1, U13.1 (OUT)
unnamed: MOD1.21 (RXD/SPI_MOSI), R159.2, R167.2
unnamed: MOD1.19 (SCL/SPI_CLK), R157.2
unnamed: MOD1.20 (TXD/SPI_MISO), R158.2, R166.2
unnamed: C120.1, MOD1.8 (~RESET), R161.2
unnamed: MOD1.18 (~SDA/SPI_CS_N), R156.2
unnamed: C110.1, R145.2, R151.1, U10.4 (IN-)
unnamed: R147.1, U10.1 (OUT)
unnamed: L13.2, R154.2, U12.5 (AI)
unnamed: R153.2, R154.1, U12.3 (AO), U13.4 (IN)
unnamed: R155.2, R164.1, R169.1, U12.6 (PON)
UART_RX_GPS: U11.2 (A1); also elsewhere on the board
UART_TX_GPS: U11.3 (A2); also elsewhere on the board

Notes on the sheet:
GPS SIGNAL SWITCH (LEVEL SHIFTER)
GPS SAW+LNA
GPS ANTENNA
50Ω impedance trace
LTE ANTENNA
GPS MODULE
Supported Bands: 698-960MHz, 1710-2690Mhz
Supported Bands: 1559-1610MHz

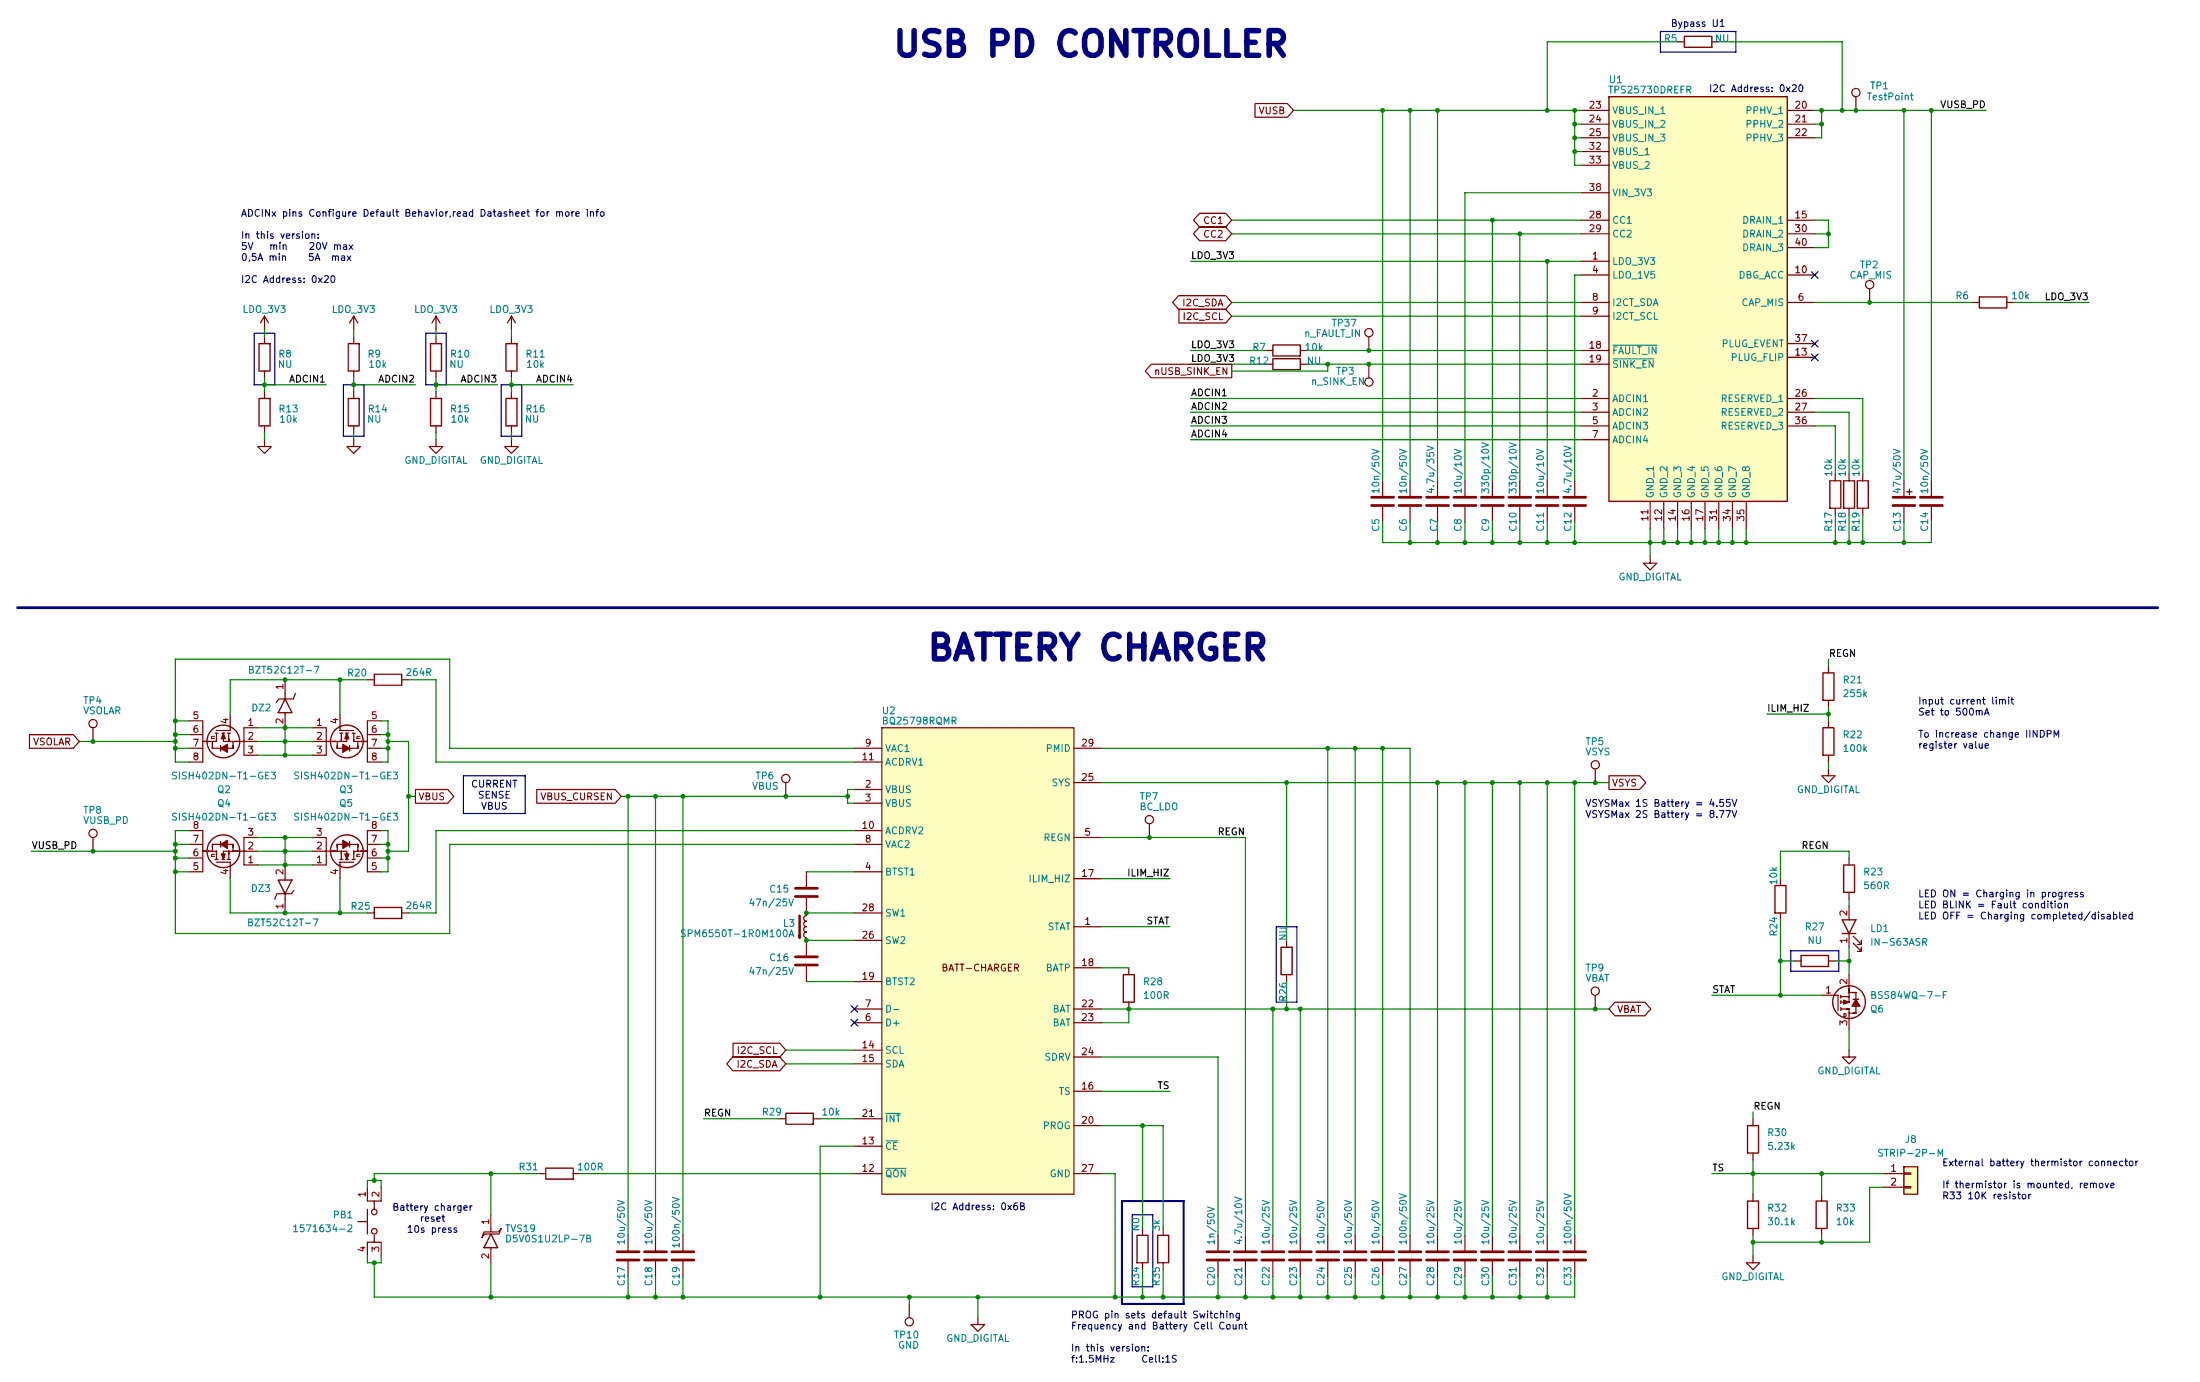
[picture p62: schematic power.kicad_sch]

Parts:
C5, C6, C14: 10n/50V; C_0402_1005Metric
C7: 4.7u/35V; C_0603_1608Metric
C8, C11: 10u/10V; C_0603_1608Metric
C9, C10: 330p/10V; C_0402_1005Metric; MPN C0402C331K8RACTU
C12, C21: 4.7u/10V; C_0603_1608Metric
C13: 47u/50V; CP_Elec_8x10; MPN GXC1H470MCQ1GS
C15, C16: 47n/25V; C_0402_1005Metric
C17, C18, C24, C25, C26: 10u/50V; C_0805_2012Metric; MPN GRM21BR61H106KE43L
C19, C27, C33: 100n/50V; C_0402_1005Metric
C20: 1n/50V; C_0402_1005Metric
C22, C23: 10u/25V; C_0603_1608Metric
C28, C29, C30, C31, C32: 10u/25V; C_0603_1608Metric; MPN GRM188R61E106KA73D
DZ2, DZ3: BZT52C12T-7; D_SOD-523; MPN BZT52C12T-7
J8: STRIP-2P-M; PinHeader_1x02_P2.54mm_Vertical
L3: SPM6550T-1R0M100A; SPM6550; MPN SPM6550T-1R0M100A
LD1: IN-S63ASR; INS63ASR; MPN IN-S63ASR
PB1: 1571634-2; 15716342; MPN 1571634-2
Q2, Q3, Q4, Q5: SISH402DN-T1-GE3; PowerPAK 121-8; MPN SISH402DN-T1-GE3
Q6: BSS84WQ-7-F; SOT-323_SC-70; MPN BSS84WQ-7-F
R5: NU; R_1206_3216Metric; MPN RCA12060000ZSEA
R6, R7, R9, R11, R13, R15, R17, R18, R19, R24, R29, R33: 10k; R_0402_1005Metric
R8, R10, R12, R14, R16: NU; R_0402_1005Metric
R20, R25: 264R; R_0603_1608Metric; MPN CRCW0603294RFKEA
R21: 255k; R_0402_1005Metric; MPN RC0402FR-07255KL
R22: 100k; R_0402_1005Metric
R23: 560R; R_0402_1005Metric
R26: NU; R_0603_1608Metric; MPN RCA06030000ZSEA
R27: NU; R_0402_1005Metric; MPN RCS04020000Z0ED
R28, R31: 100R; R_0402_1005Metric
R30: 5.23k; R_0402_1005Metric
R32: 30.1k; R_0402_1005Metric
R34: NU; R_0603_1608Metric
R35: 3k; R_0603_1608Metric
TP1: TestPoint; TestPoint_Pad_D1.0mm
TP2: CAP_MIS; TestPoint_Pad_D1.0mm
TP3: n_SINK_EN; TestPoint_Pad_D1.0mm
TP4: VSOLAR; TestPoint_Pad_D1.0mm
TP5: VSYS; TestPoint_Pad_D1.0mm
TP6: VBUS; TestPoint_Pad_D1.0mm
TP7: BC_LDO; TestPoint_Pad_D1.0mm
TP8: VUSB_PD; TestPoint_Pad_D1.0mm
TP9: VBAT; TestPoint_Pad_D1.0mm
TP10: GND; TestPoint_Pad_D1.0mm
TP37: n_FAULT_IN; TestPoint_Pad_D1.0mm
TVS19: D5V0S1U2LP-7B; D5V0S1U2LP7B; MPN M-621-D5V0S1U2LP-7B
U1: TPS25730DREFR; MPN TPS25730DREFR
U2: BQ25798RQMR; MPN BQ25798RQMR

Connections:
/03 - POWER/ADCIN1: R8.1, R13.2, U1.2 (ADCIN1)
/03 - POWER/ADCIN2: R9.1, R14.2, U1.3 (ADCIN2)
/03 - POWER/ADCIN3: R10.1, R15.2, U1.5 (ADCIN3)
/03 - POWER/ADCIN4: R11.1, R16.2, U1.7 (ADCIN4)
/03 - POWER/ILIM_HIZ: R21.2, R22.1, U2.17 (ILIM_HIZ)
/03 - POWER/REGN: C21.1, R21.1, R23.1, R24.1, R29.1, R30.1, TP7.1, U2.5 (REGN)
/03 - POWER/STAT: Q6.1 (G), R24.2, R27.1, U2.1 (STAT)
/03 - POWER/TS: J8.1, R30.2, R32.1, R33.1, U2.16 (TS)
/03 - POWER/VUSB_PD: C13.1, C14.1, Q4.5 (D), Q4.6 (D), Q4.7 (D), Q4.8 (D), Q4.9 (D), R5.2, TP1.1, TP8.1, U1.20 (PPHV_1), U1.21 (PPHV_2), U1.22 (PPHV_3), U1.41 (PPHV_4), U2.8 (VAC2)
CC1: C9.1, U1.28 (CC1); also elsewhere on the board
CC2: C10.1, U1.29 (CC2); also elsewhere on the board
GND_DIGITAL: C5.2, C6.2, C7.2, C8.2, C9.2, C10.2, C11.2, C12.2, C13.2, C14.2, C17.2, C18.2, C19.2, C20.2, C21.2, C22.2, C23.2, C24.2, C25.2, C26.2, C27.2, C28.2, C29.2, C30.2, C31.2, C32.2, C33.2, J8.2, PB1.3, PB1.4, Q6.3 (D), R13.1, R14.1, R15.1, R16.1, R17.2, R18.2, R19.2, R22.2, R32.2, R33.2, R34.2, R35.2, TP10.1, TVS19.2, U1.11 (GND_1), U1.12 (GND_2), U1.14 (GND_3), U1.16 (GND_4), U1.17 (GND_5), U1.31 (GND_6), U1.34 (GND_7), U1.35 (GND_8), U1.39 (GND_9), U1.44 (GND_10), U2.13 (~CE), U2.27 (GND); also elsewhere on the board
I2C_SCL: U1.9 (I2CT_SCL), U2.14 (SCL); also elsewhere on the board
I2C_SDA: U1.8 (I2CT_SDA), U2.15 (SDA); also elsewhere on the board
LDO_3V3: C11.1, R6.1, R7.1, R8.2, R9.2, R10.2, R11.2, R12.1, U1.1 (LDO_3V3)
unnamed: DZ2.2, Q2.1 (S), Q2.2 (S), Q2.3 (S), Q3.1 (S), Q3.2 (S), Q3.3 (S)
unnamed: DZ3.2, Q4.1 (S), Q4.2 (S), Q4.3 (S), Q5.1 (S), Q5.2 (S), Q5.3 (S)
unnamed: LD1.2 (A), R23.2
unnamed: LD1.1 (K), Q6.2 (S), R27.2
unnamed: PB1.1, PB1.2, R31.1, TVS19.1
unnamed: DZ2.1, Q2.4 (G), Q3.4 (G), R20.1
unnamed: DZ3.1, Q4.4 (G), Q5.4 (G), R25.1
unnamed: R6.2, TP2.1, U1.6 (CAP_MIS)
unnamed: U1.15 (DRAIN_1), U1.30 (DRAIN_2), U1.40 (DRAIN_3)
unnamed: C12.1, U1.4 (LDO_1V5)
unnamed: R19.1, U1.26 (RESERVED_1)
unnamed: R18.1, U1.27 (RESERVED_2)
unnamed: R17.1, U1.36 (RESERVED_3)
unnamed: C8.1, U1.38 (VIN_3V3)
unnamed: R7.2, TP37.1, U1.18 (~FAULT_IN)
unnamed: R20.2, U2.11 (ACDRV1)
unnamed: R25.2, U2.10 (ACDRV2)
unnamed: R28.1, U2.18 (BATP)
unnamed: C15.1, U2.4 (BTST1)
unnamed: C16.2, U2.19 (BTST2)
unnamed: C24.1, C25.1, C26.1, C27.1, U2.29 (PMID)
unnamed: R34.1, R35.1, U2.20 (PROG)
unnamed: C20.1, U2.24 (SDRV)
unnamed: C15.2, L3.1, U2.28 (SW1)
unnamed: C16.1, L3.2, U2.26 (SW2)
unnamed: R29.2, U2.21 (~INT)
unnamed: R31.2, U2.12 (~QON)
VBAT: C22.1, C23.1, R26.1, R28.2, TP9.1, U2.22 (BAT), U2.23 (BAT); also elsewhere on the board
VBUS: Q3.5 (D), Q3.6 (D), Q3.7 (D), Q3.8 (D), Q3.9 (D), Q5.5 (D), Q5.6 (D), Q5.7 (D), Q5.8 (D), Q5.9 (D); also elsewhere on the board
VBUS_CURSEN: C17.1, C18.1, C19.1, TP6.1, U2.2 (VBUS), U2.3 (VBUS); also elsewhere on the board
VSOLAR: Q2.5 (D), Q2.6 (D), Q2.7 (D), Q2.8 (D), Q2.9 (D), TP4.1, U2.9 (VAC1); also elsewhere on the board
VSYS: C28.1, C29.1, C30.1, C31.1, C32.1, C33.1, R26.2, TP5.1, U2.25 (SYS); also elsewhere on the board
VUSB: C5.1, C6.1, C7.1, R5.1, U1.23 (VBUS_IN_1), U1.24 (VBUS_IN_2), U1.25 (VBUS_IN_3), U1.32 (VBUS_1), U1.33 (VBUS_2), U1.42 (VBUS_IN_4), U1.43 (VBUS_3); also elsewhere on the board
nUSB_SINK_EN: R12.2, TP3.1, U1.19 (~SINK_EN); also elsewhere on the board

Notes on the sheet:
ADCINx pins Configure Default Behavior,read Datasheet for more info In this version: 5V min 20V max 0,5A min 5A max I2C Address: 0x20
CURRENT SENSE VBUS
PROG pin sets default Switching Frequency and Battery Cell Count In this version: f:1.5MHz Cell:1S
I2C Address: 0x6B
Bypass U1
External battery thermistor connector If thermistor is mounted, remove R33 10K resistor
BATTERY CHARGER
Battery charger reset 10s press
VSYSMax 1S Battery = 4.55V VSYSMax 2S Battery = 8.77V
Input current limit Set to 500mA To increase change IINDPM register value
LED ON = Charging in progress LED BLINK = Fault condition LED OFF = Charging completed/disabled
I2C Address: 0x20
USB PD CONTROLLER

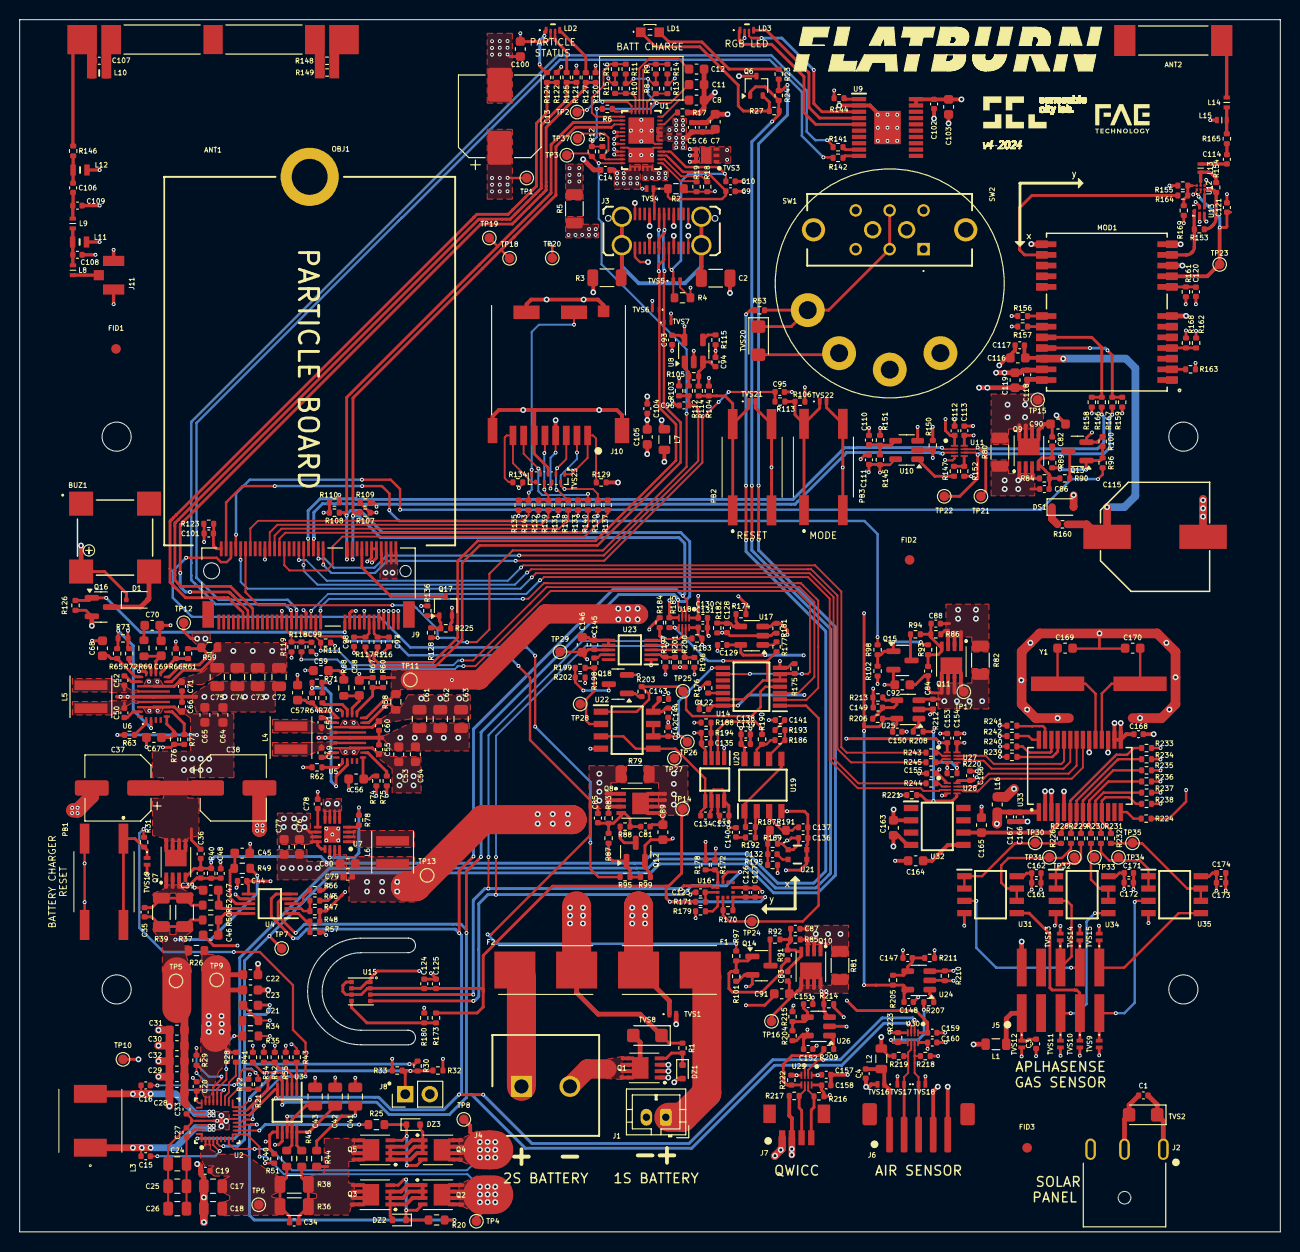
[picture p63: board Flatburn_V5.kicad_pcb from above]

Board: 4 copper layers, 130.0 x 125.0 mm, 586 parts (0 on the bottom side), 290 nets.
