Brunoxd23/Flatburn-BR/(commit log)

2026-10-01 fix(gas-sensor): fix ADS1256 CS pin conflict on SPI1 MISO and safe CS handling
2026-10-01 fix(gas-sensor): implement synchronous MUX+SYNC+WAKEUP readChannel and 100SPS sampling
2026-10-29 docs: add LED color status and behavior guide
2026-10-30 feat: scripts de compilacao/gravacao, suporte a 20 cols no downloader e inventario de placas
    - Adiciona scripts .bat para automacao de compilacao e gravacao USB (offline/online)
    - Atualiza flatburn_downloader.html para aceitar coletas de bancada (20 colunas sem SPS30) e producao (22 colunas)
    - Adiciona planilha profissional de inventario e controle de hardware (FlatBurn_Inventario_Pro.xlsx)
    - Atualiza documentacao no README.md e README.pt-BR.md com guia de LEDs, particle update e modo DFU
